trougnouf/SeniorDesign/Schematic/Sensewalk9000/FinalPCB/renders/SDMinFront.png

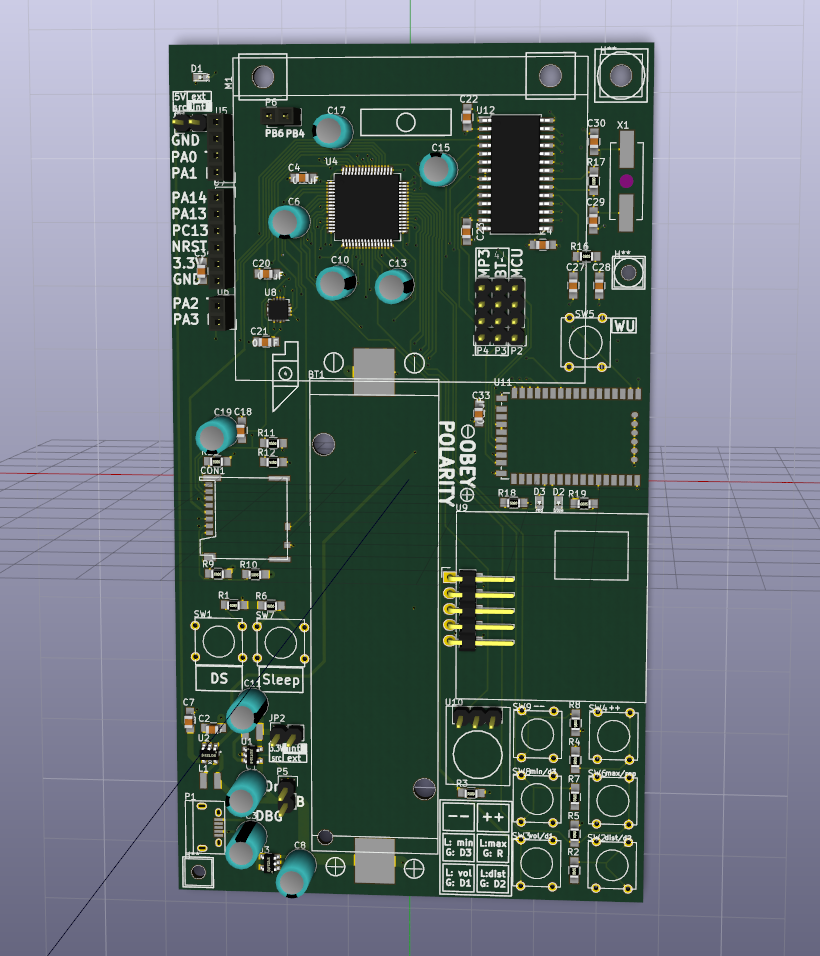
Schematic/Sensewalk9000/FinalPCB/renders/SDMinFront.png
