trougnouf/SeniorDesign/Schematic/Sensewalk9000/KiCAD/render/SDMinfinal.png

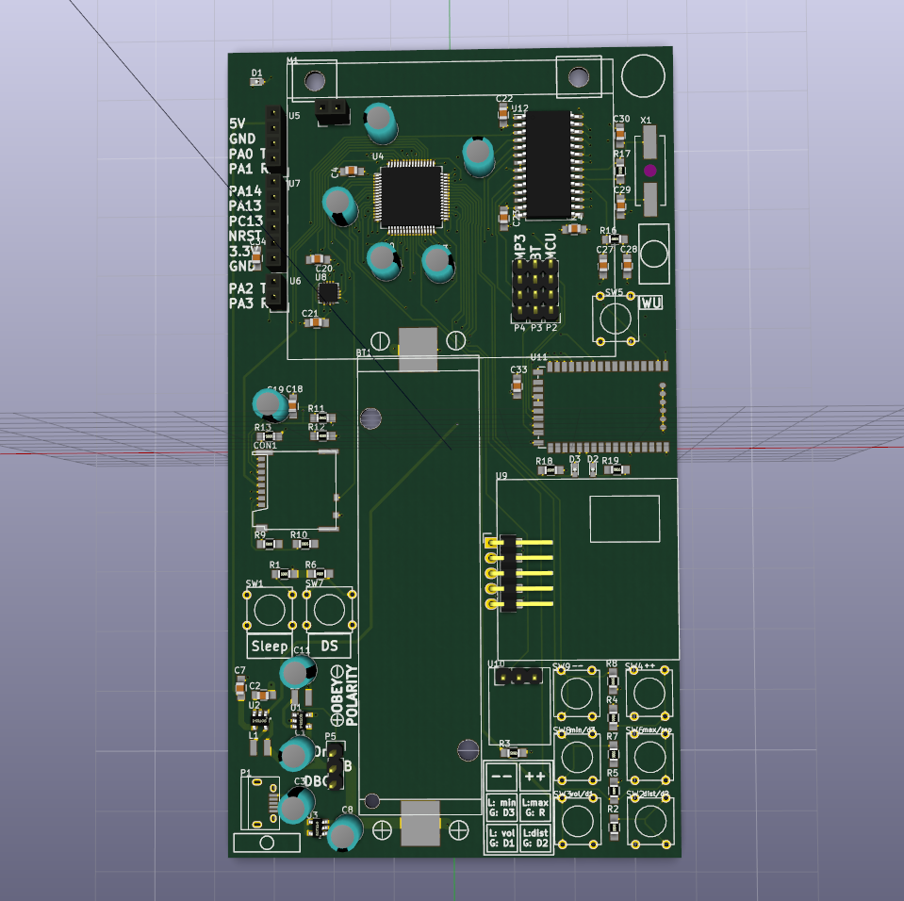
Schematic/Sensewalk9000/KiCAD/render/SDMinfinal.png
