trougnouf/SeniorDesign/Datasheets/MCU/README.txt

Installing STM32CubeMX:
# java -cp . com.izforge.izpack.installer.bootstrap.Installer
Launching STM32CubeMX:
$ cd /usr/local/STMicroelectronics/STM32Cube/STM32CubeMX/ && java -cp . 
com.st.microxplorer.maingui.IOConfigurator
