trougnouf/SeniorDesign/Schematic/Sensewalk9000/PINOUT.txt

MCU:		STMicroelectronics STM32L476RET6
Datash:	http://www.st.com/web/jp/resource/technical/document/datasheet/DM00108832.pdf
Notes:	Programming headers: See Table 8.1.1.1 in the paper
	Also needs one UART (two pin headers) for debugging
	// using the same UART as dev board: PA9 PB7 USART1)
Pinout:	{PB3, PA14, PA13, PC13,NRST}debugging, {PA2, PA3}USART2 (all female headers), {PC14, PC15, PH0, PH1, PA8, PA10, PA11, PA12}buttons/input, PB8 LED

Laser:		lightware SF10/A
Web:	http://www.lightware.co.za/shop/en/drone-altimeters/33-sf10a.html )
Notes:	MCU: UART (2pins) or i2c (fuck that), 5V power
	// Default settings: baudrate=19200, 8b
Pinout:	PA0, PA1 (all female headers)

GPS:		Sparksfun/Locosys LS20031
Web:	https://www.sparkfun.com/products/8975 )
Notes:	UART (2 pins)
Pinout:	PB7 (RX mcu/TX GPS), PA9 (TX MCU/RX GPS)

Codec:		STMicroelectronics STA013
Web:	http://www.pjrc.com/mp3/sta013.html
Notes:	
	MCU:	I2C control
			SDA
			SCL
		MP3 input
			SDI (data)
			SCKR (clock)
			DATA_REQ (ready)			GPIO
		Reset	RST					GPIO
	
	BT:	SDO (PCM Serial Data Output) to BT PCM_IN
		SCKT (PCM Serial Clock Output) to BT PCM_CLK
		LRCKT (Left/Right Channel Selection Clock) to BT PCM_SYNC
		OCLK	
	Clock:	Using 14.7456 MHz
BACKUP: Use MCU to generate audio
Pinout:	PC1 (I2C3_SDA), PC0 (I2C3_SCL), PA7 (SDI), PA5 (SCK), PA4(DATA_REQ), PB14 (RST)

Bluetooth: 	Sparksfun RN-52
Web:	https://www.sparkfun.com/products/11678
	https://www.sparkfun.com/products/12849
	https://learn.sparkfun.com/tutorials/rn-52-bluetooth-hookup-guide?_ga=1.111502852.1026932092.1454814409
Notes:	Sparksfun sells a RN-52 breakout board, they provide the Eagle files.
	When placing the breakout on a board, be sure that the antenna is hanging off the board as far as is will go.
	MCU:	UART_RTS, UART_CTS, UART_TX, UART_RX,
*		GPIO9: essential (command mode)
		optionally (but useful) GPIO7 to HIGH
		PWR_EN to HIGH
	mic:	3 (connect mic straight to MCU instead)
	misc:	optionally (useful) GPIO5 (VOL-UP active low) and GPIO10 (VOL-Down active low) connected to input button, (useless) 2 LEDs
	Codec:	SPI (4 pins) or PCM (4 pins), using PCM (see Codec above)
Pinout:	PA6 (MCU CTS / BT RTS), PC4 (MCU TX / BT RX), PC5 (MCU RX / BT TX), PB1 (MCU RTS / BT CTS), PB0 (GPIO9)

SD card:	Molex 503398-1892
Web:	https://www.digikey.com/product-detail/en/5033981892/WM11190CT-ND/5230912
Note:	See Table 6.1.11.1 in the paper
	SD 4bits wide bus
	3.3V -> 47Kohm -> {cmd,d3,d2,d1,d0}
Pinout:	PD2 (CMD), PC12 (CK), PC11 (D3), PC10 (D2), PC9 (D1), PC8 (D0), PA15 (Detect, optional)

Compass: 	Melexis MLX90393
dat:	http://www.melexis.com/Asset/MLX90393-Datasheet-DownloadLink-6427.aspx
	MCU:
		INT	GPIO
		CS
		SCLK
		MOSI
		MISO
		TRIG
		(A0/A1 to GND)
Pinout:	PC2 (MISO), PB15 (MOSI), PB10 (SCLK), PB9 (CS), PB12 (INT), PB13 (TRIG)

Microphone:	MEMS Microphone - INMP401
TODO:	check for additional circuitry req.
Web:	https://www.sparkfun.com/products/10028
	MCU: 1 analog pin (ADC)
	VDD, GND
Pinout:	PC3
