trougnouf/SeniorDesign/Schematic/Sensewalk9000/stm32cubemx/PinoutMinimal.txt

Configuration	PinoutMinimal
STM32CubeMX 	4.13.0
Date	02/07/2016
MCU	STM32L476RETx

PERIPHERALS	MODES	FUNCTIONS	PINS
ADC1	IN1 Single-ended	ADC1_IN1	PC0
I2C1	I2C	I2C1_SCL	PB6
I2C1	I2C	I2C1_SDA	PB9
SDMMC1	SD 4 bits Wide bus	SDMMC1_CK	PC12
SDMMC1	SD 4 bits Wide bus	SDMMC1_CMD	PD2
SDMMC1	SD 4 bits Wide bus	SDMMC1_D0	PC8
SDMMC1	SD 4 bits Wide bus	SDMMC1_D1	PC9
SDMMC1	SD 4 bits Wide bus	SDMMC1_D2	PC10
SDMMC1	SD 4 bits Wide bus	SDMMC1_D3	PC11
SPI1	Transmit Only Master	SPI1_MOSI	PA7
SPI1	Transmit Only Master	SPI1_SCK	PA5
SPI2	Full-Duplex Master	SPI2_MISO	PC2
SPI2	Full-Duplex Master	SPI2_MOSI	PC3
SPI2	Full-Duplex Master	SPI2_SCK	PB10
SYS	SWD and Asynchronous Trace	SYS_JTMS-SWDIO	PA13
SYS	SWD and Asynchronous Trace	SYS_JTCK-SWCLK	PA14
SYS	SWD and Asynchronous Trace	SYS_JTDO-SWO	PB3
SYS	SYS-WakeUp2	SYS_WKUP2	PC13
SYS	SysTick	SYS_VS_Systick	VP_SYS_VS_Systick
UART4	Asynchronous	UART4_RX	PA1
UART4	Asynchronous	UART4_TX	PA0
USART1	Asynchronous	USART1_RX	PB7
USART1	Asynchronous	USART1_TX	PA9
USART2	Asynchronous	USART2_RX	PA3
USART2	Asynchronous	USART2_TX	PA2
USART3	Asynchronous	USART3_RX	PC5
USART3	Asynchronous	USART3_TX	PC4
USART3	CTS/RTS	USART3_CTS	PA6
USART3	CTS/RTS	USART3_RTS	PB1

Pin Nb	PINs	FUNCTIONs	LABELs
2	PC13	SYS_WKUP2	
3	PC14/OSC32_IN	GPIO_Input	
4	PC15/OSC32_OUT	GPIO_Input	
5	PH0/OSC_IN	GPIO_Input	
6	PH1/OSC_OUT	GPIO_Input	
8	PC0	ADC1_IN1	ADC1_IN1_Mic
10	PC2	SPI2_MISO	SPI2_MISO_Compass
11	PC3	SPI2_MOSI	SPI2_MOSI_Compass
14	PA0	UART4_TX	UART4_TX_Laser
15	PA1	UART4_RX	UART4_RX_Laser
16	PA2	USART2_TX	USART2_TX_PC
17	PA3	USART2_RX	USART2_RX_PC
20	PA4	GPIO_Input	DATA_REQ_Codec
21	PA5	SPI1_SCK	SPI1_SCK_Codec
22	PA6	USART3_CTS	USART3_CTS_BT
23	PA7	SPI1_MOSI	SPI1_MOSI_Codec
24	PC4	USART3_TX	USART3_TX_BT
25	PC5	USART3_RX	USART3_RX_BT
26	PB0	GPIO_Output	GPIO9_BT
27	PB1	USART3_RTS	USART3_RTS_BT
29	PB10	SPI2_SCK	SPI2_SCK_Compass
33	PB12	GPIO_Input	INT1_Compass
34	PB13	GPIO_Input	INT2_Compass
35	PB14	GPIO_Output	RST_Codec
39	PC8	SDMMC1_D0	
40	PC9	SDMMC1_D1	
41	PA8	GPIO_Input	
42	PA9	USART1_TX	USART1_TX_GPS
43	PA10	GPIO_Input	
44	PA11	GPIO_Input	
45	PA12	GPIO_Input	
46	PA13	SYS_JTMS-SWDIO	
49	PA14	SYS_JTCK-SWCLK	
50	PA15	GPIO_Input	SDMMC1_Detect
51	PC10	SDMMC1_D2	
52	PC11	SDMMC1_D3	
53	PC12	SDMMC1_CK	
54	PD2	SDMMC1_CMD	
55	PB3	SYS_JTDO-SWO	
58	PB6	I2C1_SCL	I2C1_SCL_Codec
59	PB7	USART1_RX	USART1_RX_GPS
62	PB9	I2C1_SDA	I2C1_SDA_Codec

SOFTWARE PROJECT

Project Settings : 
Project Name : PinoutMinimal
Project Folder : /orb/Dev/SeniorDesign/Schematic/Minimal/PinoutMinimal
Toolchain / IDE : SW4STM32
Firmware Package Name and Version : STM32Cube FW_L4 V1.3.0

Code Generation Settings : 
STM32Cube Firmware Library Package : Copy all used libraries into the project folder
Generate peripheral initialization as a pair of '.c/.h' files per IP : No
Backup previously generated files when re-generating : No
Delete previously generated files when not re-generated : Yes
Set all free pins as analog (to optimize the power consumption) : No

Toolchains Settings : 
Compiler Optimizations : Balanced Size/Speed
