trougnouf/SeniorDesign/Documentation/2016-02-12-Presentation/SDCP.odt

# SenseWalk 2.0

Ross Applegate, Chad Borgelin, Benoit Brummer, and Diego Merida

### Dept. of Electrical Engineering and Computer Science, University of Central Florida, Orlando, Florida, 32816-2450

Abstract — Everyday, engineers focus on ways of improving the quality of living for everyone around them. Whether it’s improving transportation, creating new and safer energy resources, or designing more efficient ways to complete a task, their goal is to establish something that will be both innovative and of practical use for everyone. This paper’s primary focus is on the application of creating a device that will benefit those who are classified as visually impaired. While there are devices that target this niche of people, none has the capability of greatly reducing the user’s need to depend on someone else. The goal of this device is to greatly enhance the independency of the users, while providing them support to navigate around safely and efficiently.

### Index Terms — Lasers

### I. Introduction

Detailed analysis of the research, design, coding, and testing procedures related to the navigation system for the visually impaired is thoroughly provided. The project description includes goals, motivators, and hardware and software system specifications. The foundation for the mission statement of this design is to aid the visually impaired with their travel on a daily basis. The cane is an alternative to seeing-eye dogs or personal assistants, as it doesn’t compromise independent mobility. It allows the individual to blend into society with little assistance or help from others. With a cane, they are able to be independent and not rely on others for their everyday needs. However, danger is still prevalent in the person’s inability to distinguish between safe paths and hazardous paths, thus presenting the opportunity for the cane to be perfected by modern-day technology. Many people in their day-to-day lives have a typical, established routine that may include routes going from home to work or going from one classroom to another.

For those that are visually impaired and use a cane, it would be deemed useful to have a device which stores some of their frequently used routes. The GPS in SenseWalk 2.0 will keep track of the user as they go about a certain route that they have selected and instructions transmitted will notify the user constantly of where they currently are and what direction they need to impart soon. Even when the option of using a stored route is not selected, the GPS can help the user in keeping them informed of their current whereabouts by announcing approaching streets and intersections. The GPS will need to use a software that offers access to maps and geographical points in order to configure routes and pinpoint the user's location in real-time.

### II. Microcontroller

We chose the STMicroelectronics STM32 F7 microcontroller because it is the most affordable of only two Cortex-M7 microcontrollers available at the time of our research.

The Cortex-M7 series can run at speeds of up to 300 MHz. The current STM32 F7 has a clock speed of 216 MHz, it contains an FPU and can interface with external SDRAM memory. This allows it to bridge the performance gap between microcontrollers and microprocessors, allowing us in theory to perform computer vision on a microcontroller.

The STM32 series MCUs can be programmed with a $20 STLinkV2 in-circuit debugger/programmer, and development boards cost range from $10 to $50. All development can be performed using free and open-source software, specifically the GCC compiler, GDB debugger, and OpenOCD on-chip debugger. These software are all prepackaged by STMicroelectronics in a ready-to-use Eclipse plugin called OpenSTM32.

SDRAM and flash were not incorporated into the final design, therefore SenseWalk 2 is physically incompatible with voice recognition and computer vision. A simpler alternative board, Sensewalk 9000, was created with a lower-performance microcontroller, the ultra-low-power 80MHz STMicroelectronics STM32 L4. SenseWalk 9000 runs off a replaceable 18650 battery and charges from a standard micro-USB port.

### III. Audio Subsystem

Information is transmitted to the user through a Bluetooth headset. To achieve this, an audio file stored on the SD card is read by the microcontroller, the compressed audio is transferred to a hardware MP3 decoder, which then sends a raw audio waveform to the bluetooth module.

The STMicroelectronics STA013 MPEG 2.5 audio decoder was chosen because it is widely available, well-documented, and comes in an easy to prototype 28-SO package. The STA013 uses I2C to communicate with the microcontroller, SPI to receive compressed audio files, and I2S to send out decompressed audio.

Alternatively, the Sensewalk 9000 features a series of jumpers which can be used to switch between using an external hardware decoder, or processing the audio in software and sending it directly from the microcontroller to the Bluetooth module. Generating an I2S signal on the microcontroller involves more complicated software, but it comes with a significant cost-benefit (~$12). The power implication of doing software audio decoding remains unknown until further testing can be done. The microcontroller would use more power while performing such heavy computations, but the processing cost may be lower than that added by powering an external ASIC.

### IV. Filesystem

The filesystem is used by all subsystems. The GPS first reads all directions from a text-file which is then saved in memory. Both the laser and the GPS read compressed sound files that are then sent to the user as audio feedback.

All information is stored on a Micro-SD card using the Fat32 file-system which allows for easy modification from most computers. The open-source FatFs driver is used along with an SDIO physical interface (1-bit wide on SW2, 4-bit bus on SW9000).

### V. Bluetooth Communication

Bluetooth transmission plays an integral role in communicating directions from the device to the user. It is the gateway that will relate information given from the user’s command to the device, then the response from the device back to the user. It will be required of the controller to obtain instructions from the GPS and transmit the set of instructions on a given route into an audio signal for the user to receive and hear through their headset.

A range of up to 10 meters with a Class 1 device is needed, since the proximity between the user and the device is very small (the cane will be in their hands at all times during use). Bluetooth uses a radio frequency that operates on the 2.4 GHz unlicensed (industrial, scientific, and medical) ISM band of radio frequencies.

This permits the console to communicate with many possible Bluetooth-enabled devices if necessary. Typically, a Bluetooth device can establish a connection with up to 8 devices all at the same time. This means that any Bluetooth-capable headset should be able to effortlessly interface with the cane.

VI. Distance Detection

One of the main goals from the previous version of the device was to improve most of technologies implemented on it and the most important features for a visually impaired is the feature of obstacle detection, for this reason we will analyze several technologies and compare them in order to use buy the sensor that will meet and surpass all the requirement for SenseWalk 2.0. There are many types of sensor out there in the market and selecting the right sensor is very important but a very difficult task.

One of the main key sub-systems which SenseWalk2.0 implements, is an object proximity detection system. It is designed to be very helpful for the visually impaired user to have access to information relating to approaching or stationary objects within the user's walking path. Because SenseWalk 2.0 users are unable to visually observe approaching objects, SenseWalk 2.0 detects this information and audibly relays it to the user through Bluetooth.

VII. GPS

The heart of the project is the GPS since this component will receive the user’s current position and measure the distance and direction to the next point, this is why the GPS module selection was essential. An appropriate module was chosen in order to ensure all “SenseWalk” requirements were met or exceeded. Proper selection between GPS cards guaranteed that accurate, reliable data is being received that can be read on the microcontroller. GPS connection with the satellites is known to weaken when inside buildings or as one gets closer to a building but the module locosys ls 20031 offers 66 channels which is pretty helpful to get signal faster in the circumstances mentioned above. This means that whatever routes the user chooses to load, they must be situated outdoors. As a user enters a building,GPS connection will be lost and will be reset once they return outdoors.

VIII. Magnetometer

The use of GPS in SenseWalk 2.0 requires the need for a compass to help in the navigation of the user. Without a compass, the orientation and direction the user is facing would be unknown to the device and could potentially cause errors in real-time direction and decision making. In order to know what direction the user is facing we need to implement a compass module or a magnetometer into the project. The earth is like a giant magnet with a north and a south pole and it has a magnetic field all around it.

The strength of the magnetic field will vary with location and orientation. The way a compass module works is by detecting the earth’s natural magnetic field, the earth has an iron core that is part liquid and part solid crystal due to the gravitational pressure and the movements in the liquid outer core is what produces the Earth’s magnetic field. The module that will measure the magnetic field in three directions or axes, labeled as X, Y, Z.

We use the Melexis MLX90393 magnetometer because it comes in a QFN16 3x3mm package and offers both an SPI and I2C interface. This made it easier to prototype and implement than competing models which typically have a 0.4mm pitch (as opposed to 0.5mm) and lack SPI connectivity.

IX. Power

SenseWalk 2.0 required DC-DC linear and switching regulators and also an AC-DC switching converter. All DC-DC regulators convert the input voltage from the lithium ion battery to the required output voltage. There were a couple different options in the charging aspect ultimately allowing the solar to run simultaneously with DC-DC charging system is what was chosen. Allowing them to run at the same time allowed for a simpler circuit design with less parts. The (BQ24123) is the DC-DC charging circuit. The BQ25504 is a power management board where it allows two different inputs to be regulated.

There were a few factors in picking a battery, which included the weight of the battery and length of run time. Light weight batteries with a long run time are good, but only in the short term. It was preferred to utilize heavy bulky types of batteries which provides a long run time, as well as a good overall life cycle. Ultimately we found the best of both worlds with a lithium ion battery. Lithium batteries are lightweight and high efficiency, but with that comes a higher price tag.

SenseWalk 2.0 operates on a rechargeable type battery. This required an AC-DC converter to recharge the battery which will be bought; also this required a DC-DC converter to regulate the battery voltage to the required load voltage. Below is the design schematic of the DC-DC charger.

The device also has a solar panel integrated on it, in order to help keep the device charged while it is in use, this will reduce the need for the user to search for a power outlet; a task which can be very challenging for the visually impaired.

X. Standards

With the large increase in global population, energy demands are at an all-time high. The number of electronics per person has also largely increased. With the increase in power demand and a limited supply of power generation, efficient electronics have become a necessity. Governments and green environmental organizations have established energy efficiency standards.

ENERGY STAR has become the largest most recognized international standard for energy efficient consumer products. The standard originated in the United States in 1992 when it was created by the Environmental Protection Agency and the Department of Energy. Depending on the specific device, there are standard requirements for a consumer product to be labeled with the ENERGY STAR mark. A specific set of guidelines and requirements has been constructed in order for an AC-DC power supply to be labeled with the ENERGY STAR mark. A full chart of Energy-Efficiency requirements can be found at http://www.energystar.gov/.

Bluetooth uses the Industrial Scientific and Medical (ISM) band, which is free to use in most countries. The regulators expect lots of devices to be using the same spectrum, so they have set out rules for using ISM bandwidth to make sure that devices can share the bandwidth.

The rules state that you must spread the power of your transmissions across the ISM band somehow. Two main methods are used for spreading out the power: direct sequence spread spectrum (DSSS) and frequency-hopping spread spectrum.

Direct sequence spread spectrum smears a transmission across a wide range of frequencies at low power. Frequency-hopping spread spectrum uses a small bandwidth but changes (or hops) frequency after each packet. Bluetooth uses frequency-hopping spread spectrum. There are 79 channels of 1 MHz each; after each transmit or receive, devices hop to a new channel.

### Acknowledgement

The authors would like to acknowledge the support and guidance of Dr. Samuel Richie and Dr. Lei Wei, first and foremost, for the extreme lengths he has gone to in educating and guiding our research and meeting with the group to from time to time to keep track of overall progress and group resolve.

We also extend thanks to Boeing and Leidos for the funding and amazing support to help create the SenseWalk 2.0 device, as well as their generous and continued support of engineering at the University of Central Florida in general.

And lastly, we offer our thanks and gratitude to the professors who have so kindly agreed to ta

ke time out of their busy schedule in order to review our project, which we have so diligently worked hard on.

### Biography

Ross Applegate is currently a senior at the University of Central Florida. He plans to graduate with his Bachelor’s of Science in Electrical Engineering in May of 2016.

Chad Borgelin is currently a senior at the University of Central Florida. He plans to graduate with his Bachelor’s of Science in Computer Engineering in May of 2016. He plans to potentially attend the University of Central Florida for his graduate studies in Master of Business Administration (MBA).

Benoit Brummer is currently a senior at the University of Central Florida. He plans to graduate with his Bachelor’s of Science in Computer Engineering in May of 2016 and pursue a MS CS in Belgium. Benoit currently enjoys working with embedded systems and artificial intelligence. He will one day start the trougnouf company.

Diego Merida is currently a senior at the University of Central Florida. He plans to graduate with his Bachelor’s of Science in Computer Engineering in May of 2016. He plans to attend the University of Central Florida for graduate studies in the field of Computer Networks and Computer Security
