trougnouf/SeniorDesign/Documentation/2016-04-21-board/SenseWalk_2-schematic.pdf

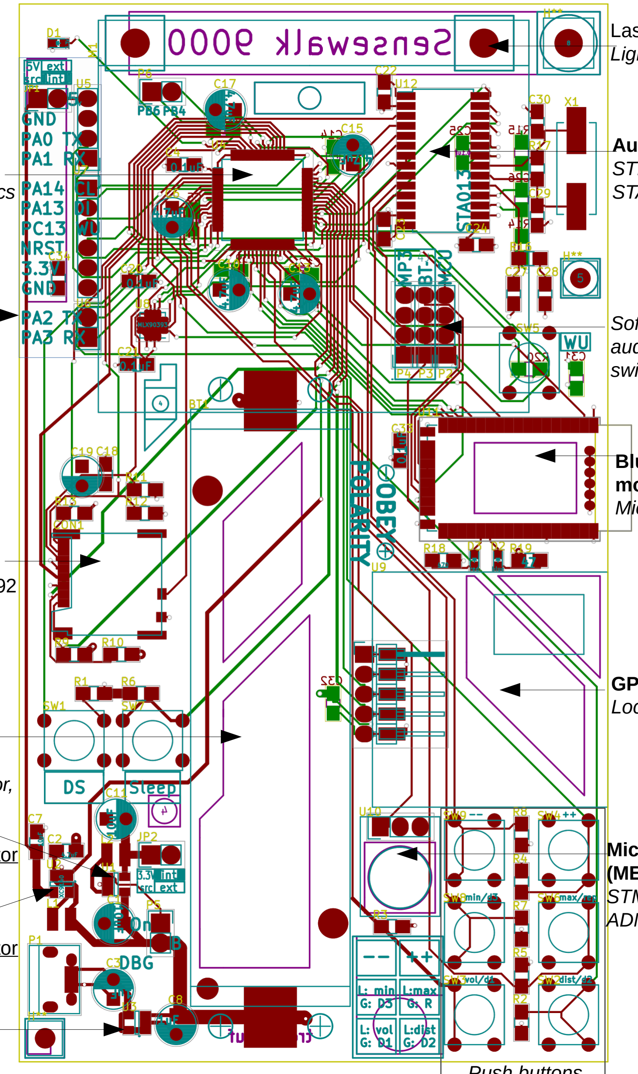
[picture p32: figure]

Laser / mount
LightWare SF10-A

Software/hardware
audio decoder
switch

Bluetooth 3.0
module
Microchip RN52

GPS module
Locosys LS20031

Push buttons

Microphone
(MEMS)
STMicroelectronics
ADMP401

Programming
/debugging
headers

Power
subsystem
Lithium-ion
rechargeable
battery
18650 form-factor,
user-replaceable
3.3V DC-DC
switching regulator
Diodes Inc.
PAM2301
5V DC-DC
switching regulator
Skyworks
AAT1217
Battery
management
(USB charger)
Microchip
MCP73811

# Sensewalk 9000 PCB layout

Microcontroller
STMicroelectronics
STM32L476

MicroSD socket
Molex 5033981892

Audio decoder
STMicroelectronics
STA013
