trougnouf/SeniorDesign/Documentation/2016-04-21-board/SenseWalk_2-software.pdf

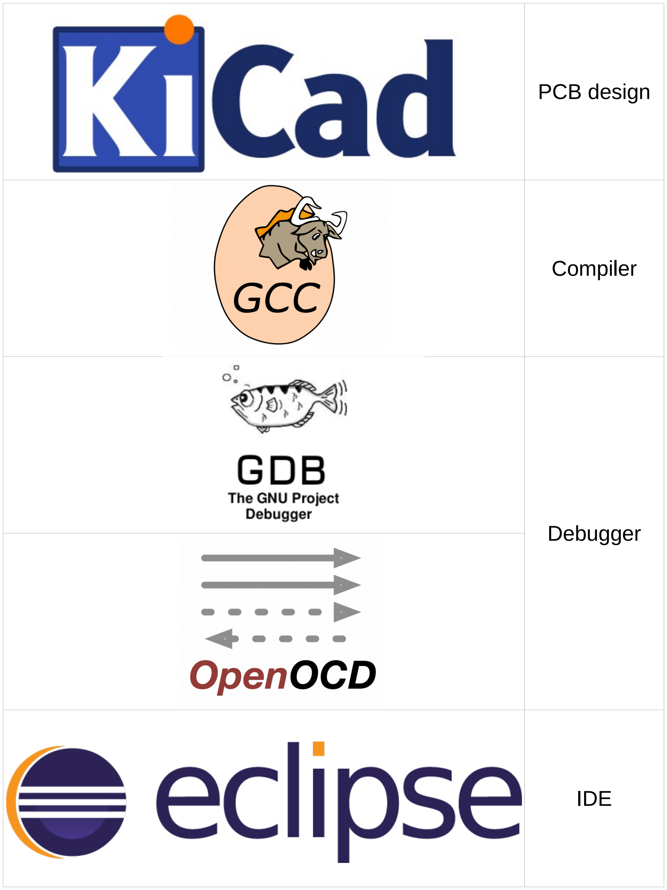
[picture p35: page 1]

PCB design

Compiler

Debugger

IDE
