trougnouf/SeniorDesign/Data/Compass/misc/misc/tek00000.png

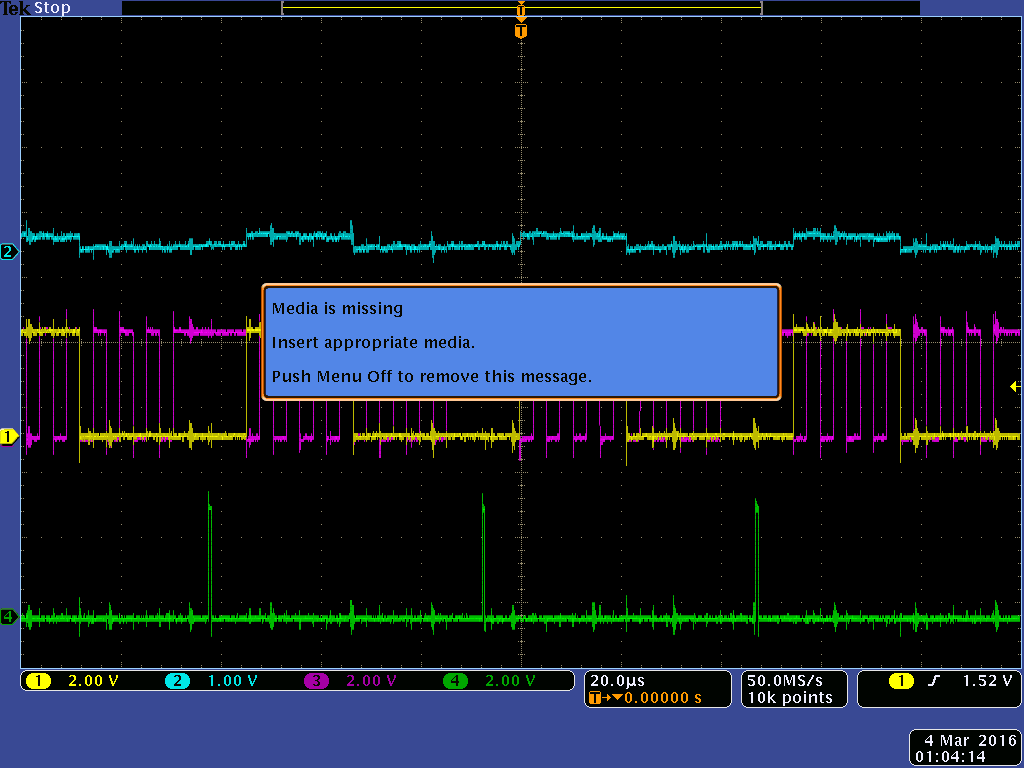
Data/Compass/misc/misc/tek00000.png
