trougnouf/SeniorDesign/Data/Compass/misc/misc/tek00003.png

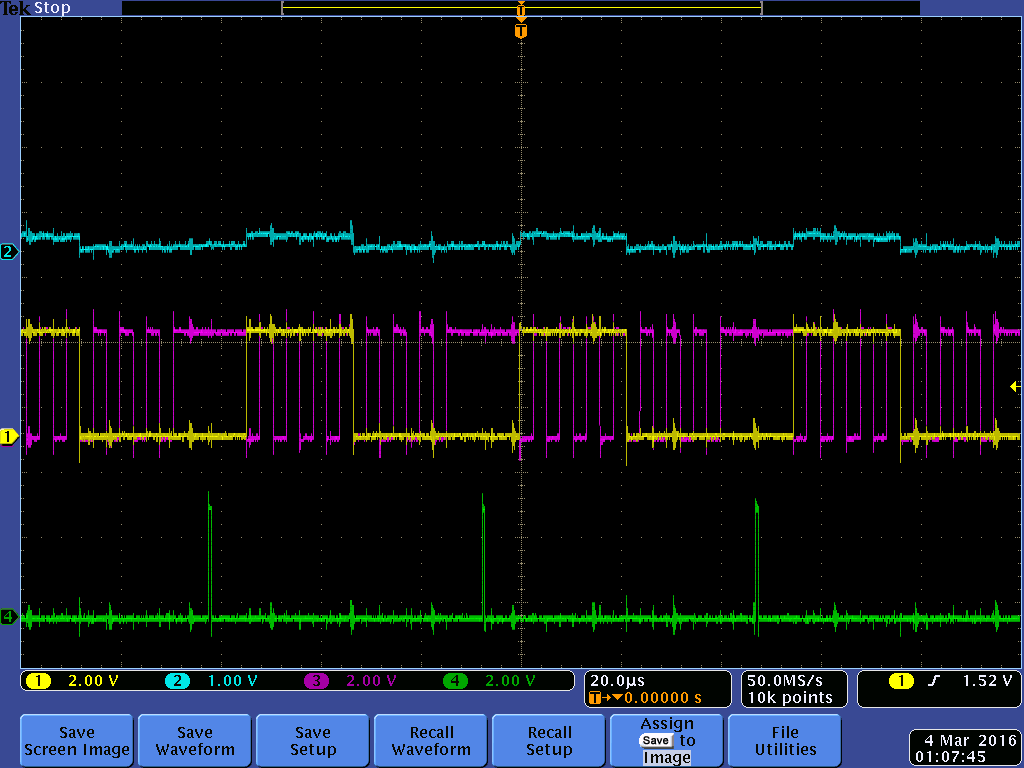
Data/Compass/misc/misc/tek00003.png
