trougnouf/SeniorDesign/Data/Compass/misc/misc/tek00004.png

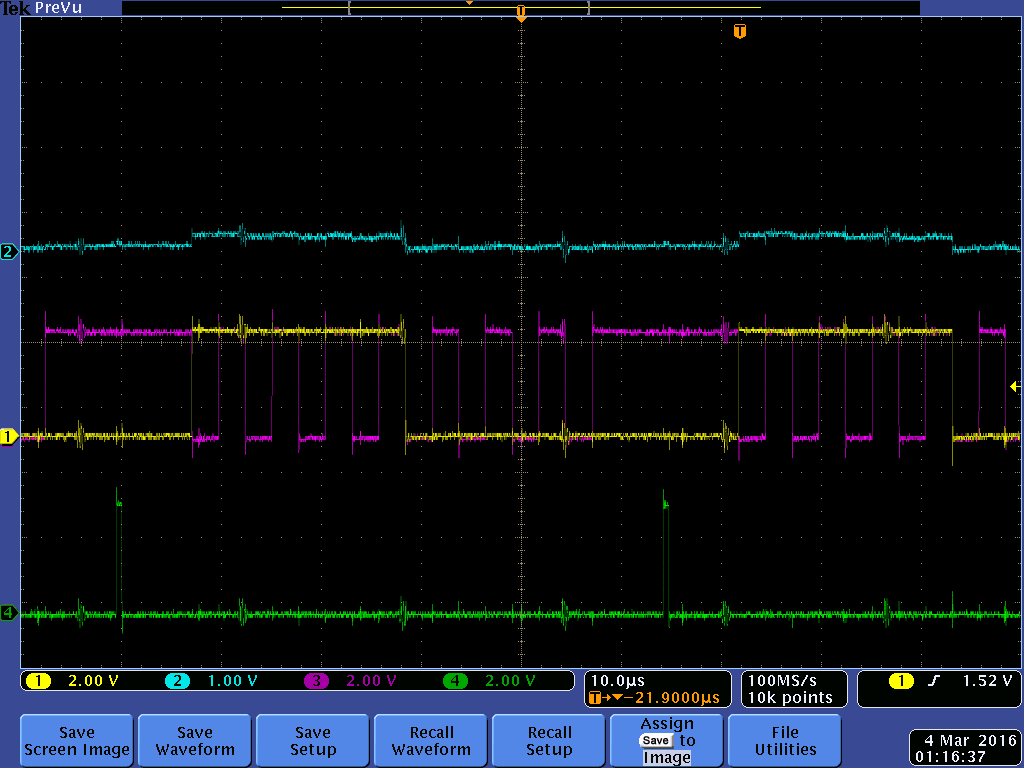
Data/Compass/misc/misc/tek00004.png
