trougnouf/SeniorDesign/Data/Compass/misc/misc/tek00005.png

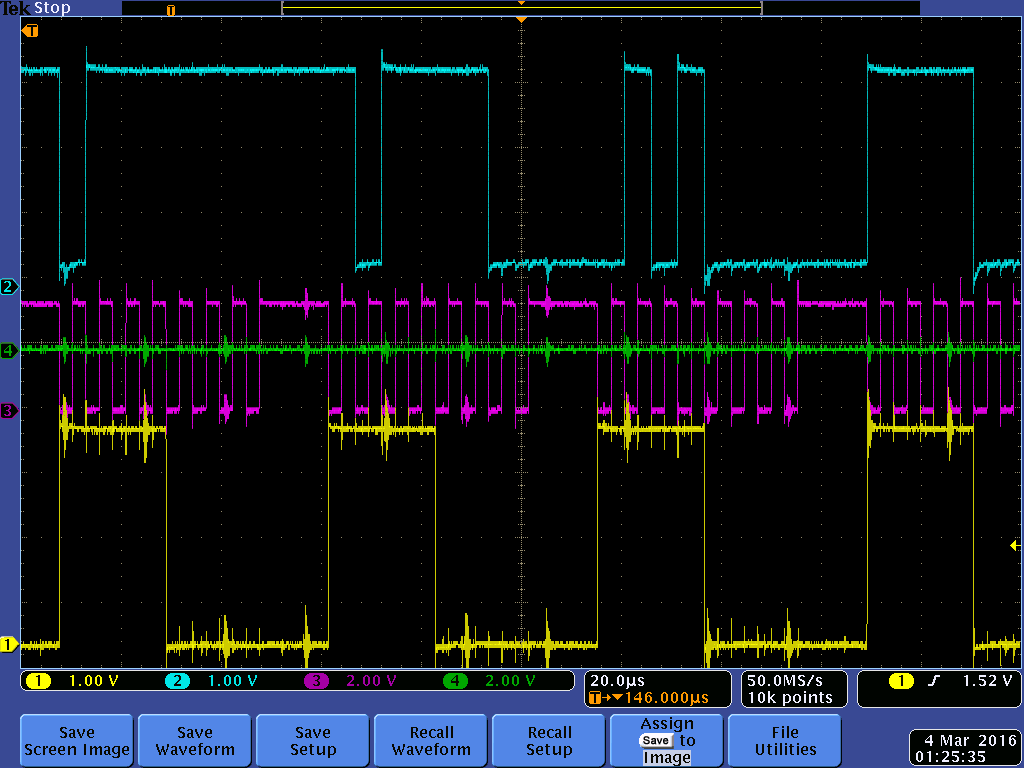
Data/Compass/misc/misc/tek00005.png
