trougnouf/SeniorDesign/Data/Compass/misc/misc/tek00006.png

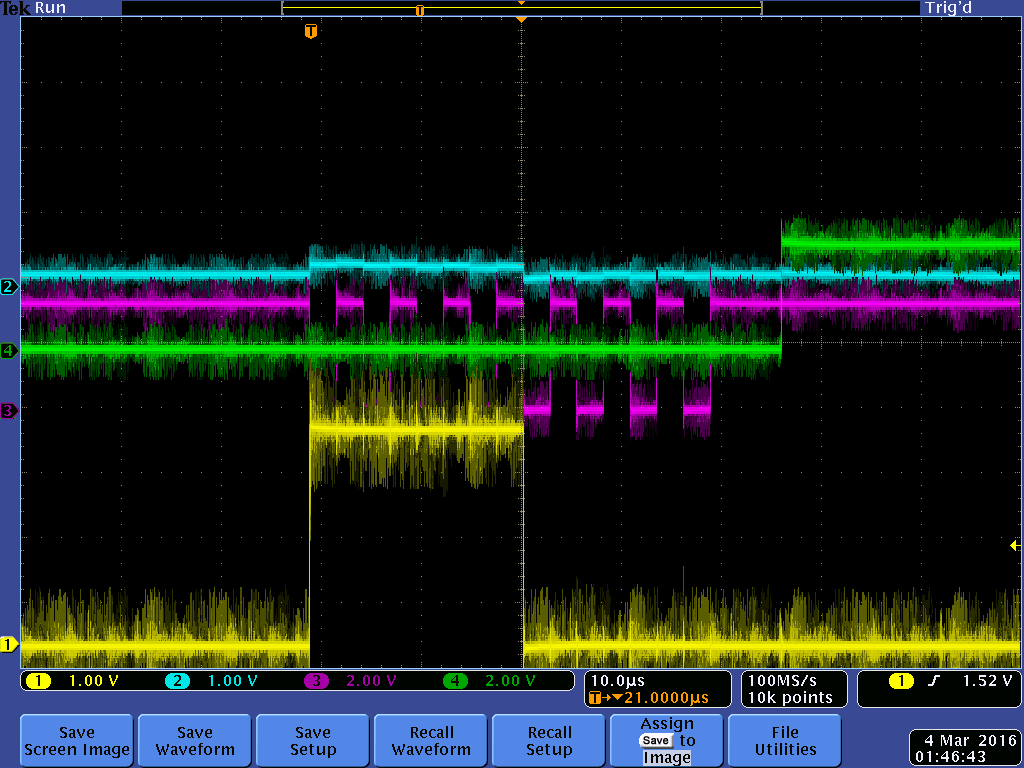
Data/Compass/misc/misc/tek00006.png
