trougnouf/SeniorDesign/Data/Compass/misc/misc/tek00007.png

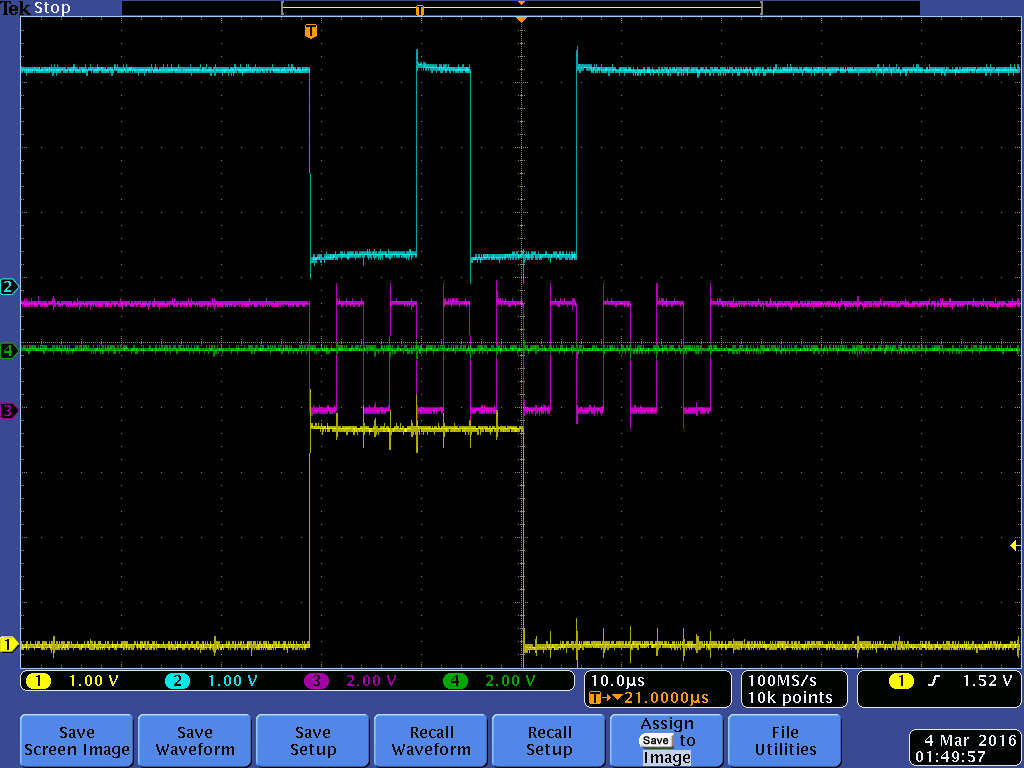
Data/Compass/misc/misc/tek00007.png
