trougnouf/SeniorDesign/Data/Compass/misc/misc/tek00008.png

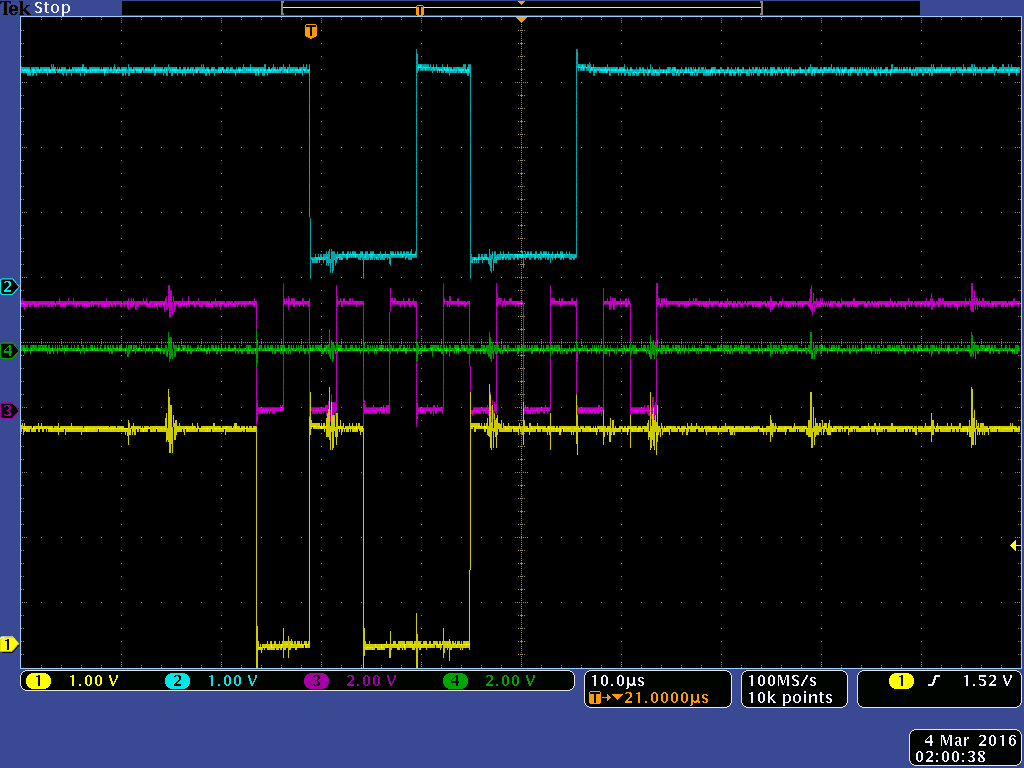
Data/Compass/misc/misc/tek00008.png
