trougnouf/SeniorDesign/Data/Compass/misc/misc/tek00009.png

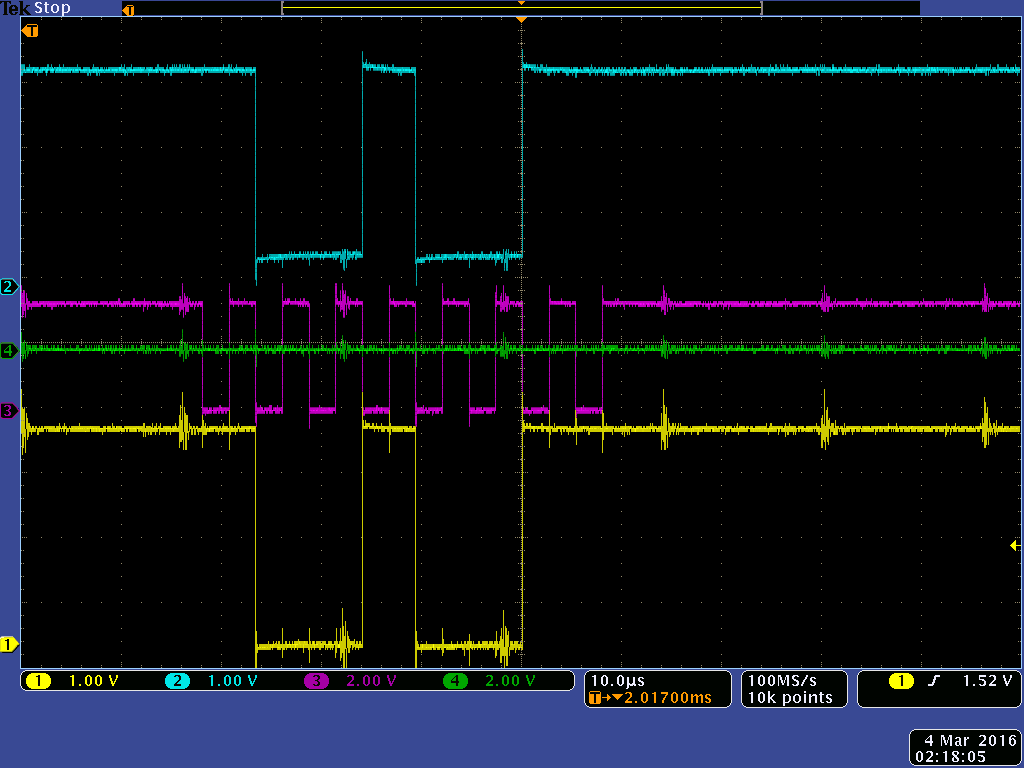
Data/Compass/misc/misc/tek00009.png
