trougnouf/SeniorDesign/Data/Compass/misc/misc/tek00010.png

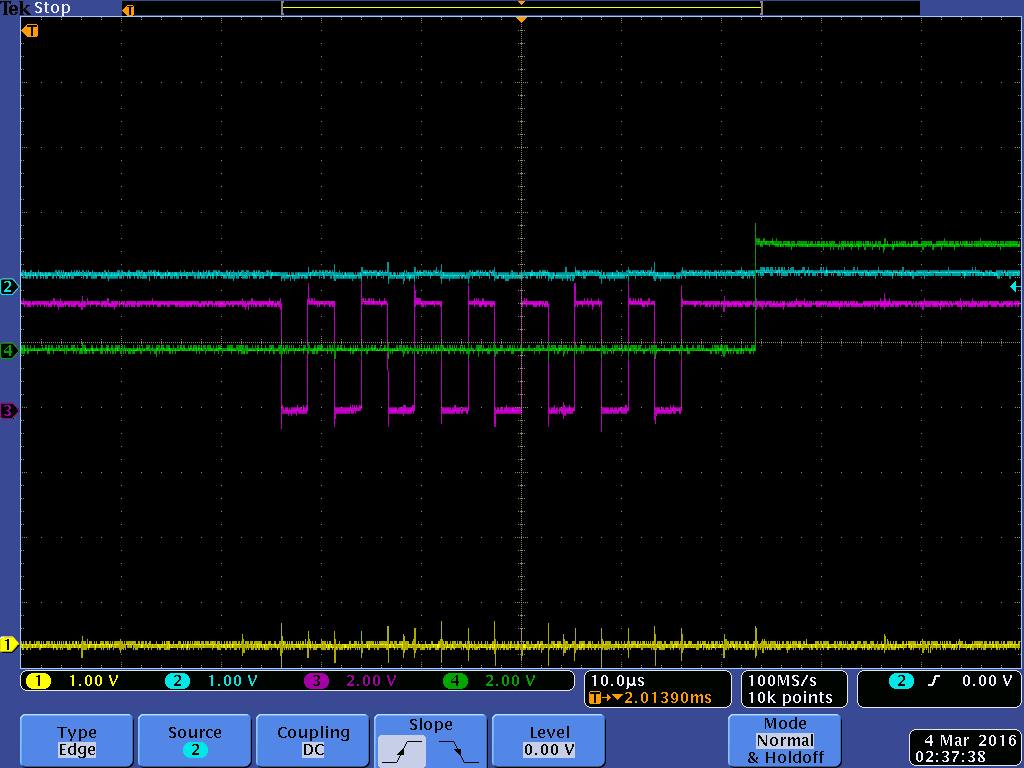
Data/Compass/misc/misc/tek00010.png
