trougnouf/SeniorDesign/Data/Compass/misc/misc/tek00011.png

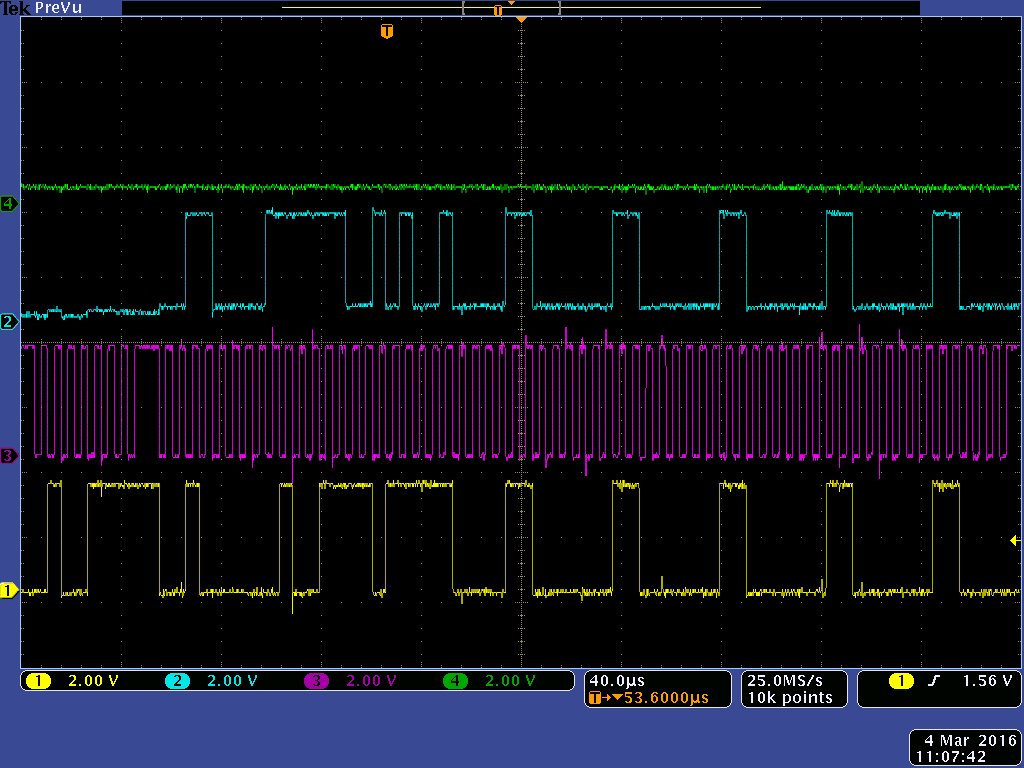
Data/Compass/misc/misc/tek00011.png
