trougnouf/SeniorDesign/Data/Compass/misc/misc/tek00012.png

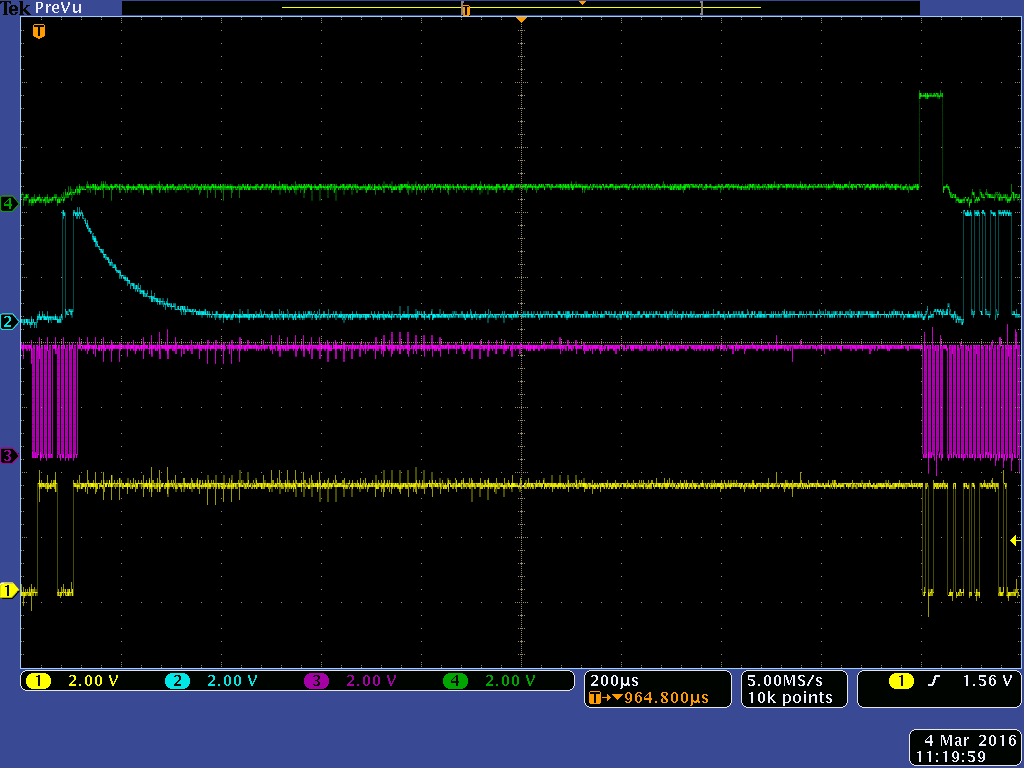
Data/Compass/misc/misc/tek00012.png
