trougnouf/SeniorDesign/Data/Compass/misc/misc/tek00014.png

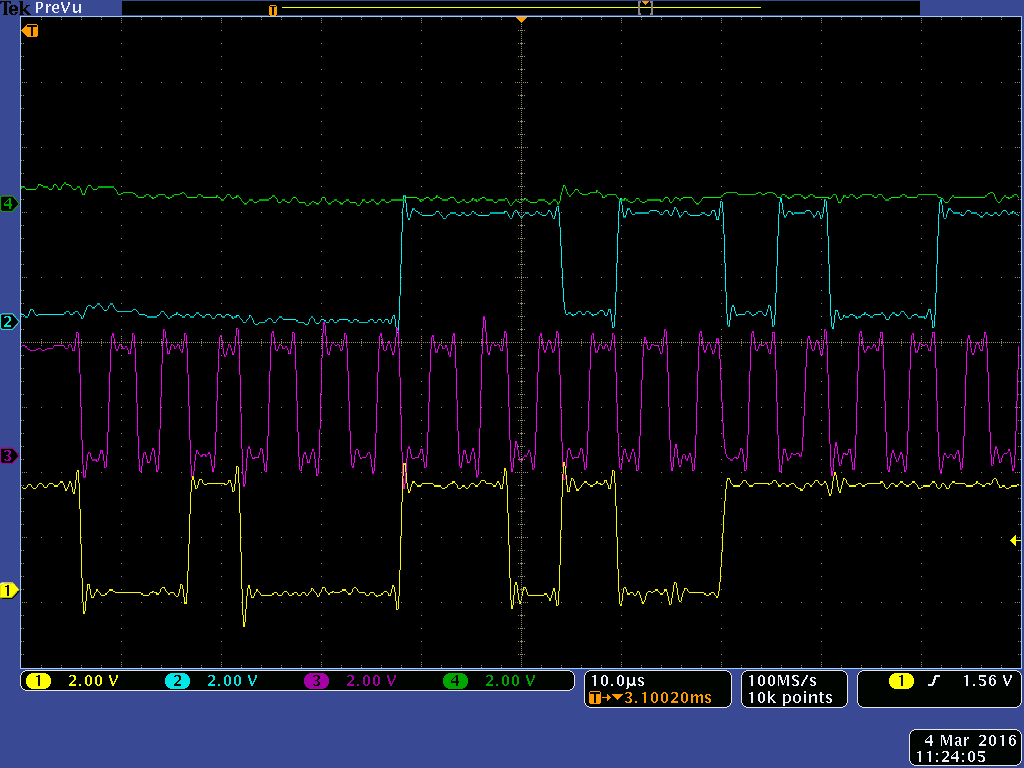
Data/Compass/misc/misc/tek00014.png
