trougnouf/SeniorDesign/Data/Compass/misc/misc/tek00015.png

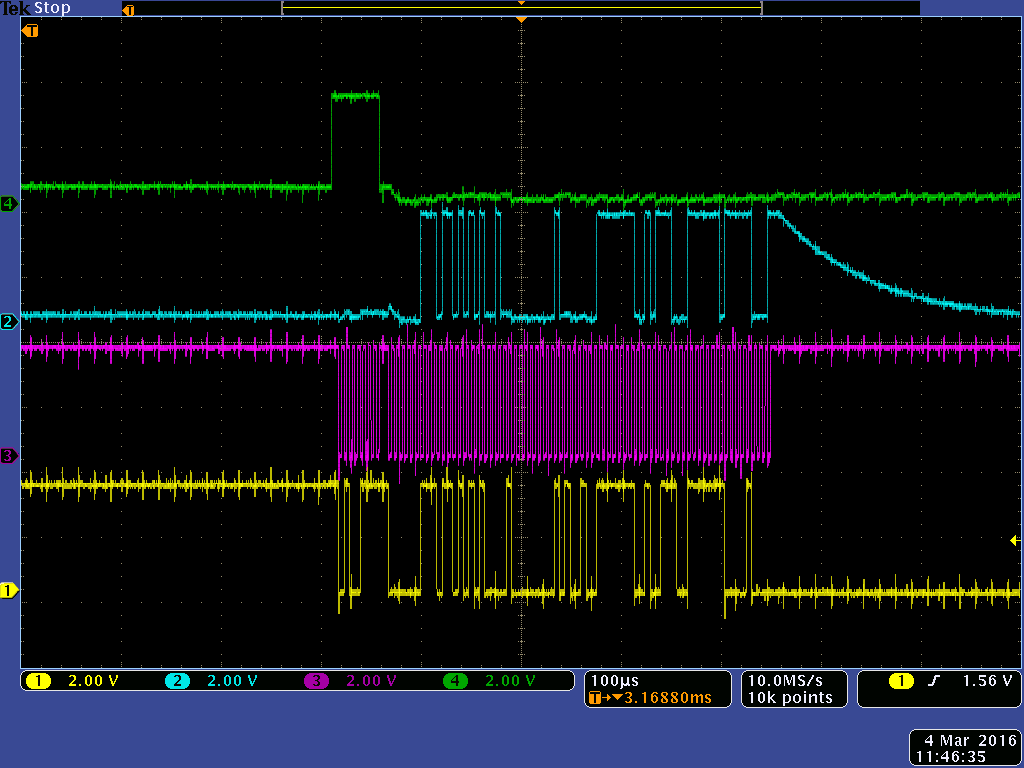
Data/Compass/misc/misc/tek00015.png
