trougnouf/SeniorDesign/Data/Compass/misc/misc/tek00016.png

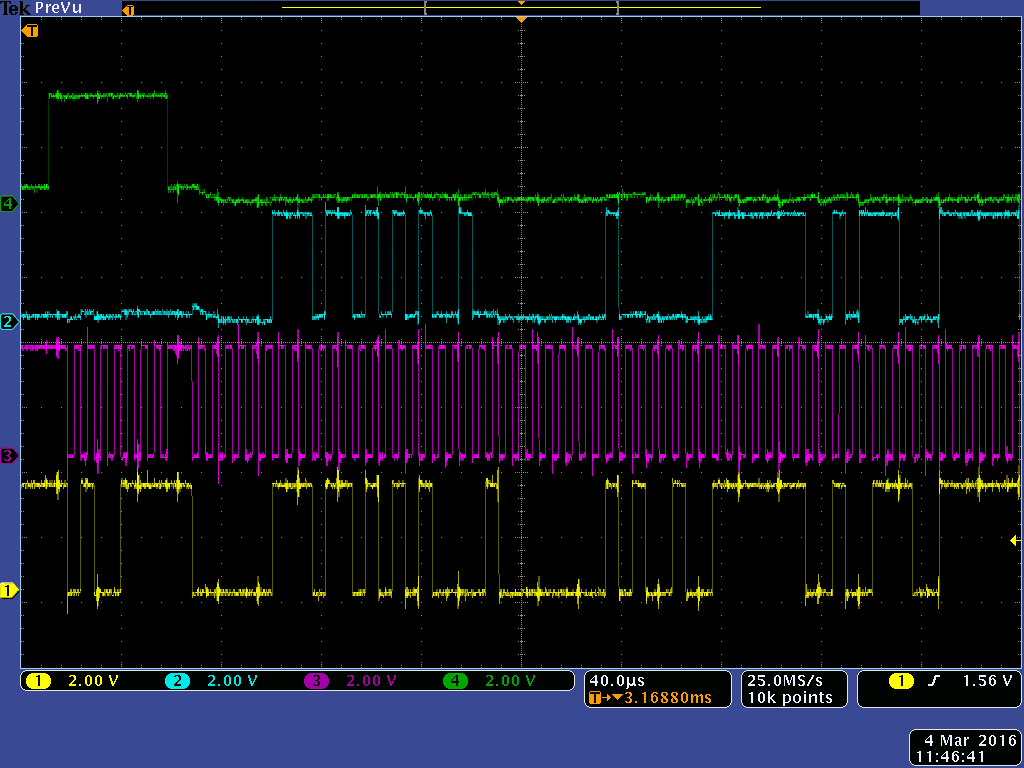
Data/Compass/misc/misc/tek00016.png
