trougnouf/SeniorDesign/Data/Compass/misc/misc/tek00017.png

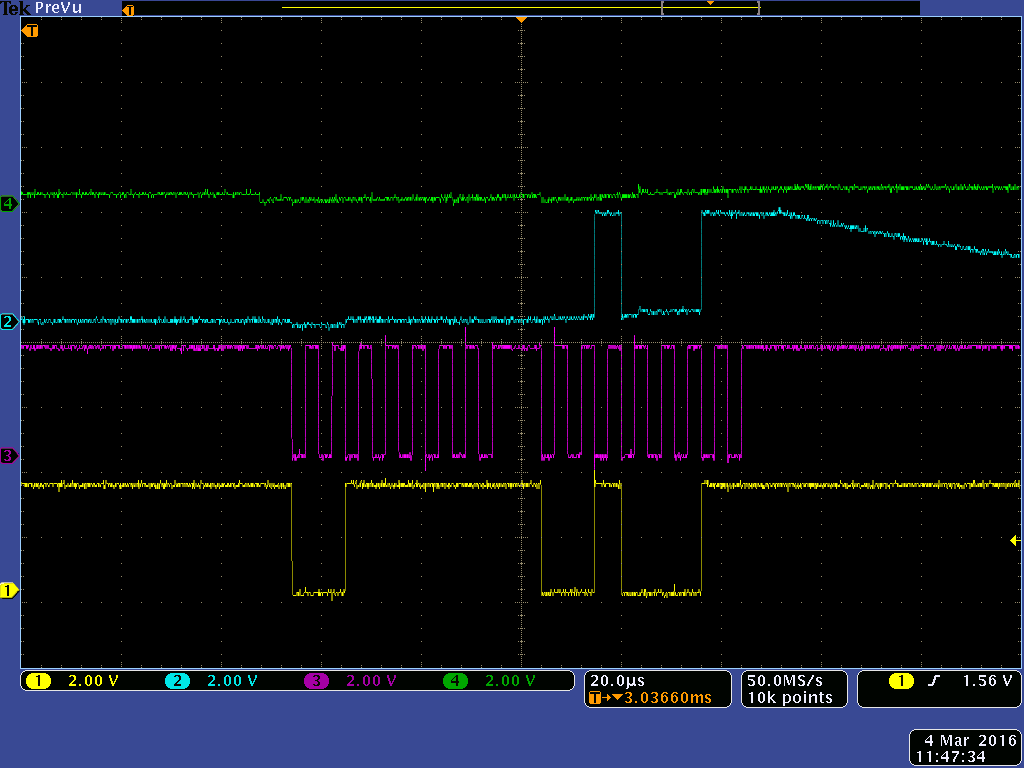
Data/Compass/misc/misc/tek00017.png
