trougnouf/SeniorDesign/Data/Compass/tek00002.png

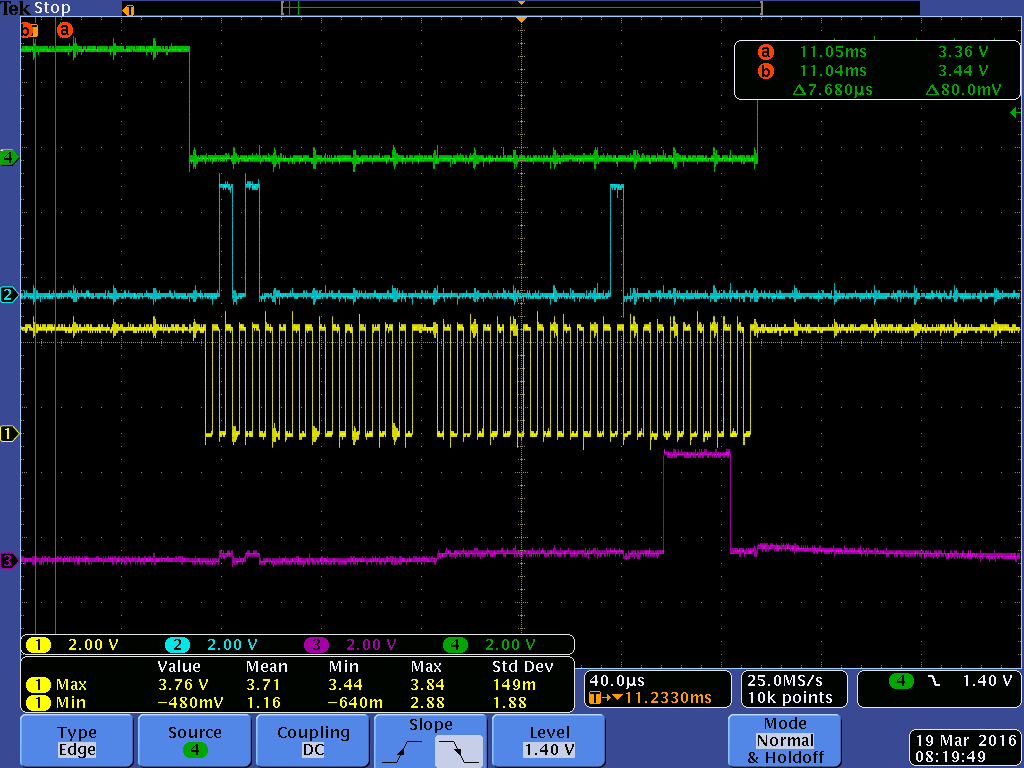
Data/Compass/tek00002.png
