trougnouf/SeniorDesign/Data/Compass/tek00003.png

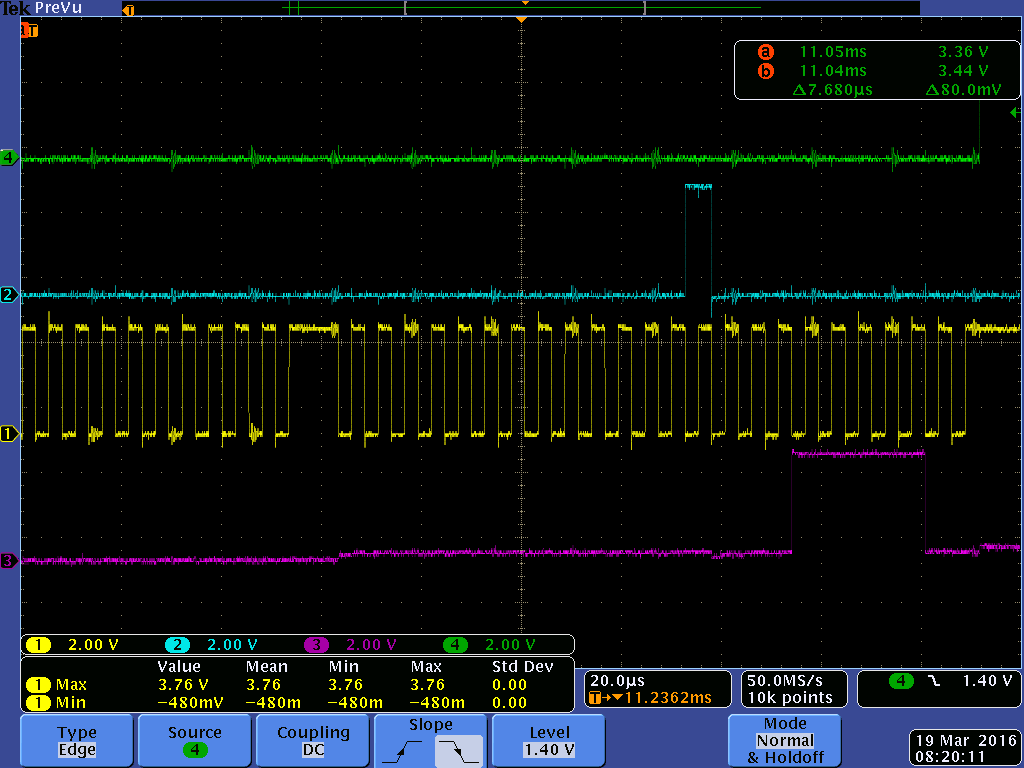
Data/Compass/tek00003.png
