trougnouf/SeniorDesign/Data/Compass/tek00004.png

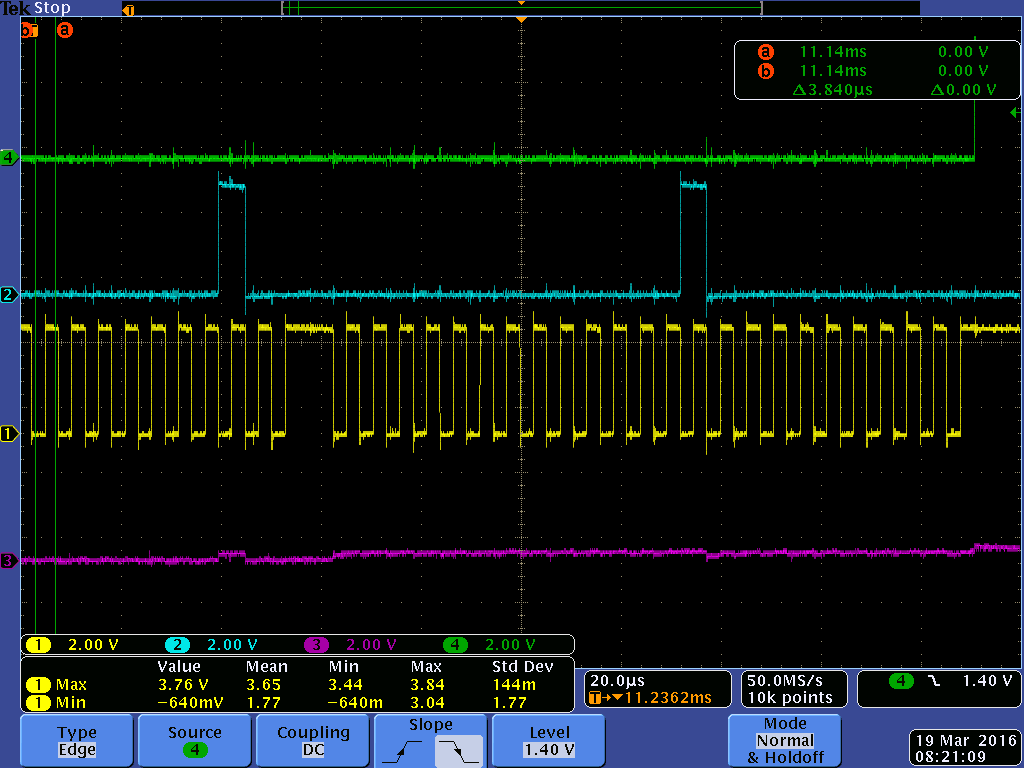
Data/Compass/tek00004.png
