trougnouf/SeniorDesign/Data/Compass/tek00005.png

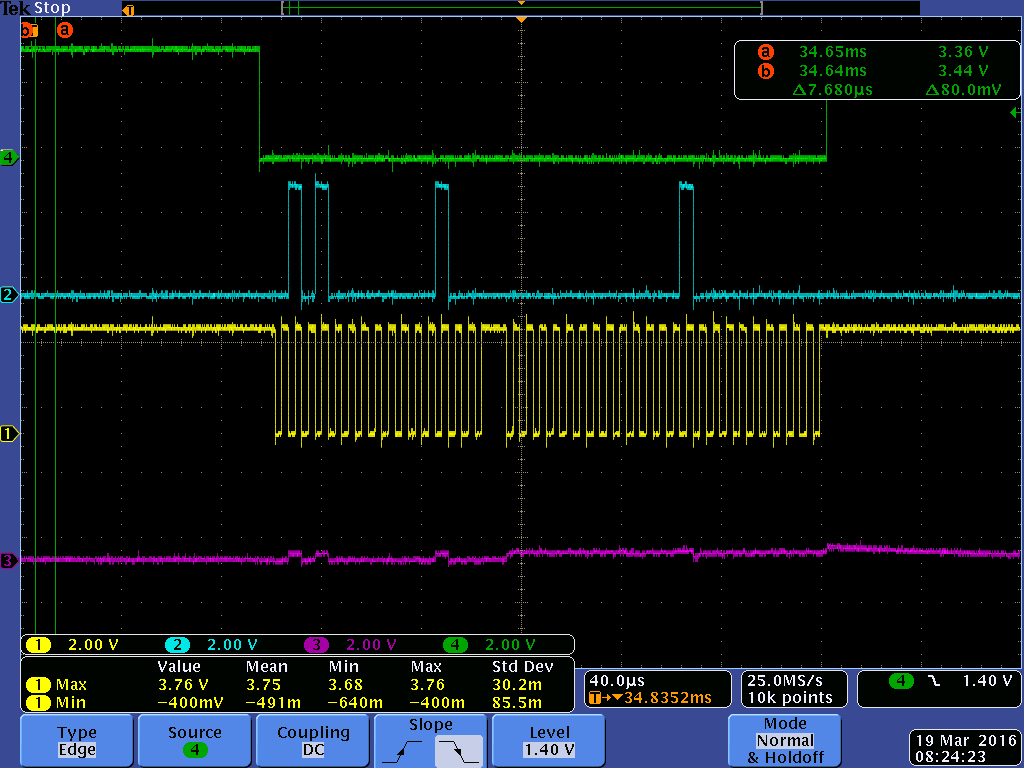
Data/Compass/tek00005.png
