trougnouf/SeniorDesign/Data/Compass/tek00007.png

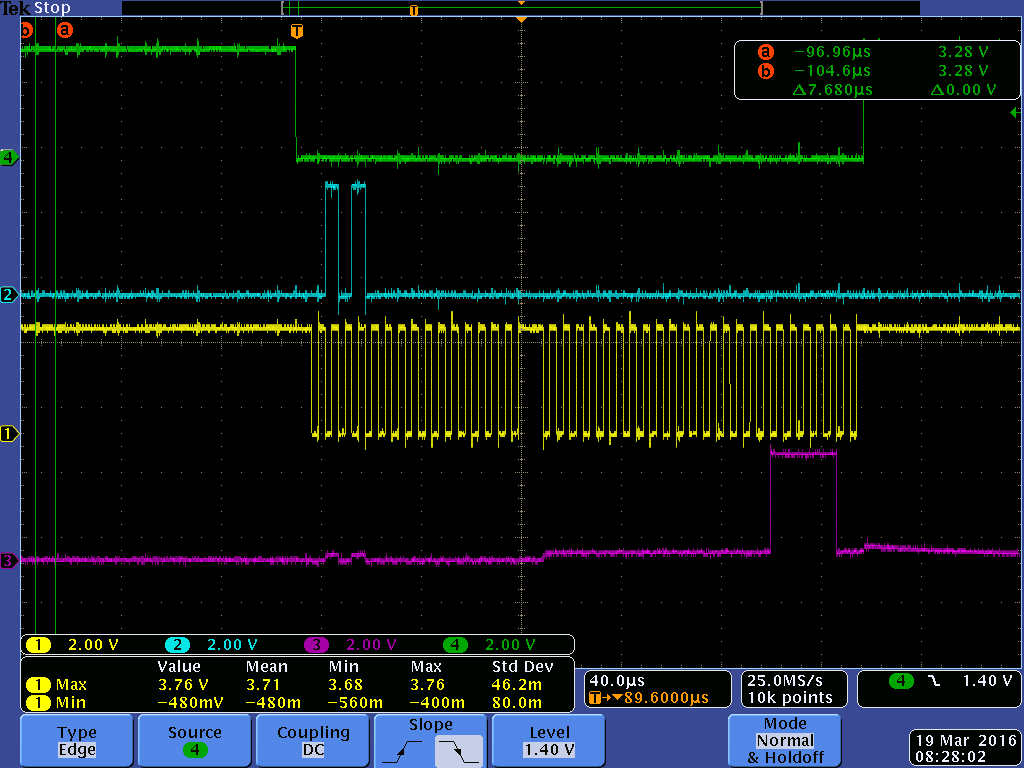
Data/Compass/tek00007.png
