trougnouf/SeniorDesign/Data/Compass/tek00009.png

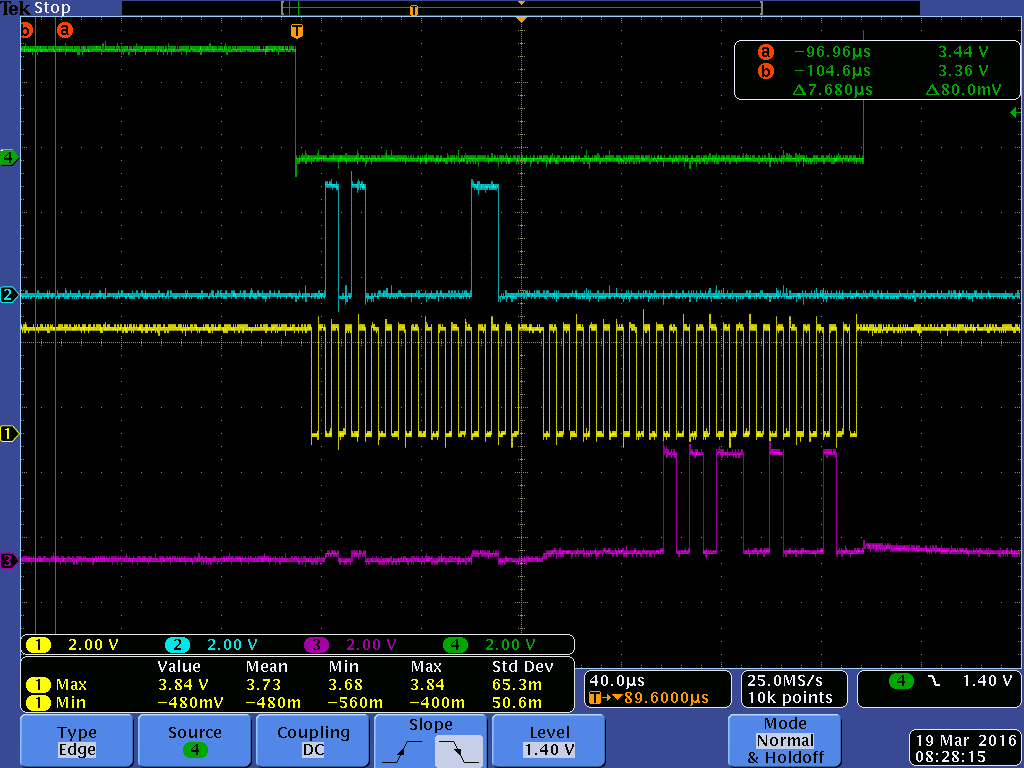
Data/Compass/tek00009.png
