trougnouf/SeniorDesign/Data/Compass/tek00011.png

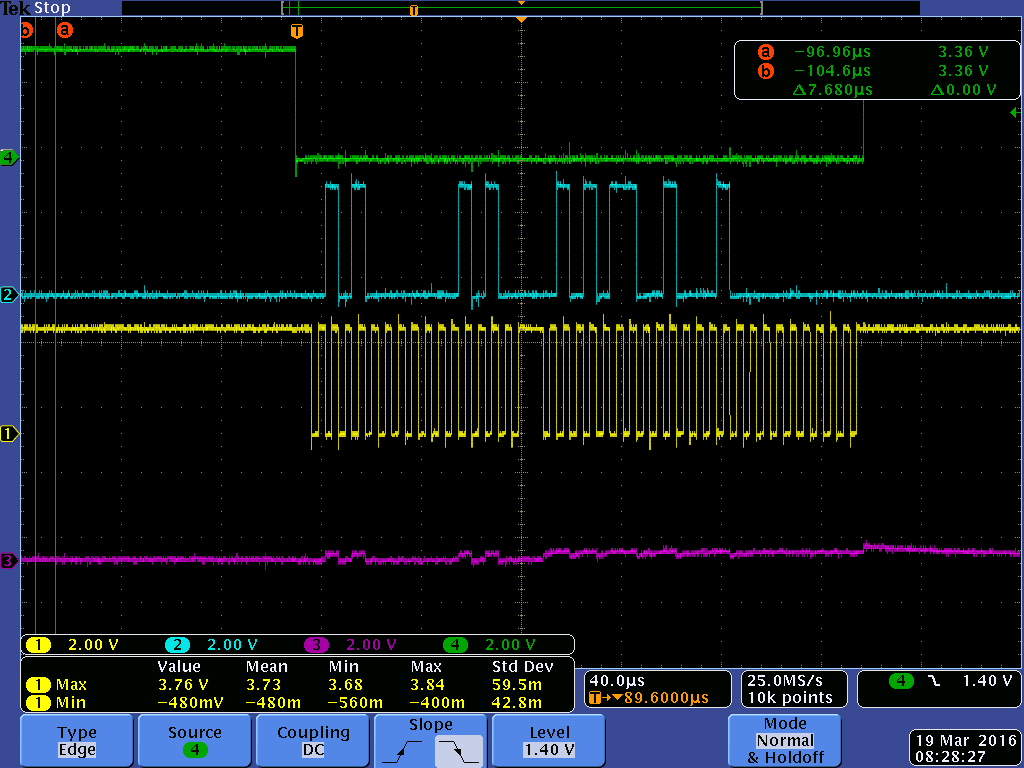
Data/Compass/tek00011.png
