trougnouf/SeniorDesign/Data/Compass/tek00012.png

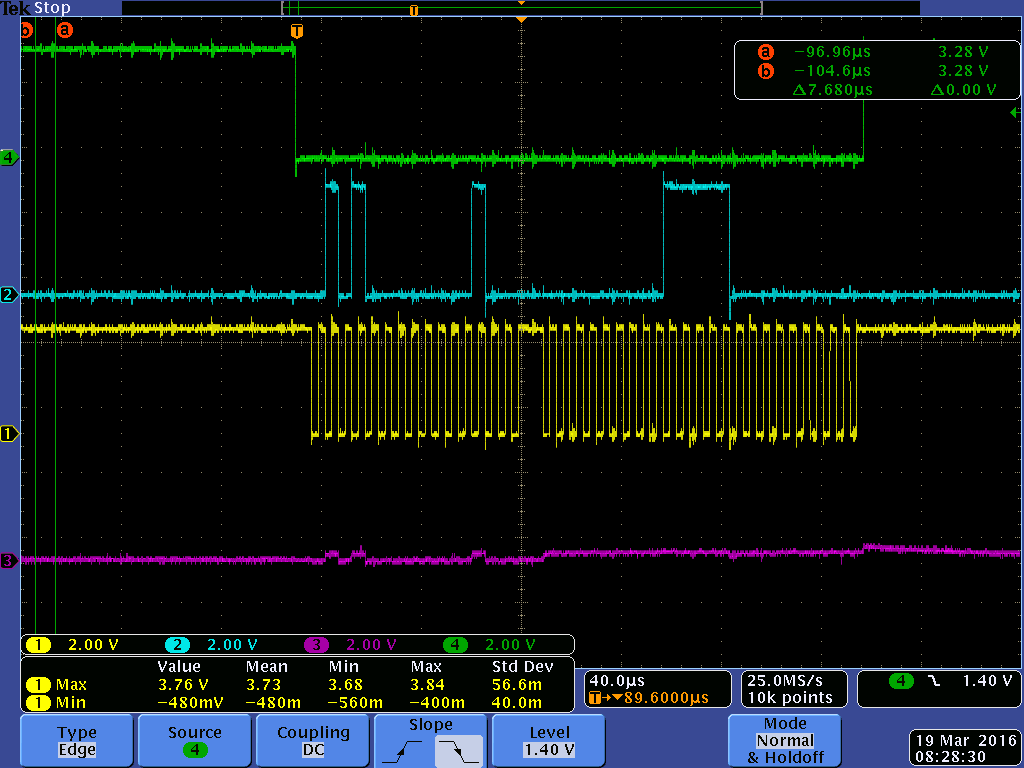
Data/Compass/tek00012.png
