trougnouf/SeniorDesign/Data/Compass/tek00014.png

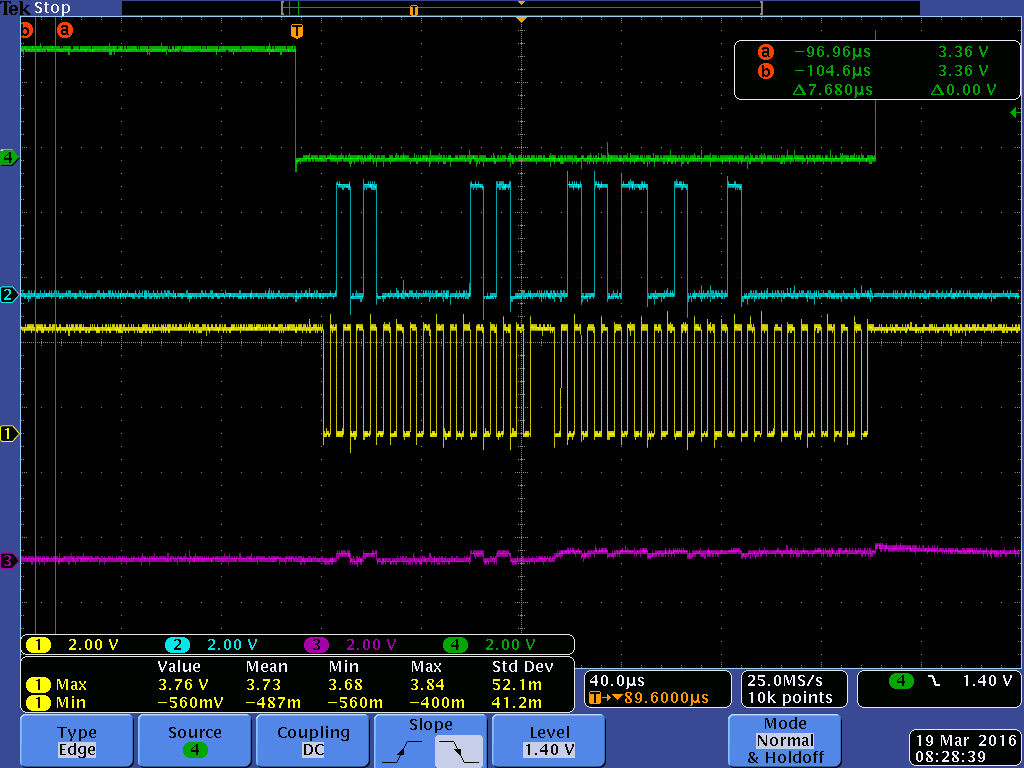
Data/Compass/tek00014.png
