trougnouf/SeniorDesign/Data/Compass/tek00017.png

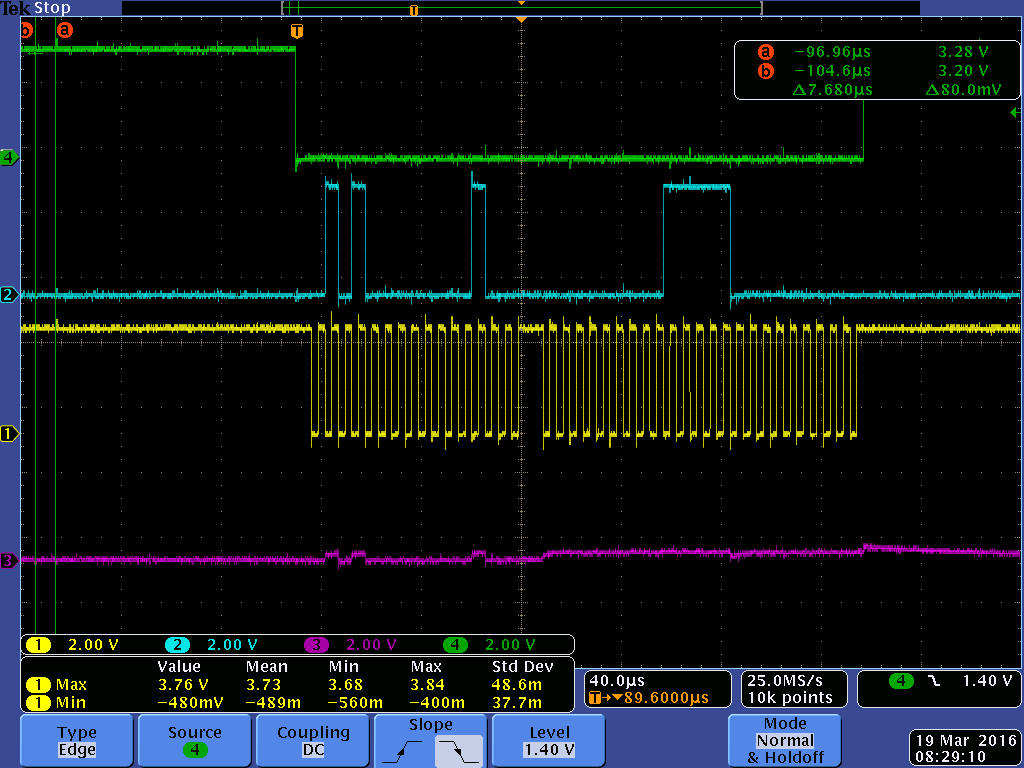
Data/Compass/tek00017.png
