trougnouf/SeniorDesign/Data/Compass/tek00022.png

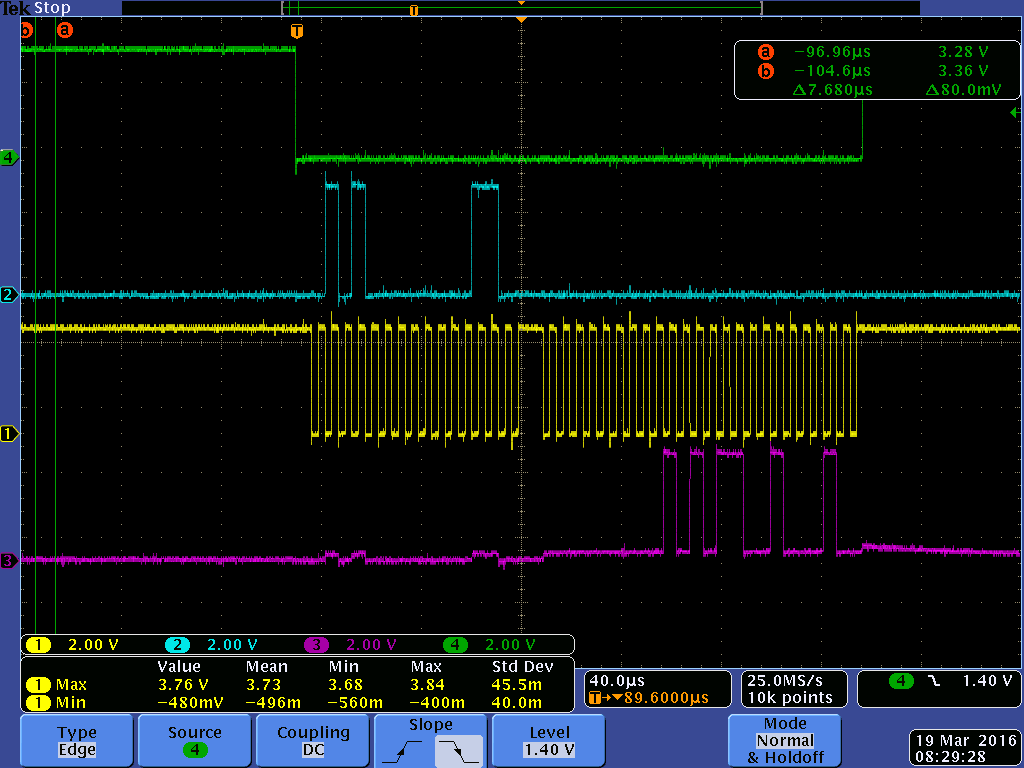
Data/Compass/tek00022.png
