trougnouf/SeniorDesign/Data/Compass/tek00029.png

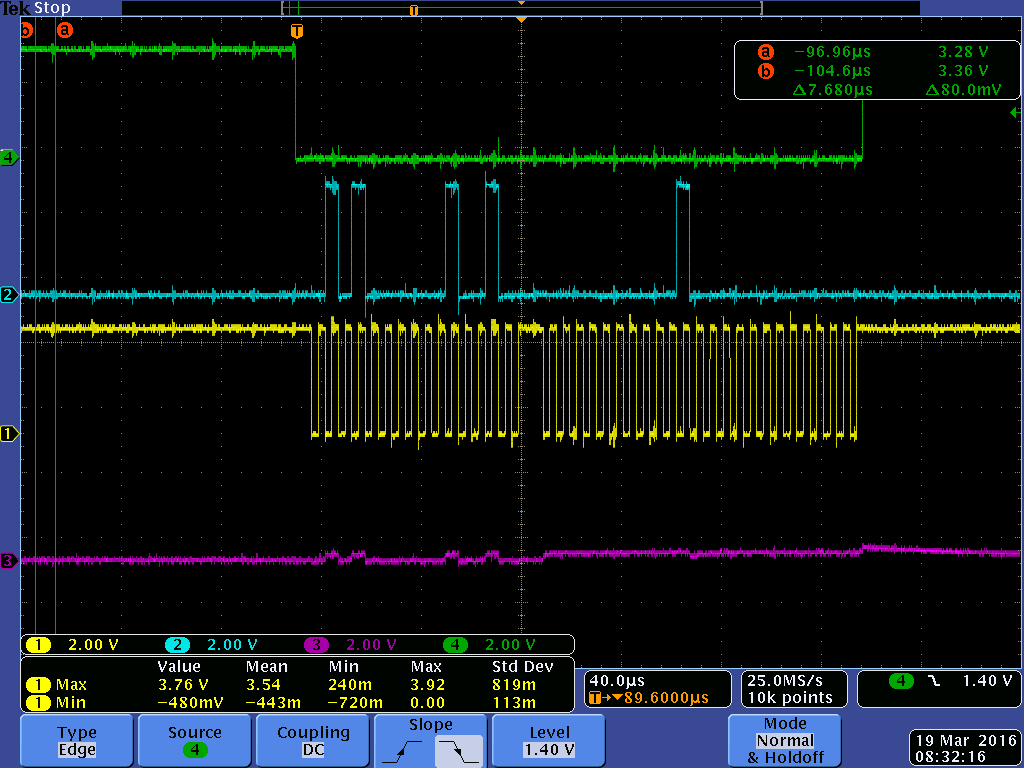
Data/Compass/tek00029.png
