trougnouf/SeniorDesign/Data/Compass/tek00030.png

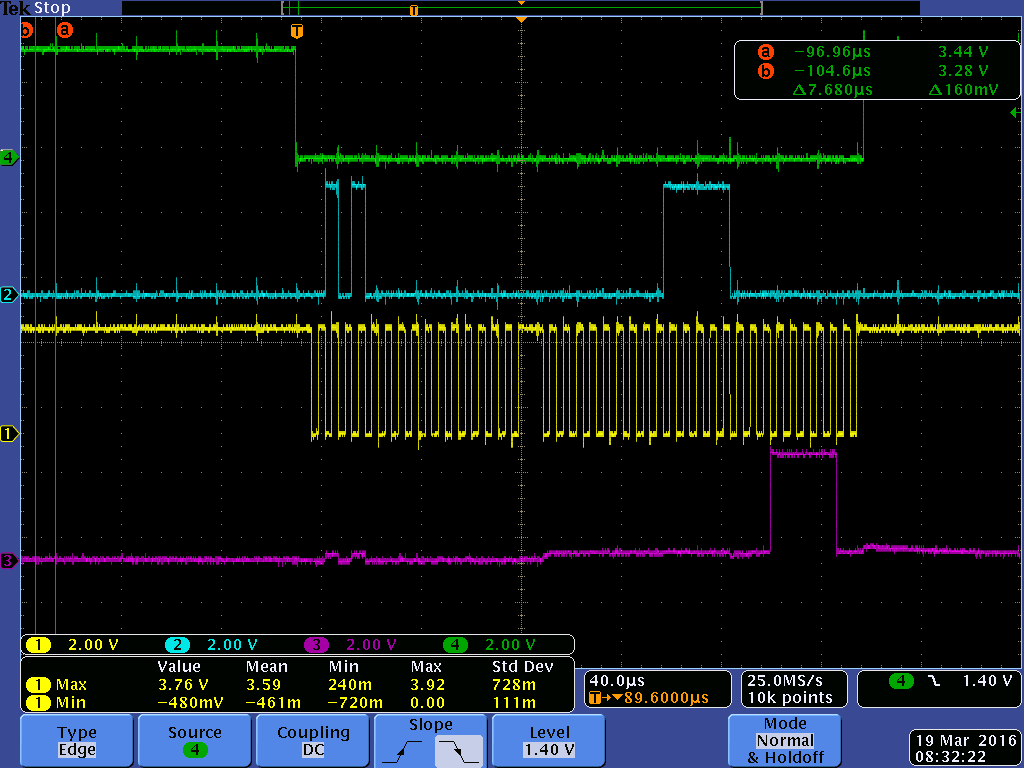
Data/Compass/tek00030.png
