trougnouf/SeniorDesign/Datasheets/MCU/DevBoards/Nucleo/nucleo-pinout.jpg

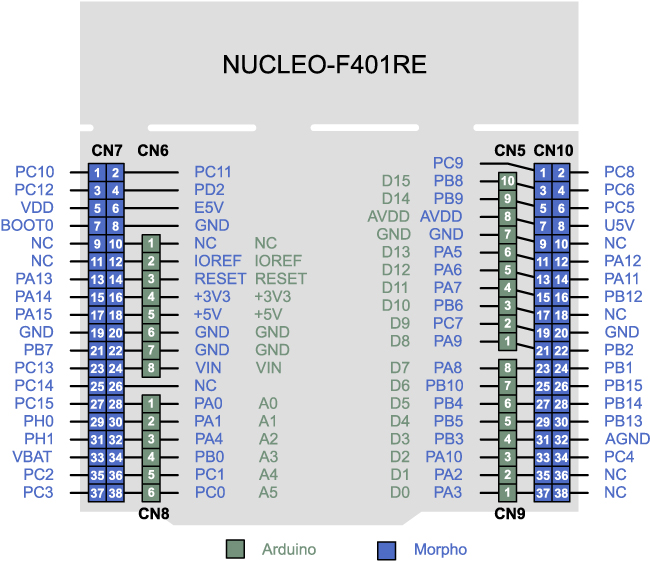
Datasheets/MCU/DevBoards/Nucleo/nucleo-pinout.jpg
