trougnouf/SeniorDesign/Documentation/2016-02-12-Presentation/img/backuppcb/47346-0001.png

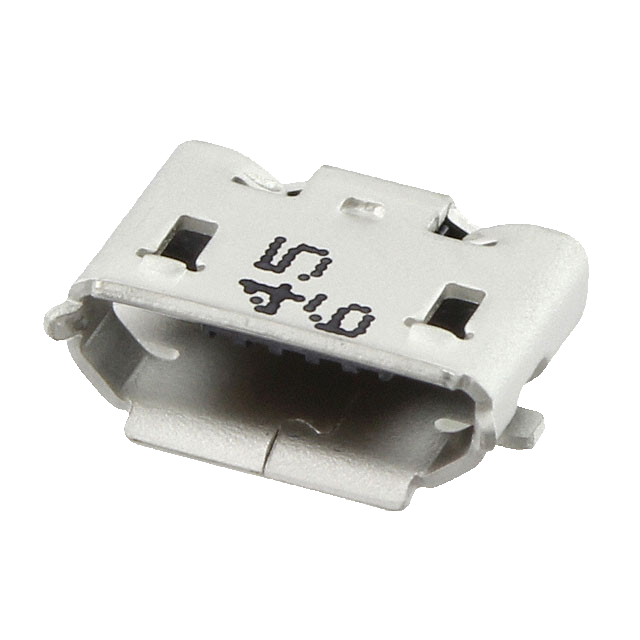
Documentation/2016-02-12-Presentation/img/backuppcb/47346-0001.png
