trougnouf/SeniorDesign/Documentation/2016-02-12-Presentation/img/backuppcb/s-l1600.png

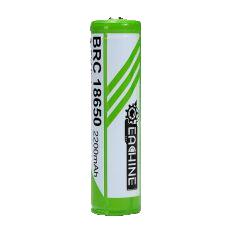
Documentation/2016-02-12-Presentation/img/backuppcb/s-l1600.png
