trougnouf/SeniorDesign/Documentation/2016-02-12-Presentation/img/backuppcb/SOT23-5.png

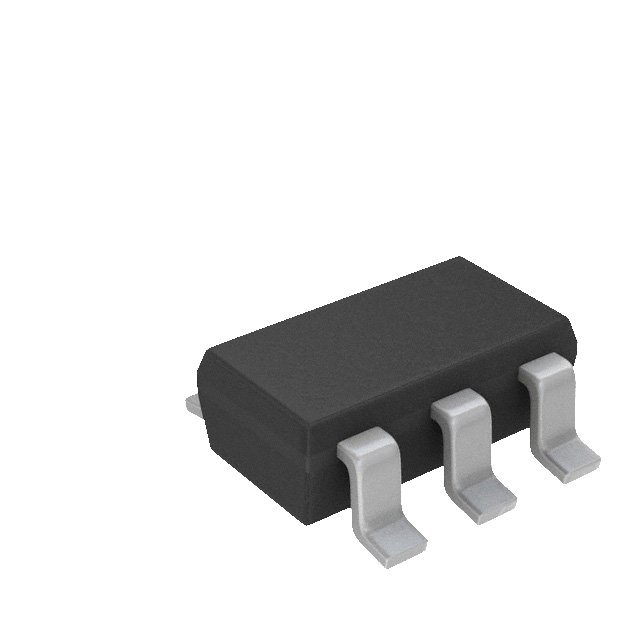
Documentation/2016-02-12-Presentation/img/backuppcb/SOT23-5.png
