trougnouf/SeniorDesign/Documentation/2016-02-12-Presentation/img/backuppcb/SOT-23-5 Thin, TSOT-23-5.png

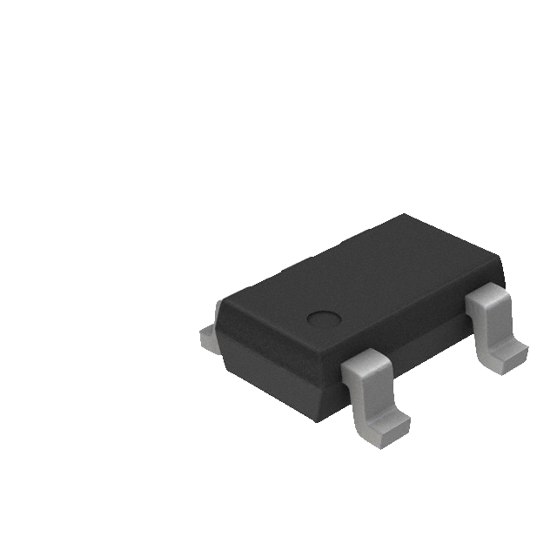
Documentation/2016-02-12-Presentation/img/backuppcb/SOT-23-5 Thin, TSOT-23-5.png
