trougnouf/SeniorDesign/Documentation/2016-02-12-Presentation/img/backuppcb/TSOT-23-6.png

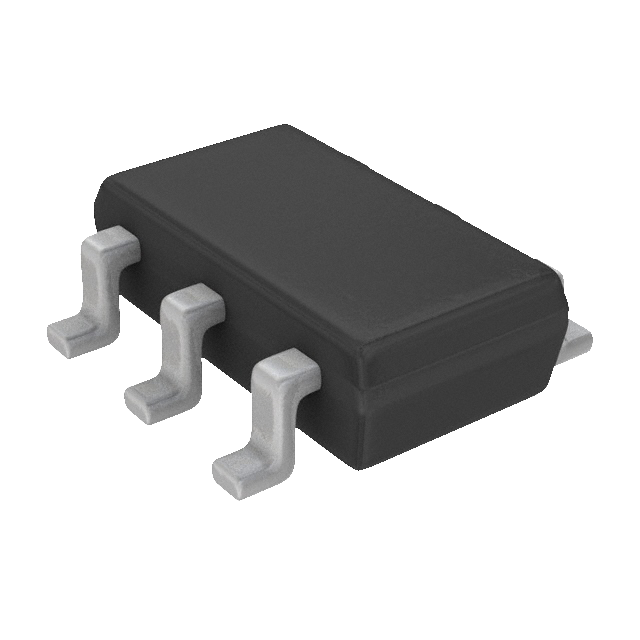
Documentation/2016-02-12-Presentation/img/backuppcb/TSOT-23-6.png
