trougnouf/SeniorDesign/Documentation/2016-02-12-Presentation/img/cam/1450; 54TSOPII; T; 54.png

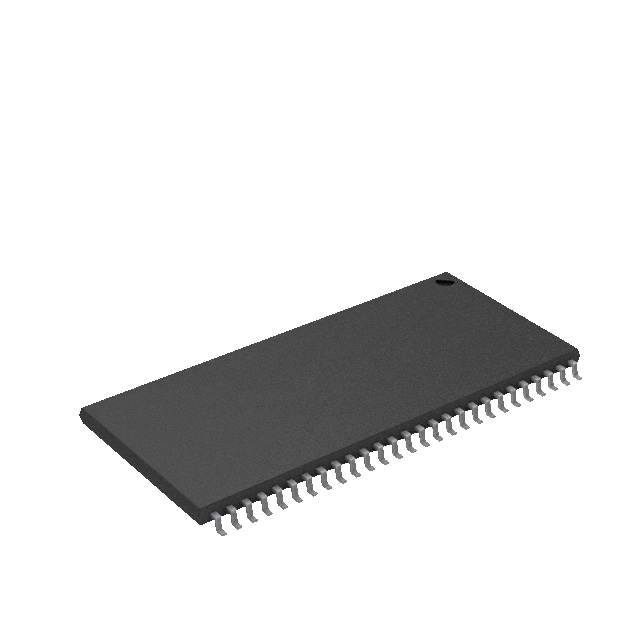
Documentation/2016-02-12-Presentation/img/cam/1450; 54TSOPII; T; 54.png
