trougnouf/SeniorDesign/Documentation/2016-02-12-Presentation/img/CPUMCU/gqvD7rs820p4.878x0.Z-Z96KYq.png

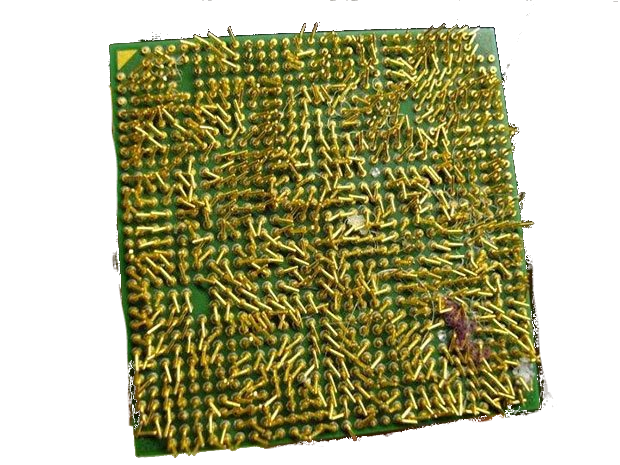
Documentation/2016-02-12-Presentation/img/CPUMCU/gqvD7rs820p4.878x0.Z-Z96KYq.png
