trougnouf/SeniorDesign/Documentation/2016-02-12-Presentation/img/CPUMCU/large.png

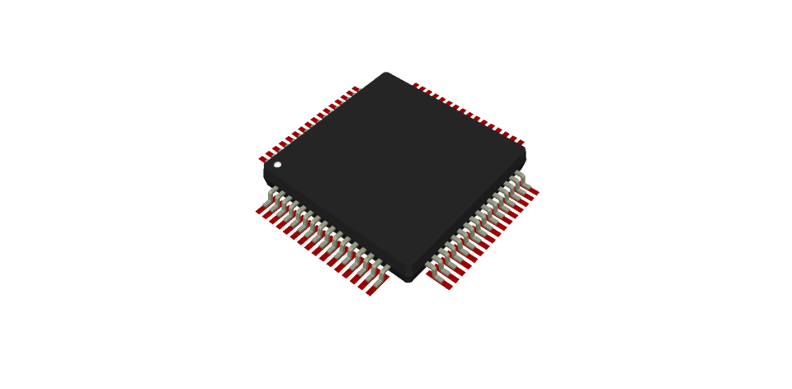
Documentation/2016-02-12-Presentation/img/CPUMCU/large.png
