trougnouf/SeniorDesign/Documentation/2016-02-12-Presentation/img/Cube/openjdk.png

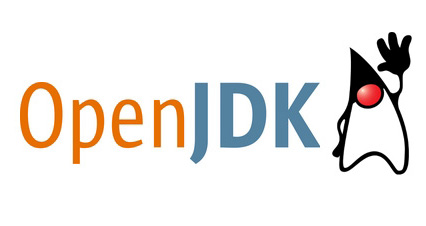
Documentation/2016-02-12-Presentation/img/Cube/openjdk.png
