trougnouf/SeniorDesign/Documentation/2016-02-12-Presentation/img/Cube/Screenshot from 2016-02-11 22-38-40.png

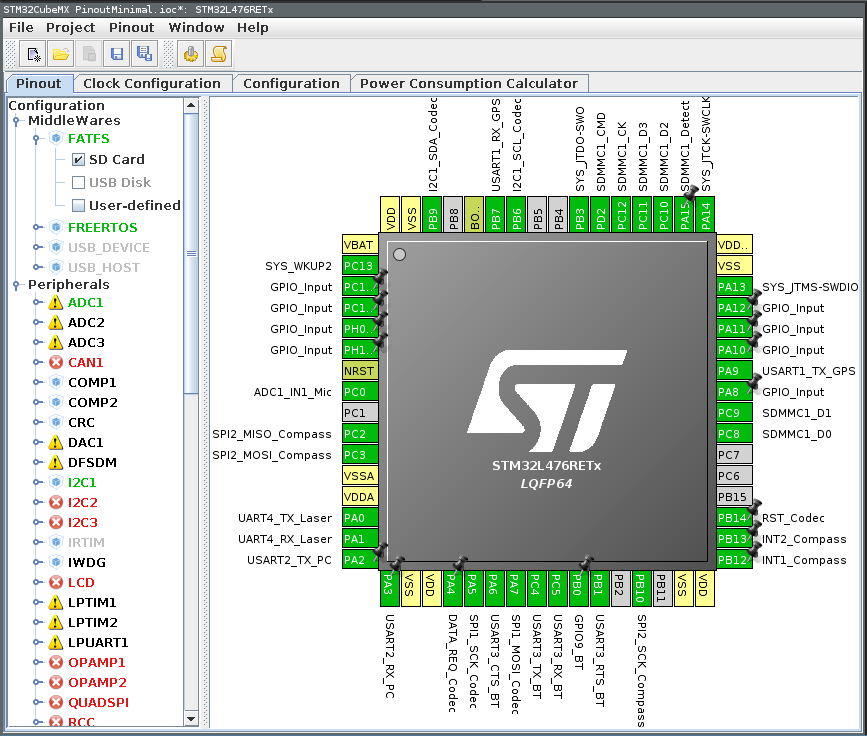
Documentation/2016-02-12-Presentation/img/Cube/Screenshot from 2016-02-11 22-38-40.png
