trougnouf/SeniorDesign/Documentation/2016-02-12-Presentation/img/Cube/Screenshot from 2016-02-11 23-28-15.png

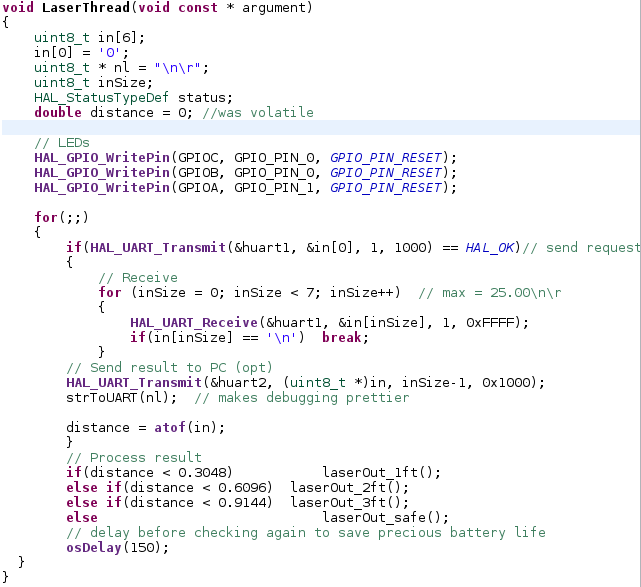
Documentation/2016-02-12-Presentation/img/Cube/Screenshot from 2016-02-11 23-28-15.png
