trougnouf/SeniorDesign/Documentation/2016-02-12-Presentation/img/HW/52b8064fc52bb.bmp.png

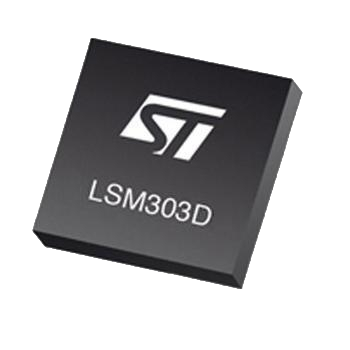
Documentation/2016-02-12-Presentation/img/HW/52b8064fc52bb.bmp.png
