trougnouf/SeniorDesign/Documentation/2016-02-12-Presentation/img/HW/08975-00.png

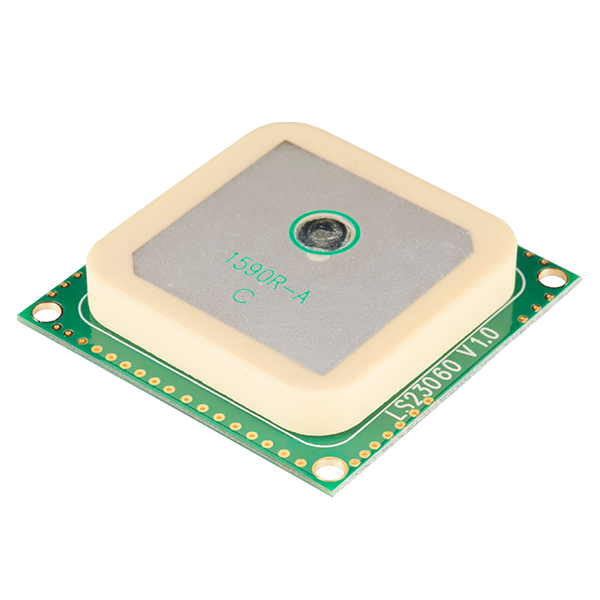
Documentation/2016-02-12-Presentation/img/HW/08975-00.png
