trougnouf/SeniorDesign/Documentation/2016-02-12-Presentation/img/HW/10028-01.png

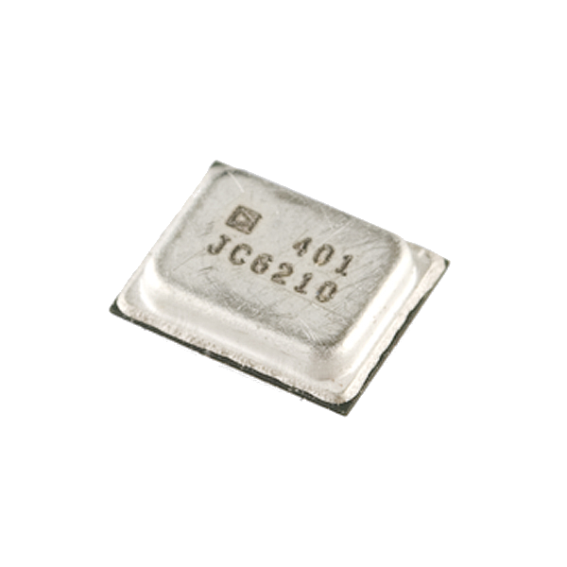
Documentation/2016-02-12-Presentation/img/HW/10028-01.png
