trougnouf/SeniorDesign/Documentation/2016-02-12-Presentation/img/HW/5033981892.png

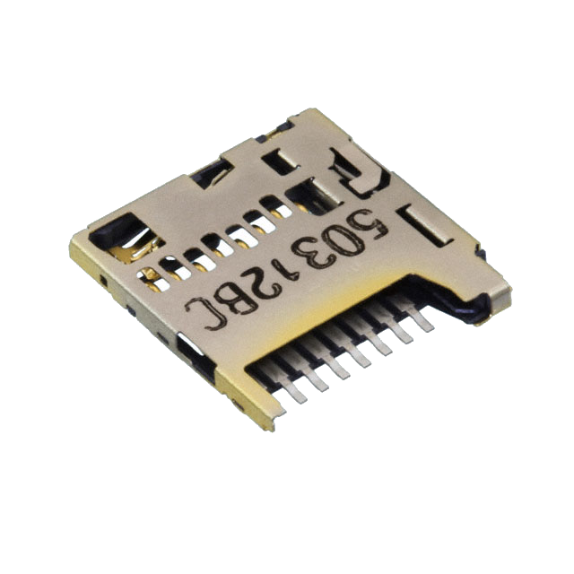
Documentation/2016-02-12-Presentation/img/HW/5033981892.png
