trougnouf/SeniorDesign/Documentation/2016-02-12-Presentation/img/HW/-font-b-OV9655-b-font-font-b-Camera-b-font-font-b-Module-b-font.png

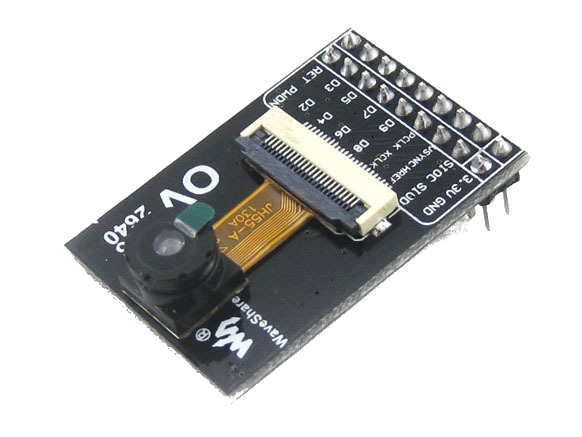
Documentation/2016-02-12-Presentation/img/HW/-font-b-OV9655-b-font-font-b-Camera-b-font-font-b-Module-b-font.png
