trougnouf/SeniorDesign/Documentation/2016-02-12-Presentation/img/HW/RN52-I^RM.png

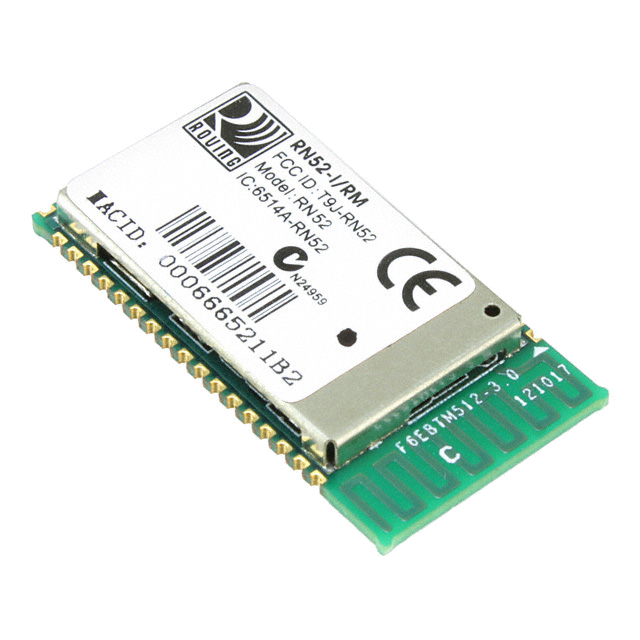
Documentation/2016-02-12-Presentation/img/HW/RN52-I^RM.png
