trougnouf/SeniorDesign/Documentation/2016-02-12-Presentation/img/HW/sf10_final_4.png

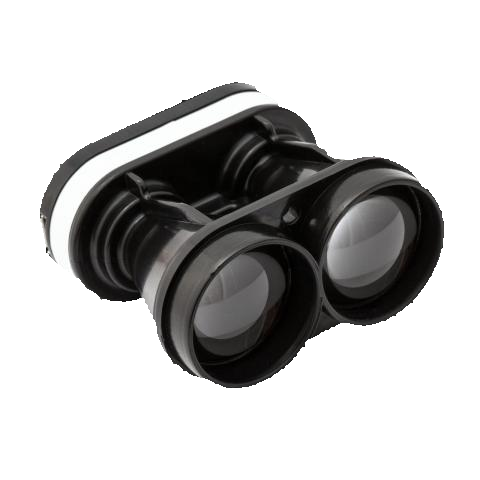
Documentation/2016-02-12-Presentation/img/HW/sf10_final_4.png
