trougnouf/SeniorDesign/Documentation/2016-02-12-Presentation/img/HW/sta013_sop28.png

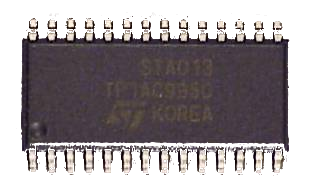
Documentation/2016-02-12-Presentation/img/HW/sta013_sop28.png
