trougnouf/SeniorDesign/Documentation/2016-02-12-Presentation/img/MCU/45625264.jpg

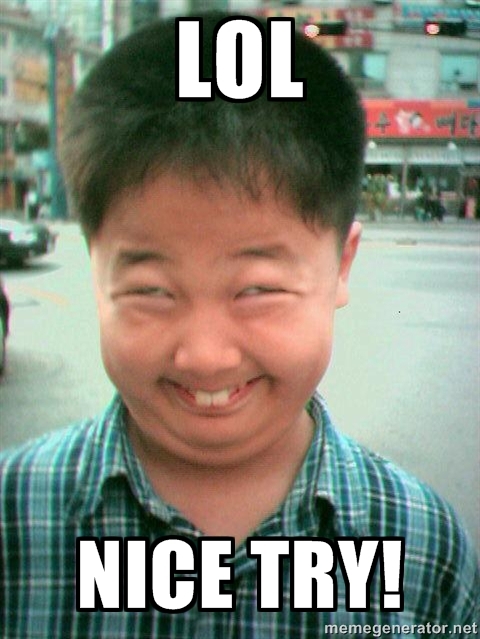
Documentation/2016-02-12-Presentation/img/MCU/45625264.jpg
