trougnouf/SeniorDesign/Documentation/2016-02-12-Presentation/img/MCU/arms-cortex-m7-100451977-primary.idge.png

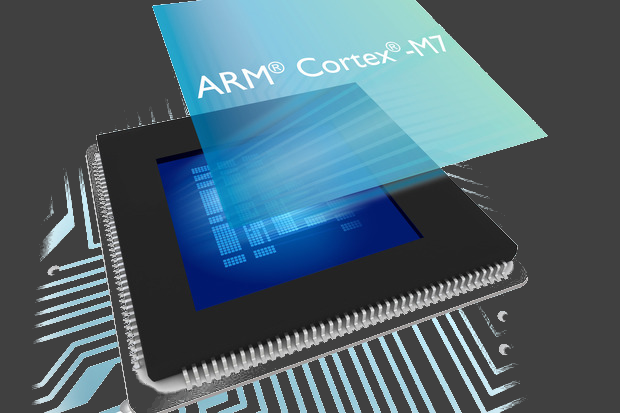
Documentation/2016-02-12-Presentation/img/MCU/arms-cortex-m7-100451977-primary.idge.png
