trougnouf/SeniorDesign/Documentation/2016-02-12-Presentation/img/MCU/atmega2560-16au.png

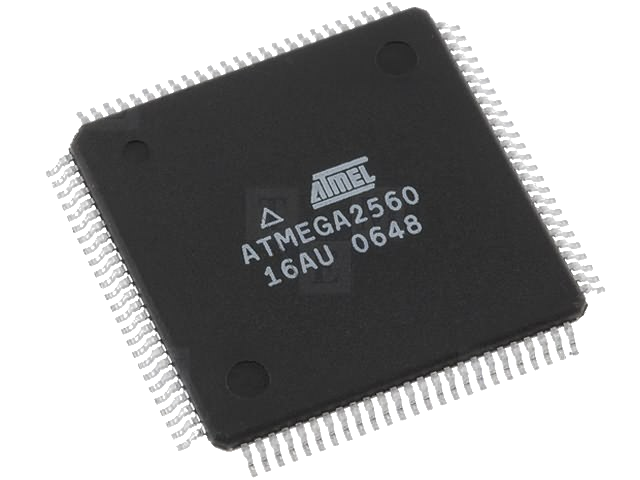
Documentation/2016-02-12-Presentation/img/MCU/atmega2560-16au.png
