trougnouf/SeniorDesign/Documentation/2016-02-12-Presentation/img/MCU/d48f3b8f-2ca4-47ab-9f06-6636bbdfc2c1.HR.png

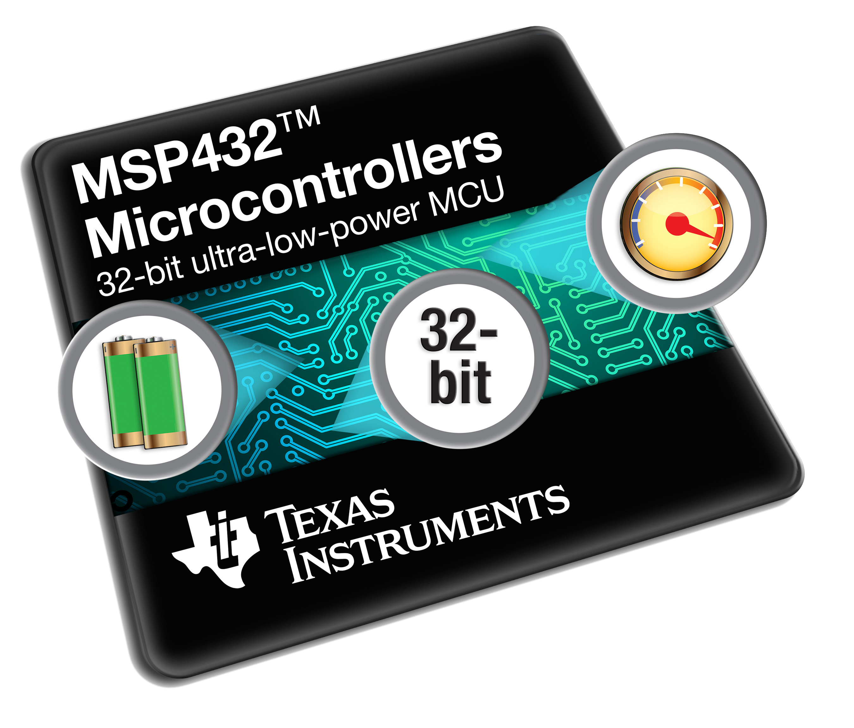
Documentation/2016-02-12-Presentation/img/MCU/d48f3b8f-2ca4-47ab-9f06-6636bbdfc2c1.HR.png
