trougnouf/SeniorDesign/Documentation/2016-02-12-Presentation/img/MCU/filepicker_PYUr2CXdRCmeCvfKfscy_holy_grail.png

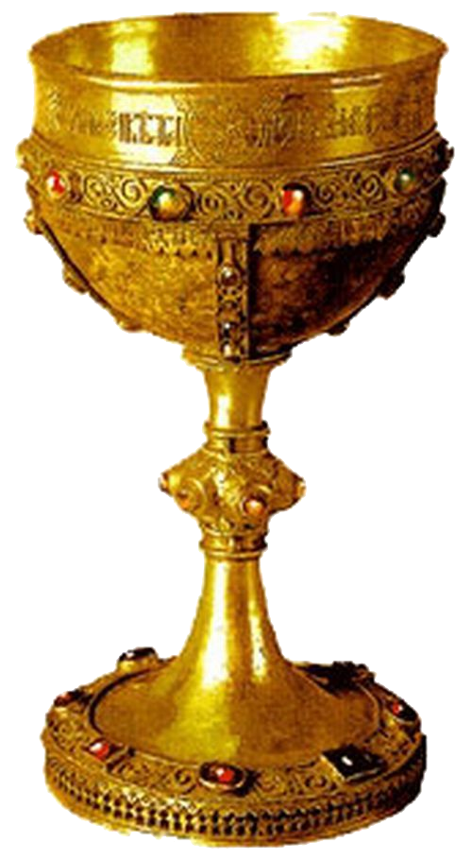
Documentation/2016-02-12-Presentation/img/MCU/filepicker_PYUr2CXdRCmeCvfKfscy_holy_grail.png
