trougnouf/SeniorDesign/Documentation/2016-02-12-Presentation/img/MCU/filepicker_PYUr2CXdRCmeCvfKfscy_holy_grailF7.png

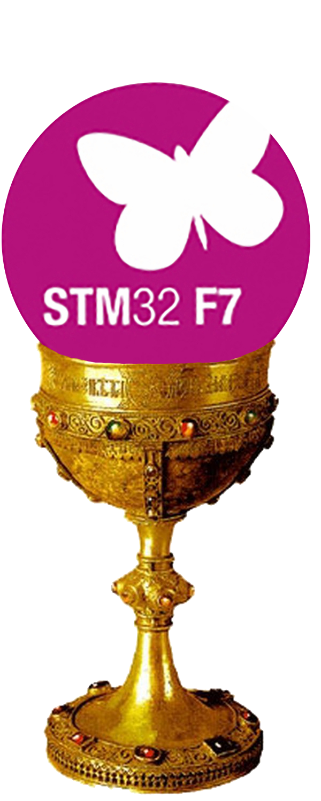
Documentation/2016-02-12-Presentation/img/MCU/filepicker_PYUr2CXdRCmeCvfKfscy_holy_grailF7.png
