trougnouf/SeniorDesign/Documentation/2016-02-12-Presentation/img/MCU/Freescale_Kinetis_E-Series1.png

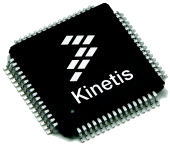
Documentation/2016-02-12-Presentation/img/MCU/Freescale_Kinetis_E-Series1.png
