trougnouf/SeniorDesign/Documentation/2016-02-12-Presentation/img/MCU/new-and-improved.png

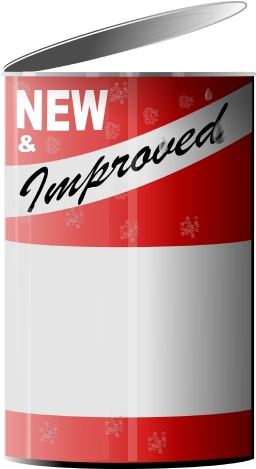
Documentation/2016-02-12-Presentation/img/MCU/new-and-improved.png
