trougnouf/SeniorDesign/Documentation/2016-02-12-Presentation/img/MCU/shutterstock_25282918-300x221.png

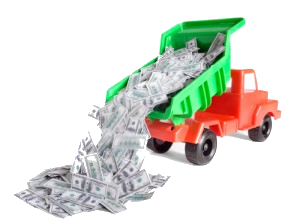
Documentation/2016-02-12-Presentation/img/MCU/shutterstock_25282918-300x221.png
