trougnouf/SeniorDesign/Documentation/2016-02-12-Presentation/img/MCU/slow.png

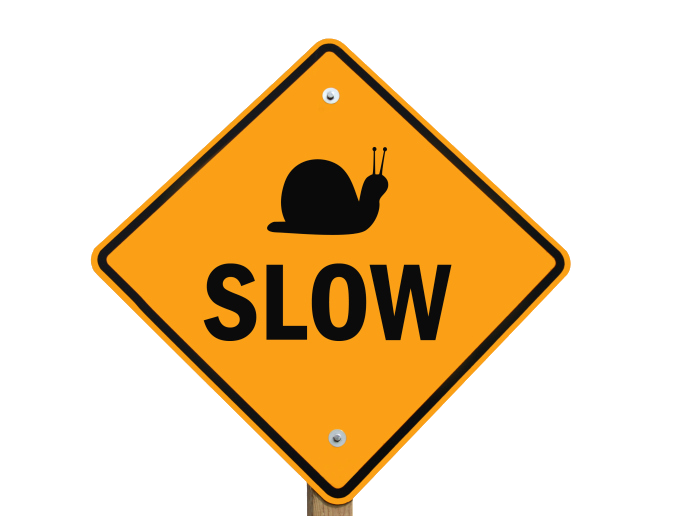
Documentation/2016-02-12-Presentation/img/MCU/slow.png
