trougnouf/SeniorDesign/Documentation/2016-02-12-Presentation/img/MCU/stm32f7.jpg

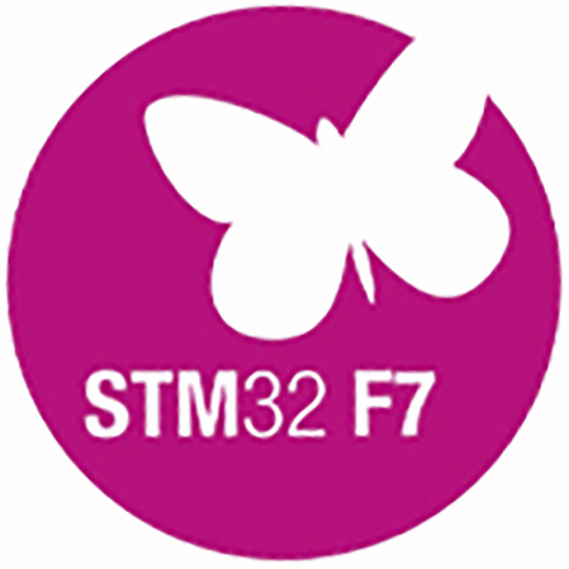
Documentation/2016-02-12-Presentation/img/MCU/stm32f7.jpg
