trougnouf/SeniorDesign/Documentation/2016-02-12-Presentation/img/MCU/TI-MSP430_100Pin.png

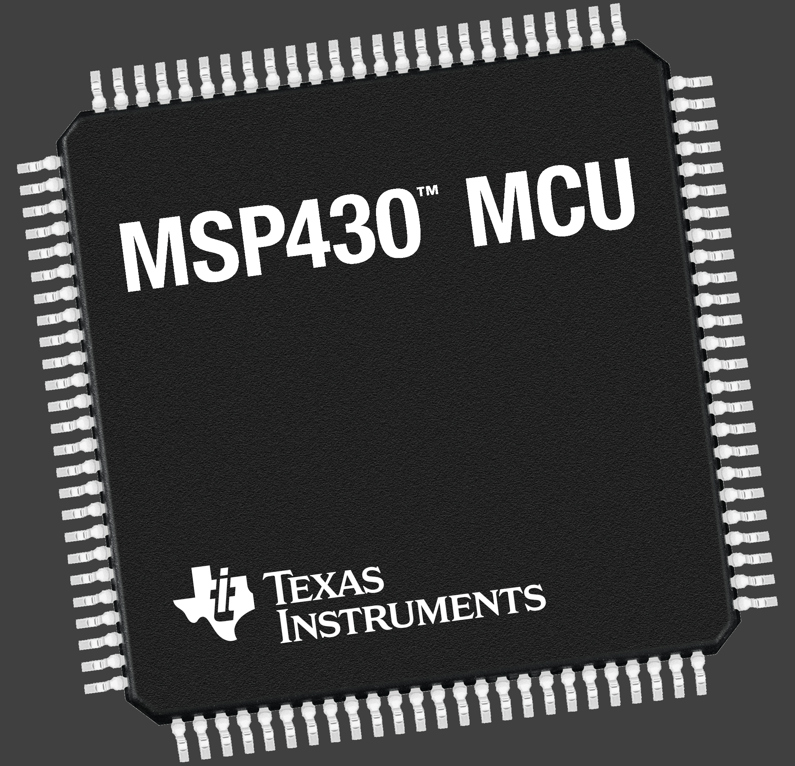
Documentation/2016-02-12-Presentation/img/MCU/TI-MSP430_100Pin.png
