trougnouf/SeniorDesign/Documentation/2016-02-12-Presentation/img/misc/campaign.png

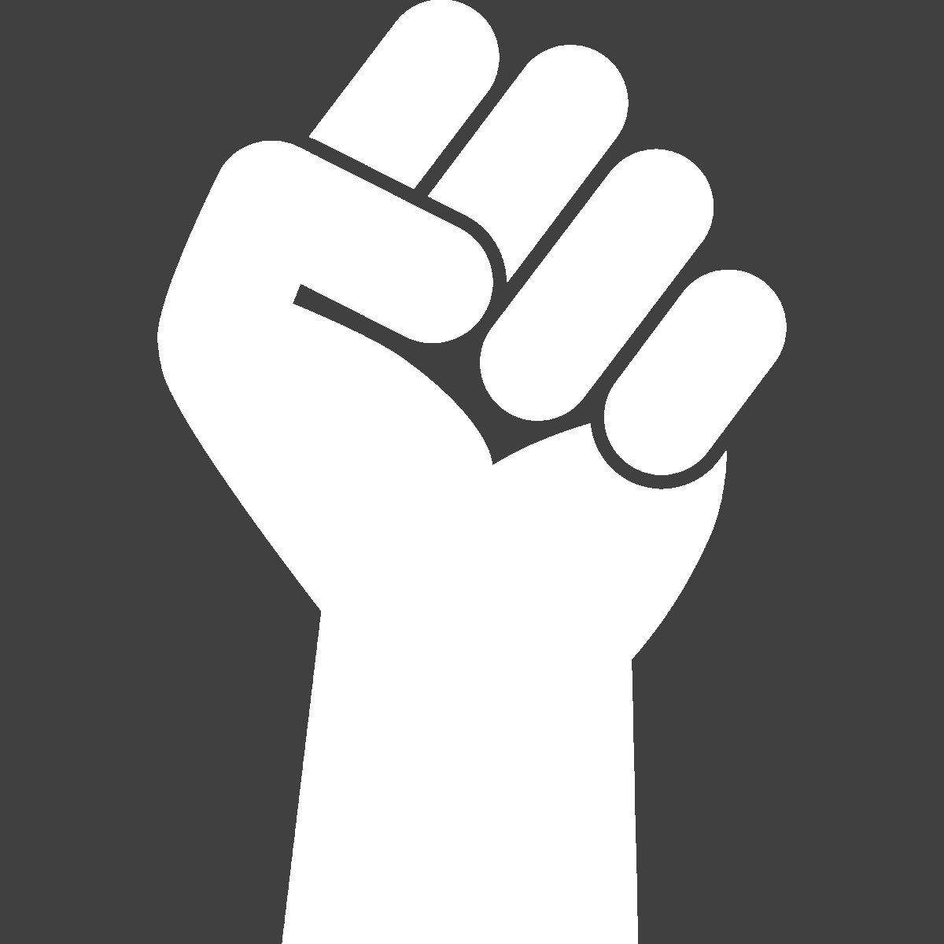
Documentation/2016-02-12-Presentation/img/misc/campaign.png
