trougnouf/SeniorDesign/Documentation/2016-02-12-Presentation/img/STM32/nucleo-Lx.png

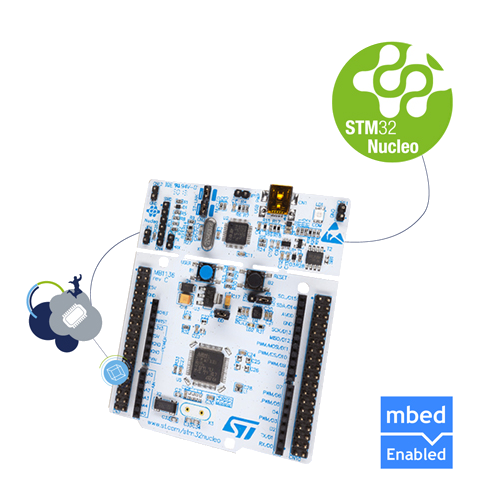
Documentation/2016-02-12-Presentation/img/STM32/nucleo-Lx.png
