trougnouf/SeniorDesign/Documentation/2016-02-12-Presentation/img/STM32/stm32f746g-disco.png

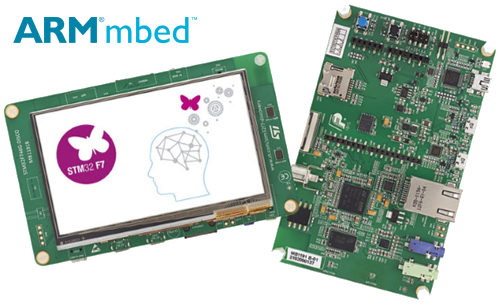
Documentation/2016-02-12-Presentation/img/STM32/stm32f746g-disco.png
