trougnouf/SeniorDesign/Documentation/2016-02-12-Presentation/img/STM32/what-is-java-used-for.jpg

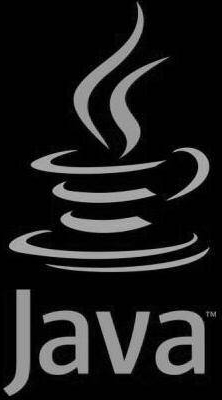
Documentation/2016-02-12-Presentation/img/STM32/what-is-java-used-for.jpg
