trougnouf/SeniorDesign/Documentation/2016-02-12-Presentation/img/SW/mic_web_rotated.png

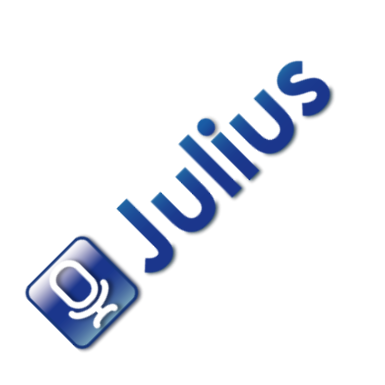
Documentation/2016-02-12-Presentation/img/SW/mic_web_rotated.png
