trougnouf/SeniorDesign/Documentation/2016-04-19-presentation/Melexis_February2015_pg23.jpg

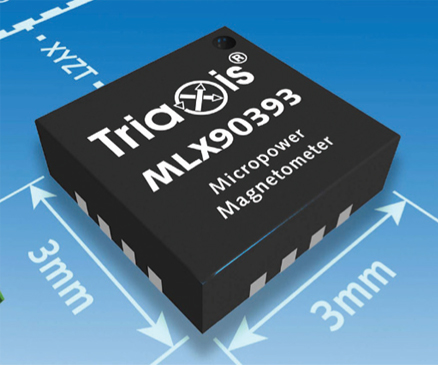
Documentation/2016-04-19-presentation/Melexis_February2015_pg23.jpg
