trougnouf/SeniorDesign/Documentation/2016-04-21-board/SenseWalk_2.png

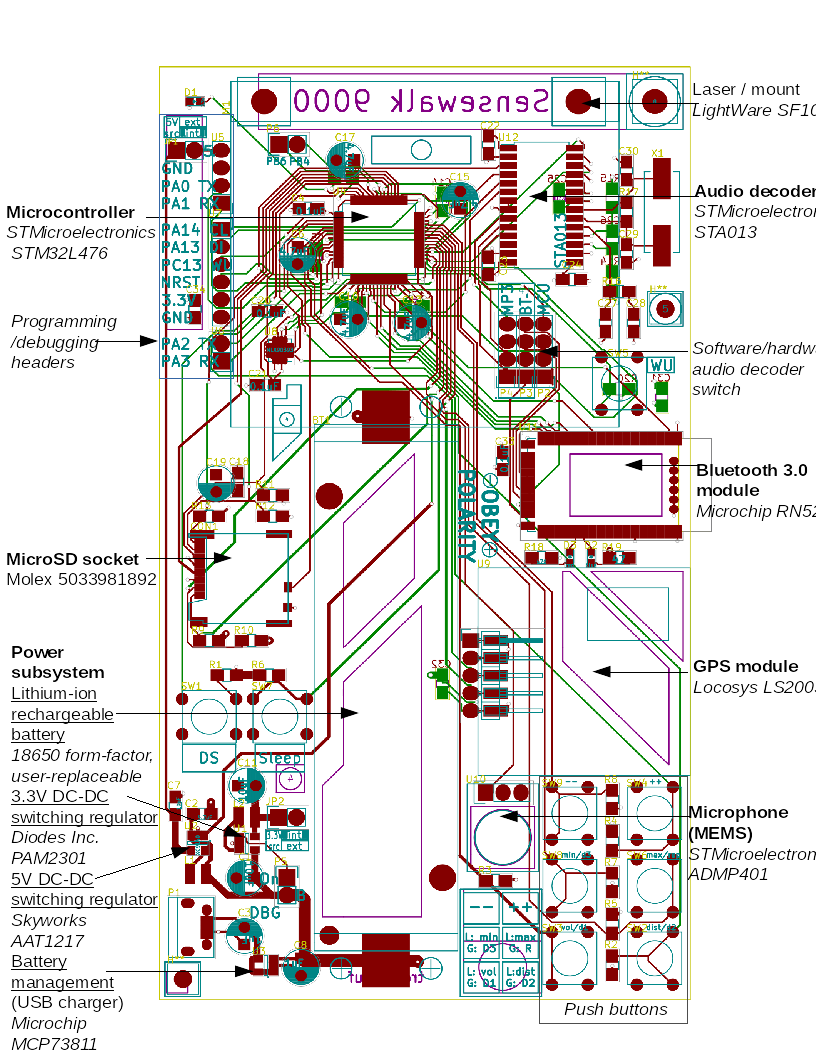
Documentation/2016-04-21-board/SenseWalk_2.png
