trougnouf/SeniorDesign/Documentation/2016-04-30-finalpaper/Selection_054.png

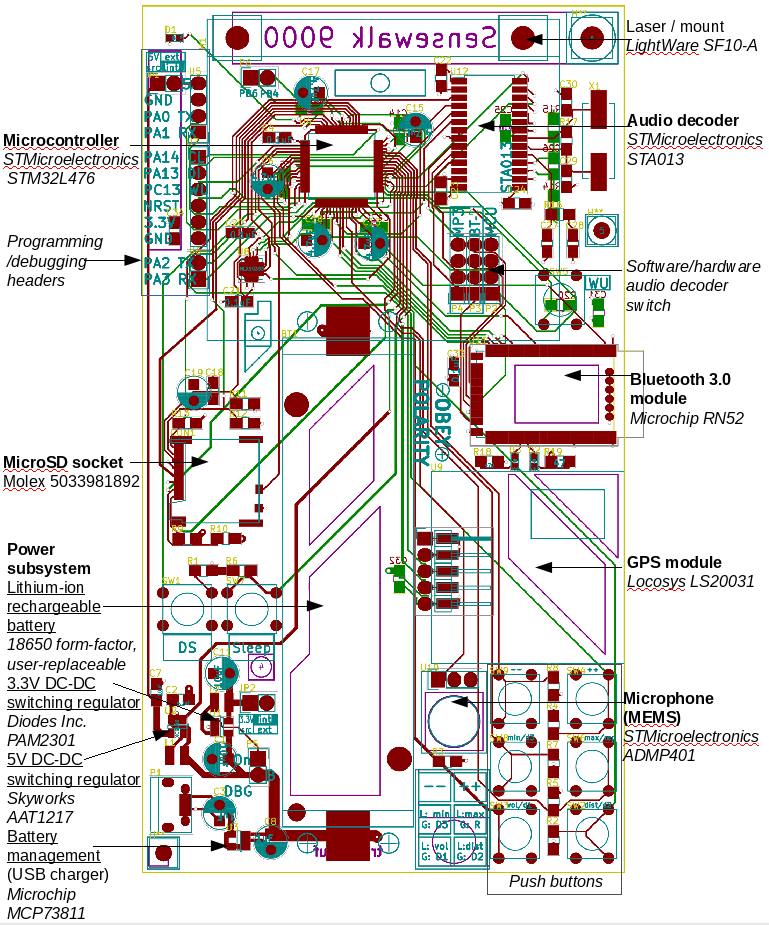
Documentation/2016-04-30-finalpaper/Selection_054.png
