trougnouf/SeniorDesign/Schematic/Sensewalk2/Ross/rossrev4/layout.png

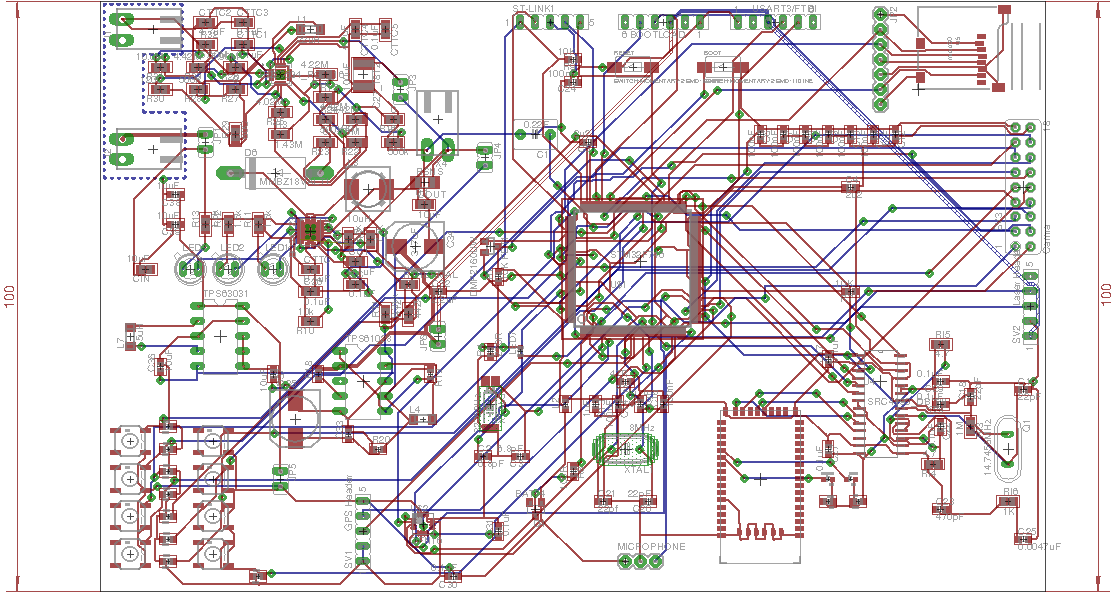
Schematic/Sensewalk2/Ross/rossrev4/layout.png
