trougnouf/SeniorDesign/Schematic/Sensewalk2/Ross/rossrev4/schematic.png

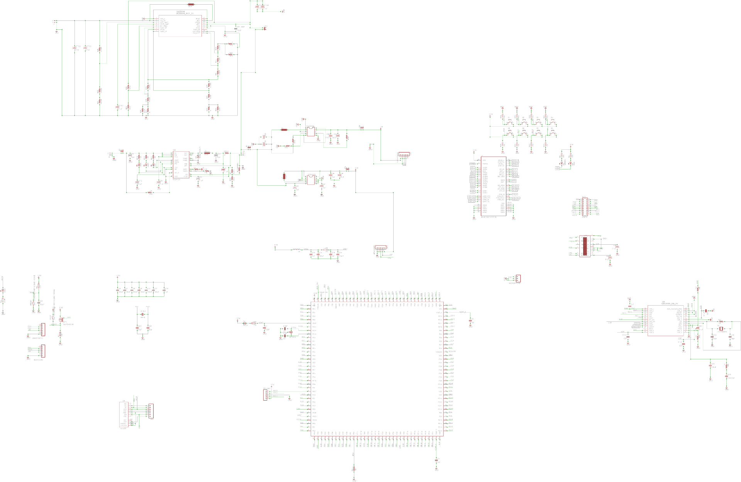
Schematic/Sensewalk2/Ross/rossrev4/schematic.png
