trougnouf/SeniorDesign/Schematic/Sensewalk9000/Datasheet/SD/6978821411410910405.gif

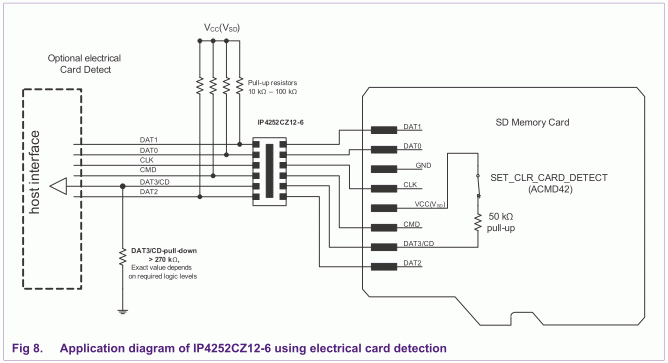
Schematic/Sensewalk9000/Datasheet/SD/6978821411410910405.gif
