trougnouf/SeniorDesign/Schematic/Sensewalk9000/FinalPCB/renders/Pcbnew 4.0.2-stable -orb-Dev-SeniorDesign-Schematic-Minimal-kicad-SDMin.kicad_pcb_003.png

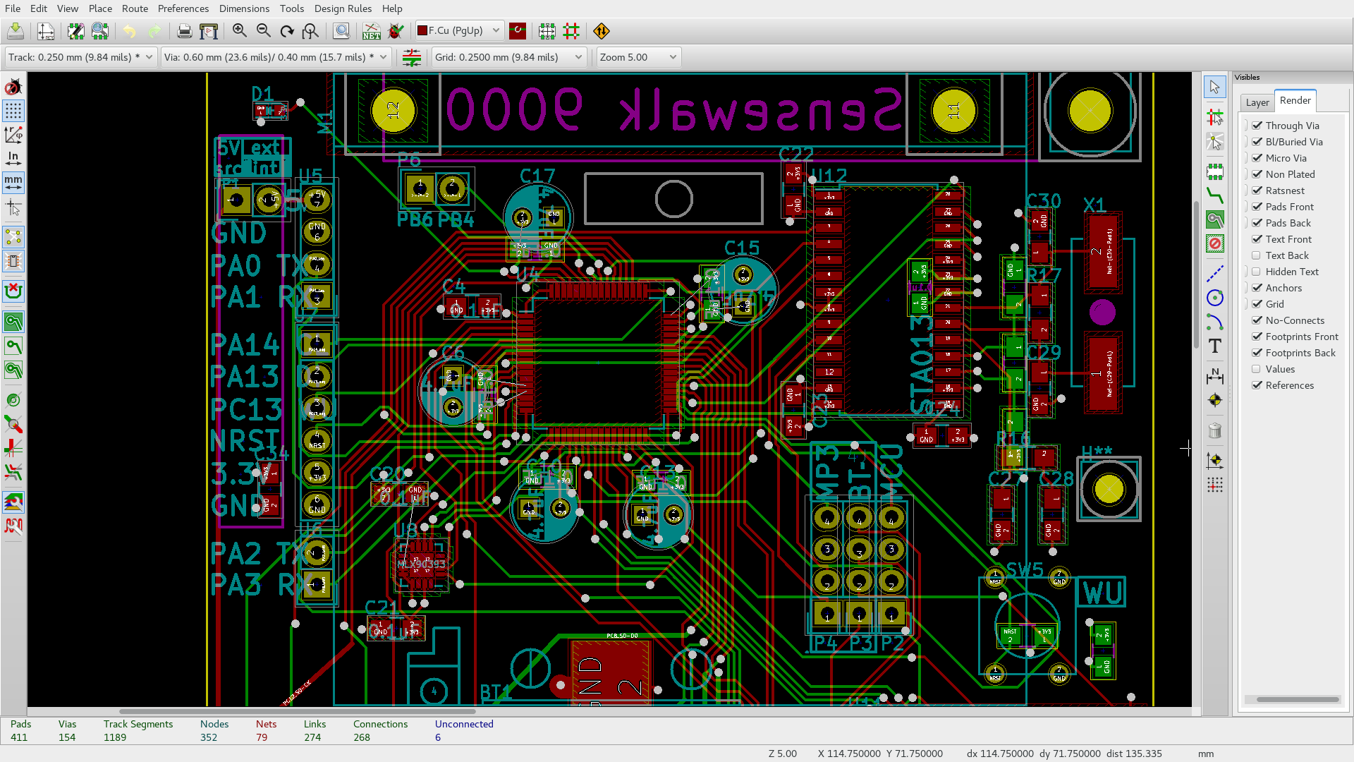
Schematic/Sensewalk9000/FinalPCB/renders/Pcbnew 4.0.2-stable -orb-Dev-SeniorDesign-Schematic-Minimal-kicad-SDMin.kicad_pcb_003.png
