trougnouf/SeniorDesign/Schematic/Sensewalk9000/FinalPCB/renders/schematic-brokenup/Selection_054.png

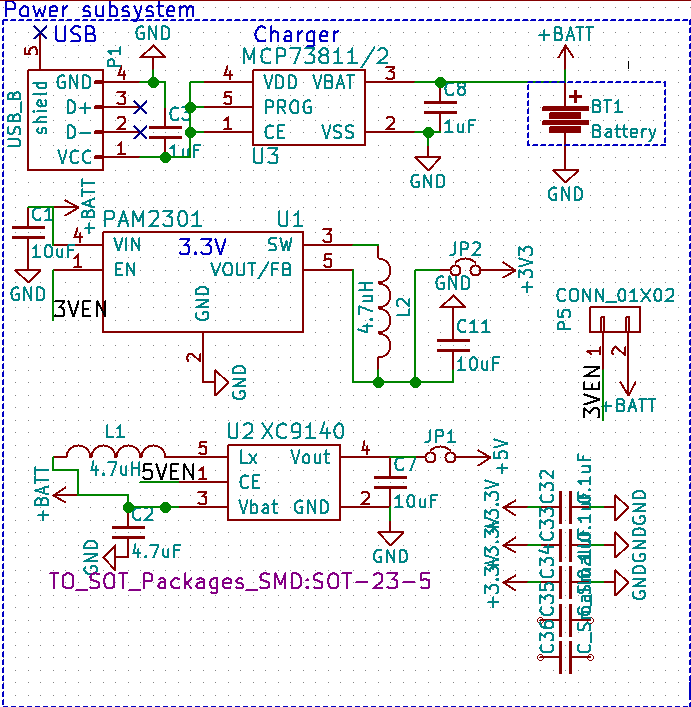
Schematic/Sensewalk9000/FinalPCB/renders/schematic-brokenup/Selection_054.png
