trougnouf/SeniorDesign/Schematic/Sensewalk9000/FinalPCB/renders/schematic-brokenup/Selection_058.png

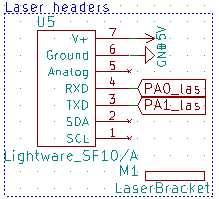
Schematic/Sensewalk9000/FinalPCB/renders/schematic-brokenup/Selection_058.png
