trougnouf/SeniorDesign/Schematic/Sensewalk9000/FinalPCB/renders/schematic-brokenup/Selection_059.png

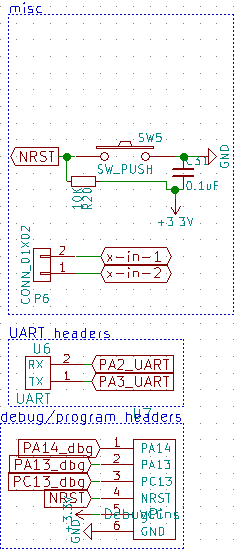
Schematic/Sensewalk9000/FinalPCB/renders/schematic-brokenup/Selection_059.png
