trougnouf/SeniorDesign/Schematic/Sensewalk9000/FinalPCB/renders/SDMin.sch-noalpha.png

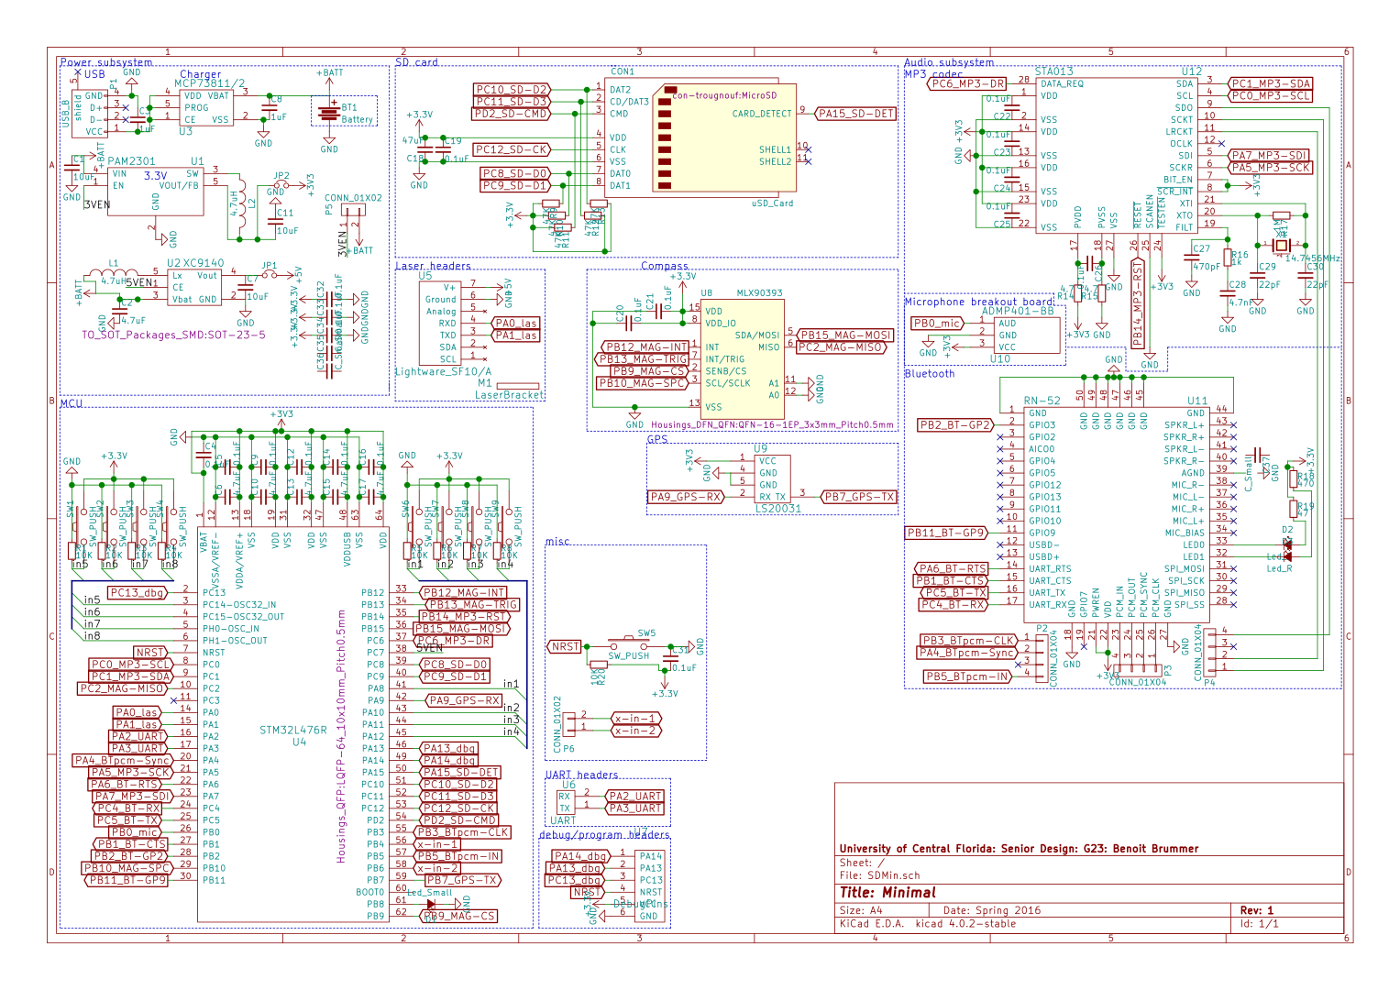
Schematic/Sensewalk9000/FinalPCB/renders/SDMin.sch-noalpha.png
