trougnouf/SeniorDesign/Schematic/Sensewalk9000/FinalPCB/renders/SDMinBack.png

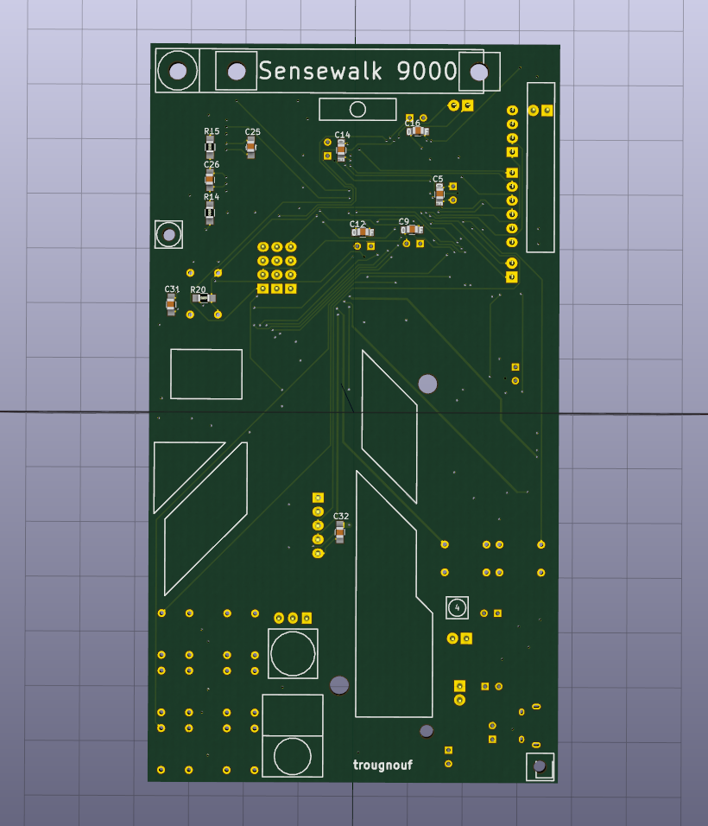
Schematic/Sensewalk9000/FinalPCB/renders/SDMinBack.png
