trougnouf/SeniorDesign/Schematic/Sensewalk9000/KiCAD/render/SDMin4.png

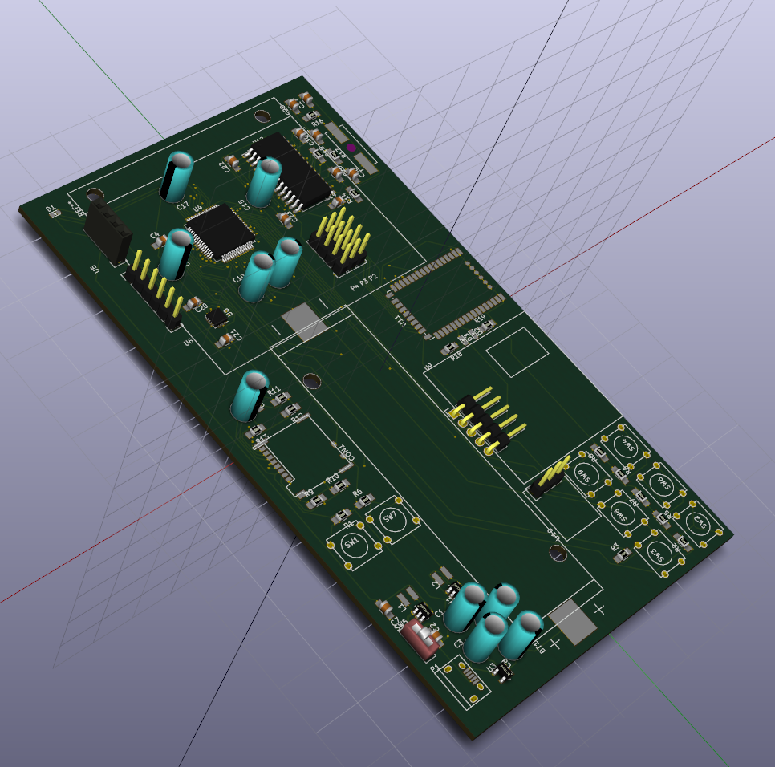
Schematic/Sensewalk9000/KiCAD/render/SDMin4.png
