trougnouf/SeniorDesign/Schematic/Sensewalk9000/KiCAD/render/SDMin.png

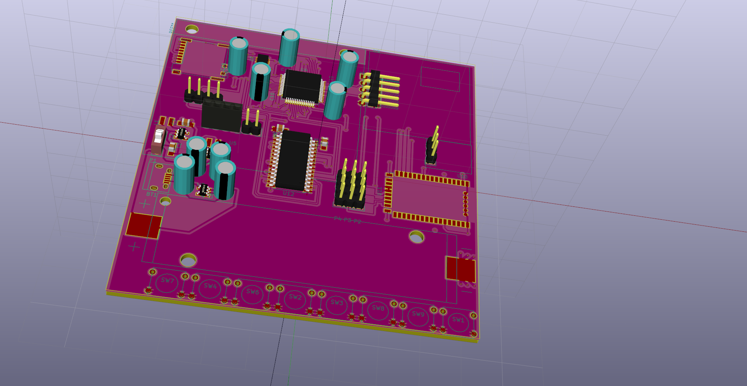
Schematic/Sensewalk9000/KiCAD/render/SDMin.png
