trougnouf/SeniorDesign/Documentation/2016-02-12-Presentation/img/STM32/ST-LINK-RARE-COMPONENTS.png

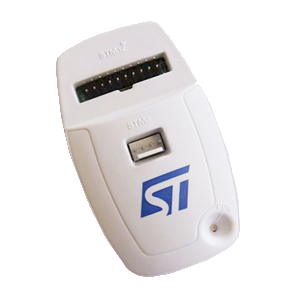
Documentation/2016-02-12-Presentation/img/STM32/ST-LINK-RARE-COMPONENTS.png
