trougnouf/SeniorDesign/Schematic/Sensewalk9000/LaserCutter/sensewalk9000-acrylic.dxf

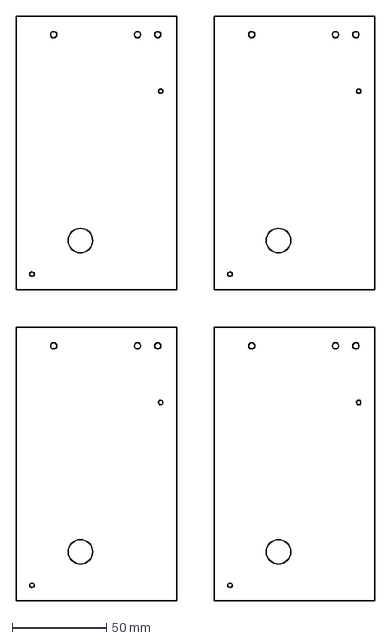
[picture p146: CAD file, 2016-04-16]
Schematic/Sensewalk9000/LaserCutter/sensewalk9000-acrylic.dxf
190.0 x 310.0 mm
