trougnouf/SeniorDesign/Schematic/Sensewalk9000/FinalPCB/renders/SDMin.pdf

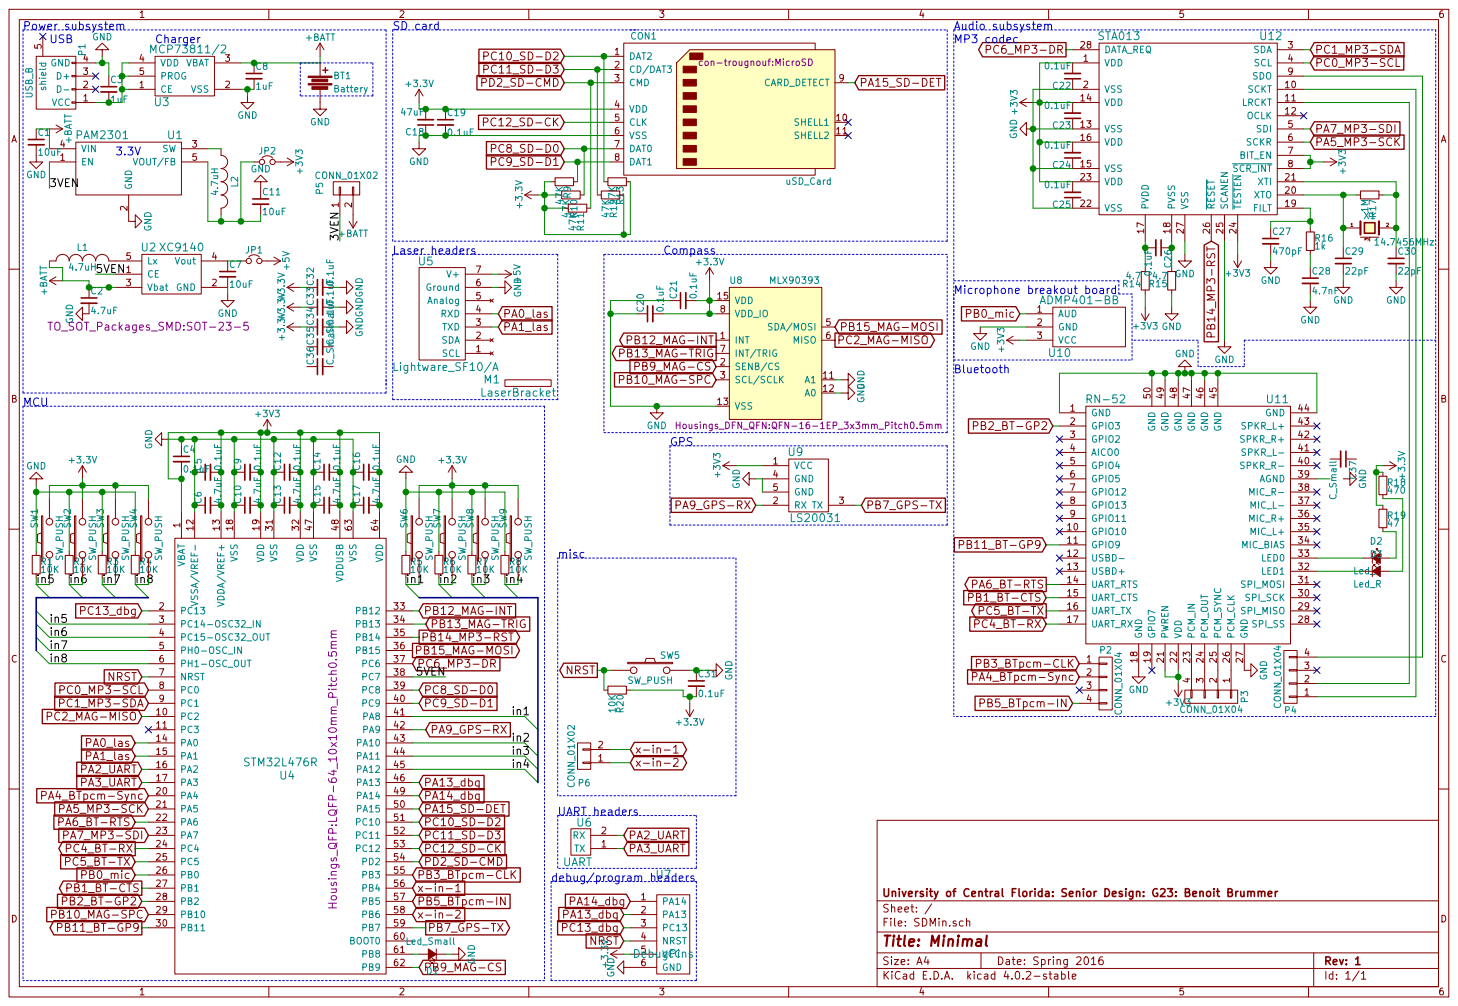
[picture p147: page 1]

SD card
Microphone breakout board Bluetooth MP3 codec PB2_BT-GP2

2 SW 3 VIN 4 VOUT/FB 5 PAM2301 U1 GND

1 PC13 2 PC14-OSC32_IN 3 PC15-OSC32_OUT 4 PH0-OSC_IN 5 PH1-OSC_OUT 6 NRST 7 PC0 8 PC1 9 PC2 10 PA4 20 PB11 30 PC9 40 PA15 50 BOOT0 60 PC3 11 PA5 21 VSS 31 PA8 41 PC10 51 PB8 61 VSSA/VREF- 12 PA6 22 VDD 32 PA9 42 PC11 52 PB9 62 VDDA/VREF+ 13 PA7 23 PB12 33 PA10 43 PC12 53 VSS 63 PA0 14 PC4 24 PB13 34 PA11 44 PD2 54 VDD 64 PA1 15 PC5 25 PB14 35 PA12 45 PB3 55 PA2 16 PB0 26 PB15 36 PA13 46 PB4 56 PA3 17 PB1 27 PC6 37 VSS 47 PB5 57 VSS 18 PB2 28 PC7 38 VDDUSB 48 PB6 58 VDD 19 PB10 29 PC8 39 PA14 49 PB7 59 U4 STM32L476R Housings_QFP:LQFP-64_10x10mm_Pitch0.5mm

Id: 1/1 Title: Minimal File: SDMin.sch Sheet: / University of Central Florida: Senior Design: G23: Benoit Brummer
