trougnouf/SeniorDesign/(list of files, drawings)

Other design files:
Schematic/Sensewalk9000/KiCAD/endlesscopies/SDMin2.dsn
Schematic/Sensewalk9000/KiCAD/endlesscopies/SDMin3c.dsn
Schematic/Sensewalk9000/KiCAD/endlesscopies/SDMin4.dsn
Schematic/Sensewalk9000/KiCAD/endlesscopies/SDMin5c.dsn
Schematic/Sensewalk9000/KiCAD/endlesscopies/SDMin6c.dsn
Schematic/Sensewalk9000/KiCAD/endlesscopies/SDMin7.dsn
Schematic/Sensewalk9000/KiCAD/endlesscopies/SDMin8.dsn
Schematic/Sensewalk9000/KiCAD/endlesscopies/SDMin9.dsn
Schematic/Sensewalk9000/KiCAD/endlesscopies/SDMin10.dsn
Schematic/Sensewalk9000/KiCAD/endlesscopies/SDMin11C.dsn
Schematic/Sensewalk9000/KiCAD/endlesscopies/SDMin12.dsn
Schematic/Sensewalk9000/KiCAD/endlesscopies/SDMin13.dsn
Schematic/Sensewalk9000/KiCAD/endlesscopies/SDMin14.dsn
Schematic/Sensewalk9000/KiCAD/endlesscopies/SDMin15.dsn
Schematic/Sensewalk9000/KiCAD/endlesscopies/SDMin16.dsn
Schematic/Sensewalk9000/KiCAD/endlesscopies/SDMin17.dsn
Schematic/Sensewalk9000/KiCAD/endlesscopies/SDMin18.dsn
Schematic/Sensewalk9000/KiCAD/endlesscopies/SDMin19.dsn
Schematic/Sensewalk9000/KiCAD/endlesscopies/SDMin20.dsn
Schematic/Sensewalk9000/KiCAD/endlesscopies/SDMin21-4.dsn
Schematic/Sensewalk9000/KiCAD/endlesscopies/SDMin22-allauto.dsn
Schematic/Sensewalk9000/KiCAD/endlesscopies/SDMin23.dsn
Schematic/Sensewalk9000/KiCAD/endlesscopies/SDMin24.dsn
Schematic/Sensewalk9000/KiCAD/endlesscopies/SDMin25.dsn
Schematic/Sensewalk9000/KiCAD/endlesscopies/SDMin26.dsn
Schematic/Sensewalk9000/KiCAD/endlesscopies/SDMin.dsn
Schematic/Sensewalk9000/KiCAD/failurethree.dsn
Schematic/Sensewalk9000/KiCAD/failurethree_almostrouted.dsn
Schematic/Sensewalk9000/KiCAD/failurethree_fts.dsn
Schematic/Sensewalk9000/KiCAD/fourcompleteone.dsn
Schematic/Sensewalk9000/KiCAD/SDMin7.dsn
Schematic/Sensewalk9000/KiCAD/SDMin.dsn
