trougnouf/SeniorDesign/Schematic/Sensewalk9000/KiCAD/SDMin.kicad_pcb

## KiCad design Schematic/Sensewalk9000/KiCAD/SDMin.kicad_pcb (2016-02-29)

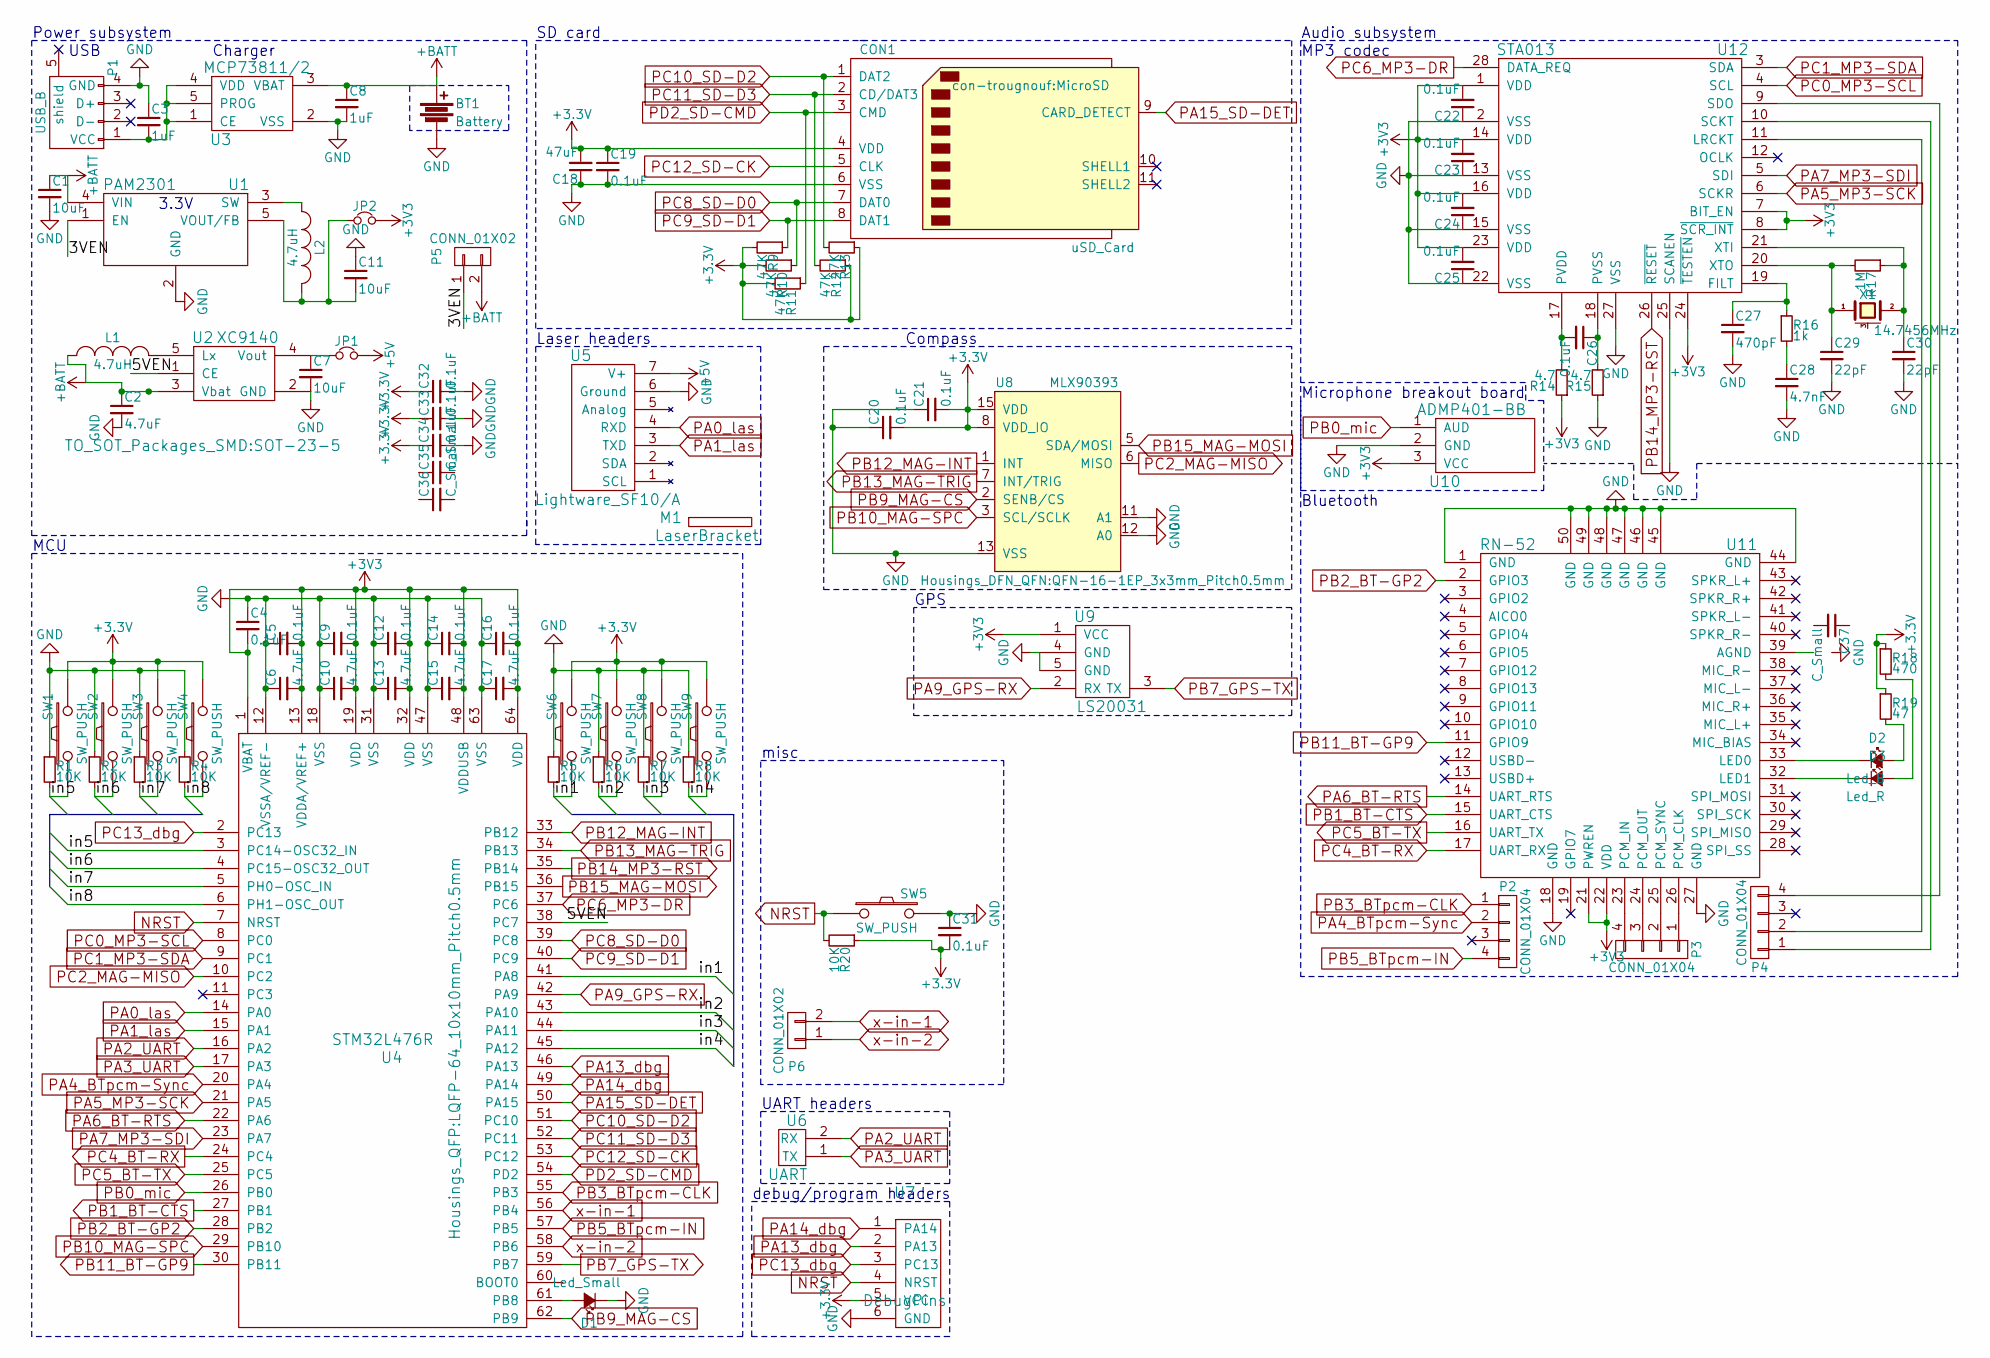
[picture p148: schematic SDMin.sch, Minimal]

Parts:
BT1: Battery; 18650BatteryHolder
C1, C11: 10uF; C_Radial_D5_L11_P2.5
C2: 4.7uF; C_0805_HandSoldering
C3, C8: 1uF; C_Radial_D5_L11_P2.5
C4, C5, C9, C12, C14, C16, C19, C20, C21, C22, C23, C24, C25, C26, C31, C32, C33, C34: 0.1uF; C_0805_HandSoldering
C6, C10, C13, C15, C17: 4.7uF; C_Radial_D5_L11_P2.5
C7: 10uF; C_0805_HandSoldering
C18: 47uF; C_Radial_D5_L11_P2.5
C27: 470pF; C_0805_HandSoldering
C28: 4.7nF; C_0805_HandSoldering
C29, C30: 22pF; C_0805_HandSoldering
C35, C36, C37: C_Small
CON1: uSD_Card; MicroSD
D1: Led_Small; LED_0603
D2: Led_B; LED_0603
D3: Led_R; LED_0603
JP1, JP2: Jumper_NC_Small; Pin_Header_Straight_1x02
L1, L2: 4.7uH; Neosid_Inductor_SM-NE29_SMD1008
M1: LaserBracket; LaserHolder
P1: USB_B; USB_Micro-B
P2, P3, P4: CONN_01X04; Pin_Header_Straight_1x04
P5: CONN_01X02; Pin_Header_Straight_1x02
P6: CONN_01X02; Socket_Strip_Straight_1x02
R1, R2, R3, R4, R5, R6, R7, R8, R20: 10K; R_0805_HandSoldering
R9, R10, R11, R12, R13: 47K; R_0805_HandSoldering
R14, R15: 4.7; R_0805_HandSoldering
R16: 1k; R_0805_HandSoldering
R17: 1M; R_0805_HandSoldering
R18: 470; R_0805_HandSoldering
R19: 47; R_0805_HandSoldering
SW1, SW2, SW3, SW4, SW5, SW6, SW7, SW8, SW9: SW_PUSH; SW_PUSH_SMALL
U1: PAM2301; SOT-23-5
U2: XC9140; SOT-23-5
U3: MCP73811/2; SOT-23-5
U4: STM32L476R; LQFP-64_10x10mm_Pitch0.5mm
U5: Lightware_SF10/A; Socket_Strip_Straight_1x04_3467
U6: UART; Socket_Strip_Straight_1x02
U7: DebugPins; Socket_Strip_Straight_1x06
U8: MLX90393; QFN-16-1EP_3x3mm_Pitch0.5mm
U9: LS20031; LS20031+H
U10: ADMP401-BB; INMP401-bb
U11: RN-52
U12: STA013; SOIC-28_7.5x17.9mm_Pitch1.27mm
X1: 14.7456MHz; Crystal_HC49-SD_SMD

Connections:
+5V: JP1.2, U5.7 (V+)
+BATT: BT1.1, C1.1, C2.1, C8.1, L1.1, P5.2, U1.4 (VIN), U2.3 (Vbat), U3.3 (VBAT)
/3VEN: P5.1, U1.1 (EN)
/5VEN: U2.1 (CE), U4.38 (PC7)
/in1: R5.2, SW6.1, U4.41 (PA8)
/in2: R6.2, SW7.1, U4.43 (PA10)
/in3: R7.2, SW8.1, U4.44 (PA11)
/in4: R8.2, SW9.1, U4.45 (PA12)
/in5: R1.2, SW1.1, U4.3 (PC14-OSC32_IN)
/in6: R2.2, SW2.1, U4.4 (PC15-OSC32_OUT)
/in7: R3.2, SW3.1, U4.5 (PH0-OSC_IN)
/in8: R4.2, SW4.1, U4.6 (PH1-OSC_OUT)
NRST: R20.2, SW5.1, U4.7 (NRST), U7.4 (NRST)
unnamed: C3.2, P1.1 (VCC), U3.1 (CE), U3.4 (VDD), U3.5 (PROG)
unnamed: C7.1, JP1.1, U2.4 (Vout)
unnamed: C11.2, JP2.1, L2.2, U1.5 (VOUT/FB)
unnamed: C26.1, R15.2, U12.18 (PVSS)
unnamed: C26.2, R14.2, U12.17 (PVDD)
unnamed: C27.1, R16.1, U12.19 (FILT)
unnamed: C28.1, R16.2
unnamed: C29.1, R17.2, U12.20 (XTO), X1.1
unnamed: C30.1, R17.1, U12.21 (XTI), X1.2
unnamed: D1.2 (A), U4.61 (PB8)
unnamed: D2.1 (K), U11.33 (LED0)
unnamed: D2.2 (A), R19.2
unnamed: D3.1 (K), U11.32 (LED1)
unnamed: D3.2 (A), R18.2
unnamed: L1.2, U2.5 (Lx)
unnamed: L2.1, U1.3 (SW)
unnamed: P3.1, U11.26 (PCM_CLK)
unnamed: P3.2, U11.25 (PCM_SYNC)
unnamed: P3.3, U11.24 (PCM_OUT)
unnamed: P3.4, U11.23 (PCM_IN)
unnamed: P4.1, U12.10 (SCKT)
unnamed: P4.2, U12.11 (LRCKT)
unnamed: P4.4, U12.9 (SDO)
PA0_las: U4.14 (PA0), U5.4 (RXD)
PA1_las: U4.15 (PA1), U5.3 (TXD)
PA2_UART: U4.16 (PA2), U6.2 (RX)
PA3_UART: U4.17 (PA3), U6.1 (TX)
PA4_BTpcm-Sync: P2.2, U4.20 (PA4)
PA5_MP3-SCK: U4.21 (PA5), U12.6 (SCKR)
PA6_BT-RTS: U4.22 (PA6), U11.14 (UART_RTS)
PA7_MP3-SDI: U4.23 (PA7), U12.5 (SDI)
PA9_GPS-RX: U4.42 (PA9), U9.2 (RX)
PA13_dbg: U4.46 (PA13), U7.2 (PA13)
PA14_dbg: U4.49 (PA14), U7.1 (PA14)
PA15_SD-DET: CON1.9 (CARD_DETECT), U4.50 (PA15)
PB0_mic: U4.26 (PB0), U10.1 (AUD)
PB1_BT-CTS: U4.27 (PB1), U11.15 (UART_CTS)
PB2_BT-GP2: U4.28 (PB2), U11.2 (GPIO3)
PB3_BTpcm-CLK: P2.1, U4.55 (PB3)
PB5_BTpcm-IN: P2.4, U4.57 (PB5)
PB7_GPS-TX: U4.59 (PB7), U9.3 (TX)
PB9_MAG-CS: U4.62 (PB9), U8.2 (SENB/CS)
PB10_MAG-SPC: U4.29 (PB10), U8.3 (SCL/SCLK)
PB11_BT-GP9: U4.30 (PB11), U11.11 (GPIO9)
PB12_MAG-INT: U4.33 (PB12), U8.1 (INT)
PB13_MAG-TRIG: U4.34 (PB13), U8.7 (INT/TRIG)
PB14_MP3-RST: U4.35 (PB14), U12.26 (~RESET)
PB15_MAG-MOSI: U4.36 (PB15), U8.5 (SDA/MOSI)
PC0_MP3-SCL: U4.8 (PC0), U12.4 (SCL)
PC1_MP3-SDA: U4.9 (PC1), U12.3 (SDA)
PC2_MAG-MISO: U4.10 (PC2), U8.6 (MISO)
PC4_BT-RX: U4.24 (PC4), U11.17 (UART_RX)
PC5_BT-TX: U4.25 (PC5), U11.16 (UART_TX)
PC6_MP3-DR: U4.37 (PC6), U12.28 (DATA_REQ)
PC8_SD-D0: CON1.7 (DAT0), R10.1, U4.39 (PC8)
PC9_SD-D1: CON1.8 (DAT1), R9.1, U4.40 (PC9)
PC10_SD-D2: CON1.1 (DAT2), R13.2, U4.51 (PC10)
PC11_SD-D3: CON1.2 (CD/DAT3), R12.2, U4.52 (PC11)
PC12_SD-CK: CON1.5 (CLK), U4.53 (PC12)
PC13_dbg: U4.2 (PC13), U7.3 (PC13)
PD2_SD-CMD: CON1.3 (CMD), R11.1, U4.54 (PD2)
x-in-1: P6.2, U4.56 (PB4)
x-in-2: P6.1, U4.58 (PB6)

Notes on the sheet:
Power subsystem
Compass
MCU
SD card
debug/program headers
Laser headers
UART headers
GPS
Audio subsystem
Microphone breakout board
Bluetooth
MP3 codec
USB
Charger
3.3V
misc

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
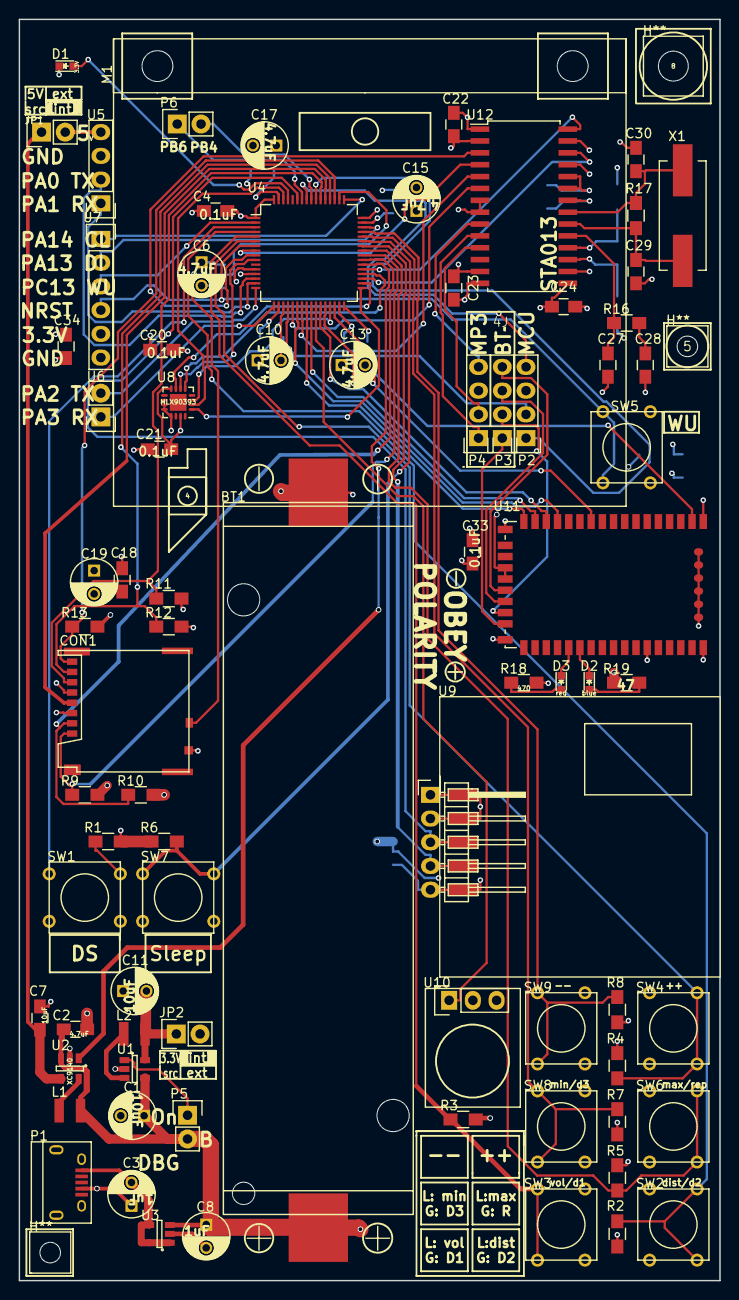
[picture p149: board SDMin.kicad_pcb from above]

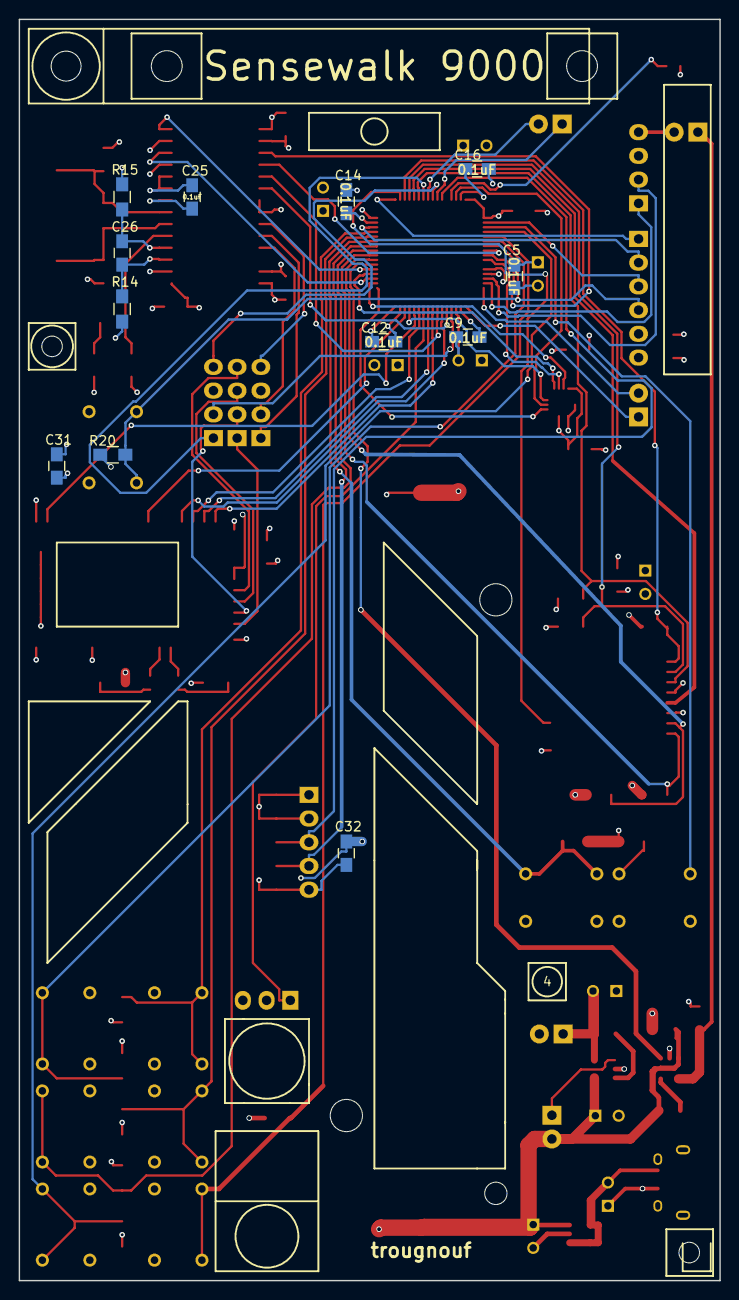
[picture p150: board SDMin.kicad_pcb from below]

Board: 4 copper layers, 75.0 x 135.0 mm, 95 parts (12 on the bottom side), 78 nets.

Other parts of the board:
H**: H2.2; mountinghole2.2
H**#2: 3.2H; mountinghole3.2
H**#3: H2.2; mountinghole2.2
