trougnouf/SeniorDesign/Schematic/Sensewalk2/Ross/eagal/offical board.brd

## EAGLE design Schematic/Sensewalk2/Ross/eagal/offical board.brd (2016-02-07)

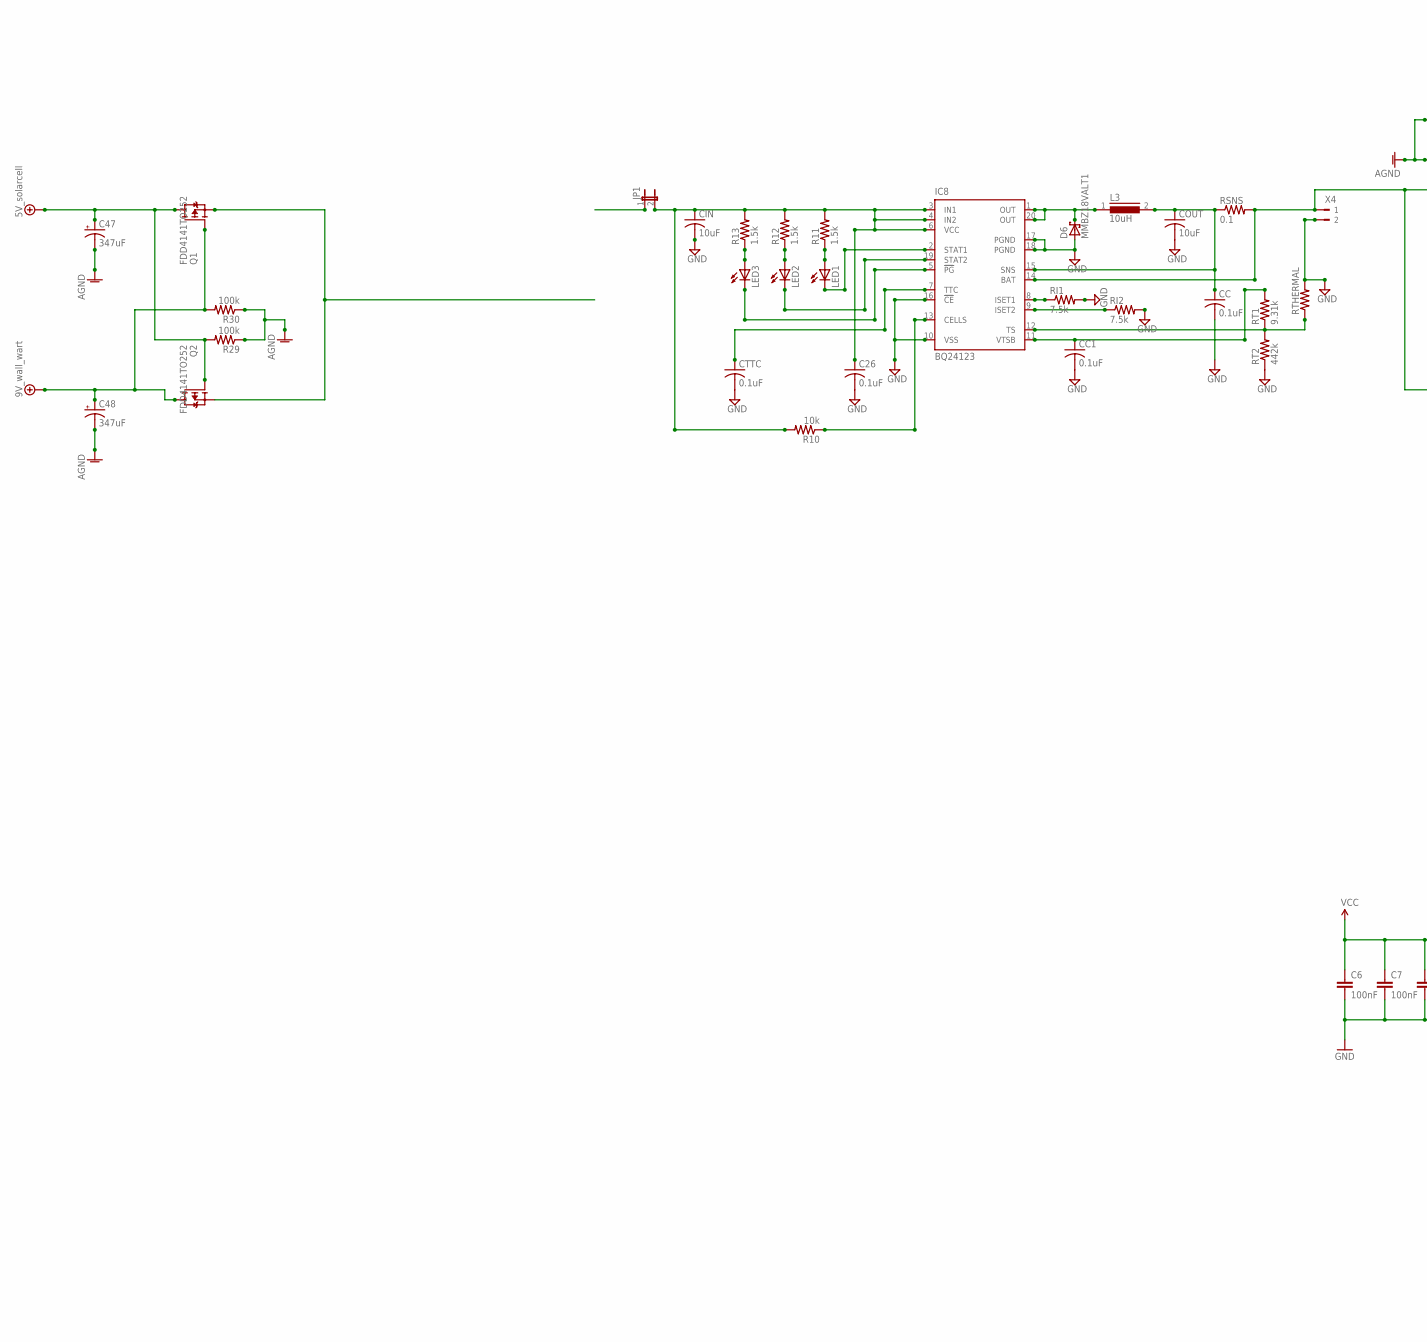
[picture p151: schematic offical board.sch, part in row 1, column 1]

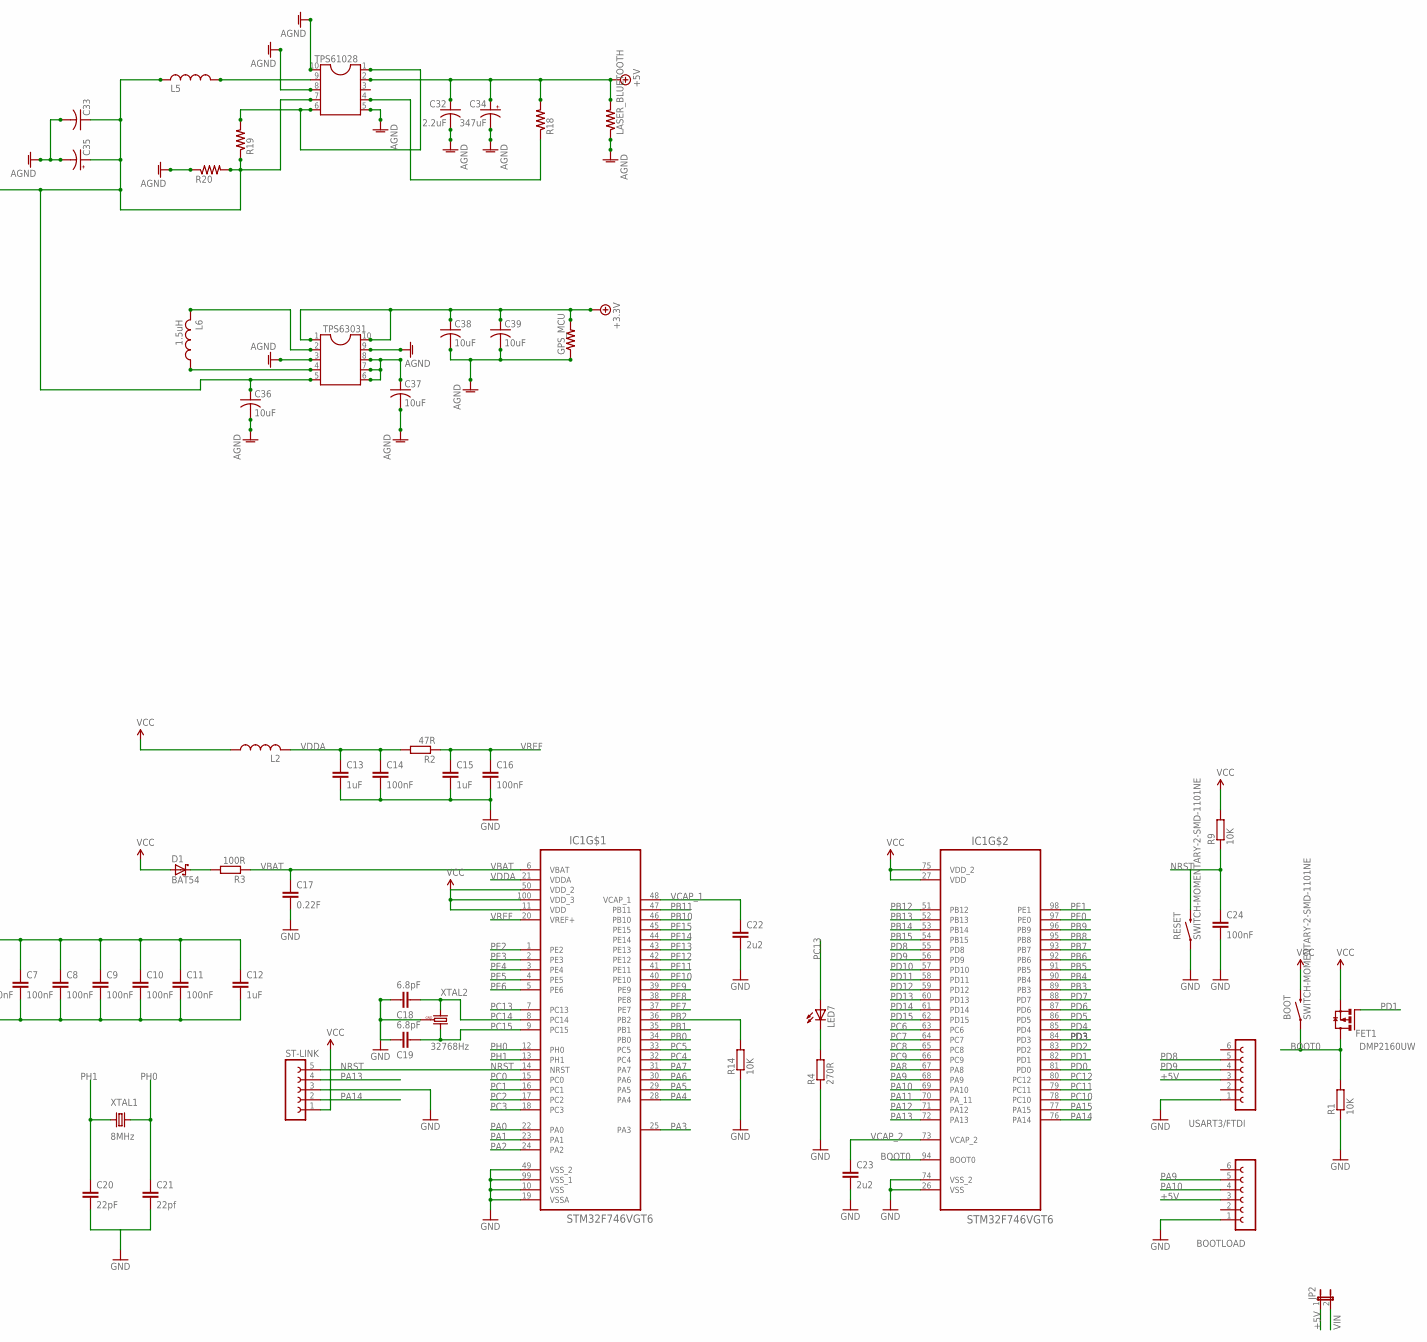
[picture p152: schematic offical board.sch, part in row 1, column 2]

Parts:
BOOT: SWITCH-MOMENTARY-2-SMD-1101NE; TACTILE-SWITCH-1101NE
BOOTLOAD: FE06-1; FE06
C6, C7, C8, C9, C10, C11, C14, C16, C24: 100nF; C0603
C12, C13, C15: 1uF; C0603
C17: 0.22F; C5B5
C18, C19: 6.8pF; C0603
C20: 22pF; C0603
C21: 22pf; C0603
C22, C23: 2u2; C0603
C26: 0.1uF; C0805
C32: 2.2uF; C0603
C33: C-USC0603; C0603
C34, C47, C48: 347uF; 150CLZ-0810
C35: CPOL-US150CLZ-0810; 150CLZ-0810
C36, C37, C38, C39: 10uF; C0603
CC, CC1: 0.1uF; C0805
CIN: 10uF; C0805
COUT: 10uF; C0805
CTTC: 0.1uF; C0805
D1: BAT54; SOT23
D6: MMBZ18VALT1; C4111-15
FET1: DMP2160UW; SUPER-SOT3
GPS_MCU: R-US_R0603; R0603
IC1: STM32F746VGT6; QFP50P1600X1600X160-100N
IC8: BQ24123; QFN20_3,5X4,5
JP1, JP2: JP1E; JP1
L2: RCL_L-USL0603; RCL_L0603
L3: 10uH; DR73
L5: L-USL2825P; L2825P
L6: 1.5uH; L2825P
LASER_BLUETOOTH: R-US_R0603; R0603
LED1, LED2, LED3: SFH482
LED7: LEDCHIP-LED0603; CHIP-LED0603
Q1, Q2: FDD4141TO252; TO252
R1, R9, R14: 10K; R0603
R2: 47R; R0603
R3: 100R; R0603
R4: 270R; R0603
R10: 10k; R0805
R11, R12, R13: 1.5k; R0805
R18, R19, R20: R-US_R0603; R0603
R29, R30: 100k; R0603
RESET: SWITCH-MOMENTARY-2-SMD-1101NE; TACTILE-SWITCH-1101NE
RI1, RI2: 7.5k; R0805
RSNS: 0.1; R1206
RT1: 9.31k; R0805
RT2: 442k; R0805
RTHERMAL: R-US_R0805; R0805
ST-LINK: FE05-1
TPS61028, TPS63031: DIL10
USART3/FTDI: FE06-1; FE06
X4: 90-2
XTAL1: 8MHz; HC49U-V
XTAL2: 32768Hz; CRYSTAL_TC26H_3_REPAIR_SMD_SMALL_PITCH

Connections:
+5V: BOOTLOAD.3, C32.1, C34.+, C38.1, C39.1, C47.+, C48.+, GPS_MCU.2, JP2.1, LASER_BLUETOOTH.2, Q1.1 (G), Q1.3 (D), Q2.1 (G), Q2.3 (D), R18.2, R29.2, R30.2, TPS61028.2, TPS63031.1, TPS63031.10, USART3/FTDI.3
AGND: C32.2, C33.2, C34.-, C35.-, C36.2, C37.2, C38.2, C39.2, C47.-, C48.-, GPS_MCU.1, LASER_BLUETOOTH.1, R20.1, R29.1, R30.1, TPS61028.5, TPS61028.8, TPS61028.10, TPS63031.3, TPS63031.9
BOOT0: BOOT.P$1 (1), FET1.3 (D), IC1.94 (BOOT0), R1.2
GND: BOOTLOAD.1, C6.2, C7.2, C8.2, C9.2, C10.2, C11.2, C12.2, C13.2, C14.2, C15.2, C16.2, C17.2, C18.2, C19.2, C20.2, C21.2, C22.2, C23.2, C24.2, C26.2, CC.2, CC1.2, CIN.2, COUT.2, CTTC.2, D6.A, IC1.10 (VSS), IC1.19 (VSSA), IC1.26 (VSS), IC1.49 (VSS_2), IC1.74 (VSS_2), IC1.99 (VSS_1), IC8.10 (VSS), IC8.16 (!CE), IC8.17 (PGND), IC8.18 (PGND), R1.1, R4.1, R14.1, RESET.P$1 (1), RI1.2, RI2.2, RT2.1, RTHERMAL.2, ST-LINK.3, USART3/FTDI.1, X4.2, XTAL2.GND
unnamed: Q1.2 (S), Q2.2 (S)
unnamed: D6.C, IC8.1 (OUT), IC8.20 (OUT), L3.1
unnamed: CC.1, COUT.1, IC8.15 (SNS), L3.2, RSNS.1
unnamed: IC8.8 (ISET1), RI1.1
unnamed: IC8.9 (ISET2), RI2.1
unnamed: IC8.12 (TS), RT1.1, RT2.2, RTHERMAL.1
unnamed: CC1.1, IC8.11 (VTSB), RT1.2
unnamed: LED3.A, R13.1
unnamed: LED2.A, R12.1
unnamed: LED1.A, R11.1
unnamed: IC8.2 (STAT1), LED1.K (C)
unnamed: IC8.19 (STAT2), LED2.K (C)
unnamed: IC8.5 (!PG), LED3.K (C)
unnamed: CTTC.1, IC8.7 (TTC)
unnamed: IC8.13 (CELLS), R10.1
unnamed: C26.1, CIN.1, IC8.3 (IN1), IC8.4 (IN2), IC8.6 (VCC), JP1.2, R10.2, R11.2, R12.2, R13.2
unnamed: D1.3 (C), R3.2
unnamed: R18.1, TPS61028.4
unnamed: R19.2, TPS61028.1, TPS61028.6
unnamed: L5.1, TPS61028.9
unnamed: C33.1, C35.+, C36.1, IC8.14 (BAT), L5.2, R19.1, R20.2, RSNS.2, TPS61028.7, TPS63031.5, X4.1
unnamed: L6.2, TPS63031.2
unnamed: L6.1, TPS63031.4
unnamed: C37.1, TPS63031.6, TPS63031.7, TPS63031.8
unnamed: LED7.C, R4.2
NRST: C24.1, IC1.14 (NRST), R9.1, RESET.P$2 (2), ST-LINK.5
PA0: IC1.22 (PA0)
PA1: IC1.23 (PA1)
PA2: IC1.24 (PA2)
PA3: IC1.25 (PA3)
PA4: IC1.28 (PA4)
PA5: IC1.29 (PA5)
PA6: IC1.30 (PA6)
PA7: IC1.31 (PA7)
PA8: IC1.67 (PA8)
PA9: BOOTLOAD.5, IC1.68 (PA9)
PA10: BOOTLOAD.4, IC1.69 (PA10)
PA11: IC1.70 (PA_11)
PA12: IC1.71 (PA12)
PA13: IC1.72 (PA13), ST-LINK.4
PA14: IC1.76 (PA14), ST-LINK.2
PA15: IC1.77 (PA15)
PB0: IC1.34 (PB0)
PB1: IC1.35 (PB1)
PB2: IC1.36 (PB2), R14.2
PB3: IC1.89 (PB3)
PB4: IC1.90 (PB4)
PB5: IC1.91 (PB5)
PB6: IC1.92 (PB6)
PB7: IC1.93 (PB7)
PB8: IC1.95 (PB8)
PB9: IC1.96 (PB9)
PB10: IC1.46 (PB10)
PB11: IC1.47 (PB11)
PB12: IC1.51 (PB12)
PB13: IC1.52 (PB13)
PB14: IC1.53 (PB14)
PB15: IC1.54 (PB15)
PC0: IC1.15 (PC0)
PC1: IC1.16 (PC1)
PC2: IC1.17 (PC2)
PC3: IC1.18 (PC3)
PC4: IC1.32 (PC4)
PC5: IC1.33 (PC5)
PC6: IC1.63 (PC6)
PC7: IC1.64 (PC7)
PC8: IC1.65 (PC8)
PC9: IC1.66 (PC9)
PC10: IC1.78 (PC10)
PC11: IC1.79 (PC11)
PC12: IC1.80 (PC12)
PC13: IC1.7 (PC13), LED7.A
PC14: C18.1, IC1.8 (PC14), XTAL2.1
PC15: C19.1, IC1.9 (PC15), XTAL2.2
PD0: IC1.81 (PD0)
PD1: FET1.1 (G), IC1.82 (PD1)
PD2: IC1.83 (PD2)
PD3: IC1.84 (PD3)
PD4: IC1.85 (PD4)
PD5: IC1.86 (PD5)
PD6: IC1.87 (PD6)
PD7: IC1.88 (PD7)
PD8: IC1.55 (PD8), USART3/FTDI.5
PD9: IC1.56 (PD9), USART3/FTDI.4
PD10: IC1.57 (PD10)
PD11: IC1.58 (PD11)
PD12: IC1.59 (PD12)
PD13: IC1.60 (PD13)
PD14: IC1.61 (PD14)
PD15: IC1.62 (PD15)
PE0: IC1.97 (PE0)
PE1: IC1.98 (PE1)
PE2: IC1.1 (PE2)
PE3: IC1.2 (PE3)
PE4: IC1.3 (PE4)
PE5: IC1.4 (PE5)
PE6: IC1.5 (PE6)
PE7: IC1.37 (PE7)
PE8: IC1.38 (PE8)
PE9: IC1.39 (PE9)
PE10: IC1.40 (PE10)
PE11: IC1.41 (PE11)
PE12: IC1.42 (PE12)
PE13: IC1.43 (PE13)
PE14: IC1.44 (PE14)
PE15: IC1.45 (PE15)
PH0: C21.1, IC1.12 (PH0), XTAL1.2
PH1: C20.1, IC1.13 (PH1), XTAL1.1
VBAT: C17.1, IC1.6 (VBAT), R3.1
VCAP_1: C22.1, IC1.48 (VCAP_1)
VCAP_2: C23.1, IC1.73 (VCAP_2)
VCC: BOOT.P$2 (2), C6.1, C7.1, C8.1, C9.1, C10.1, C11.1, C12.1, D1.1 (A), FET1.2 (S), IC1.11 (VDD), IC1.27 (VDD), IC1.50 (VDD_2), IC1.75 (VDD_2), IC1.100 (VDD_3), L2.1, R9.2, ST-LINK.1
VDDA: C13.1, C14.1, IC1.21 (VDDA), L2.2, R2.2
VIN: JP2.2
VREF: C15.1, C16.1, IC1.20 (VREF+), R2.1

Board: 2 copper layers, 85 parts (0 on the bottom side), 49 nets, no tracks yet.
