trougnouf/SeniorDesign/Schematic/Sensewalk2/Ross/rossrev4/offical board.brd

## EAGLE design Schematic/Sensewalk2/Ross/rossrev4/offical board.brd (2016-04-22)

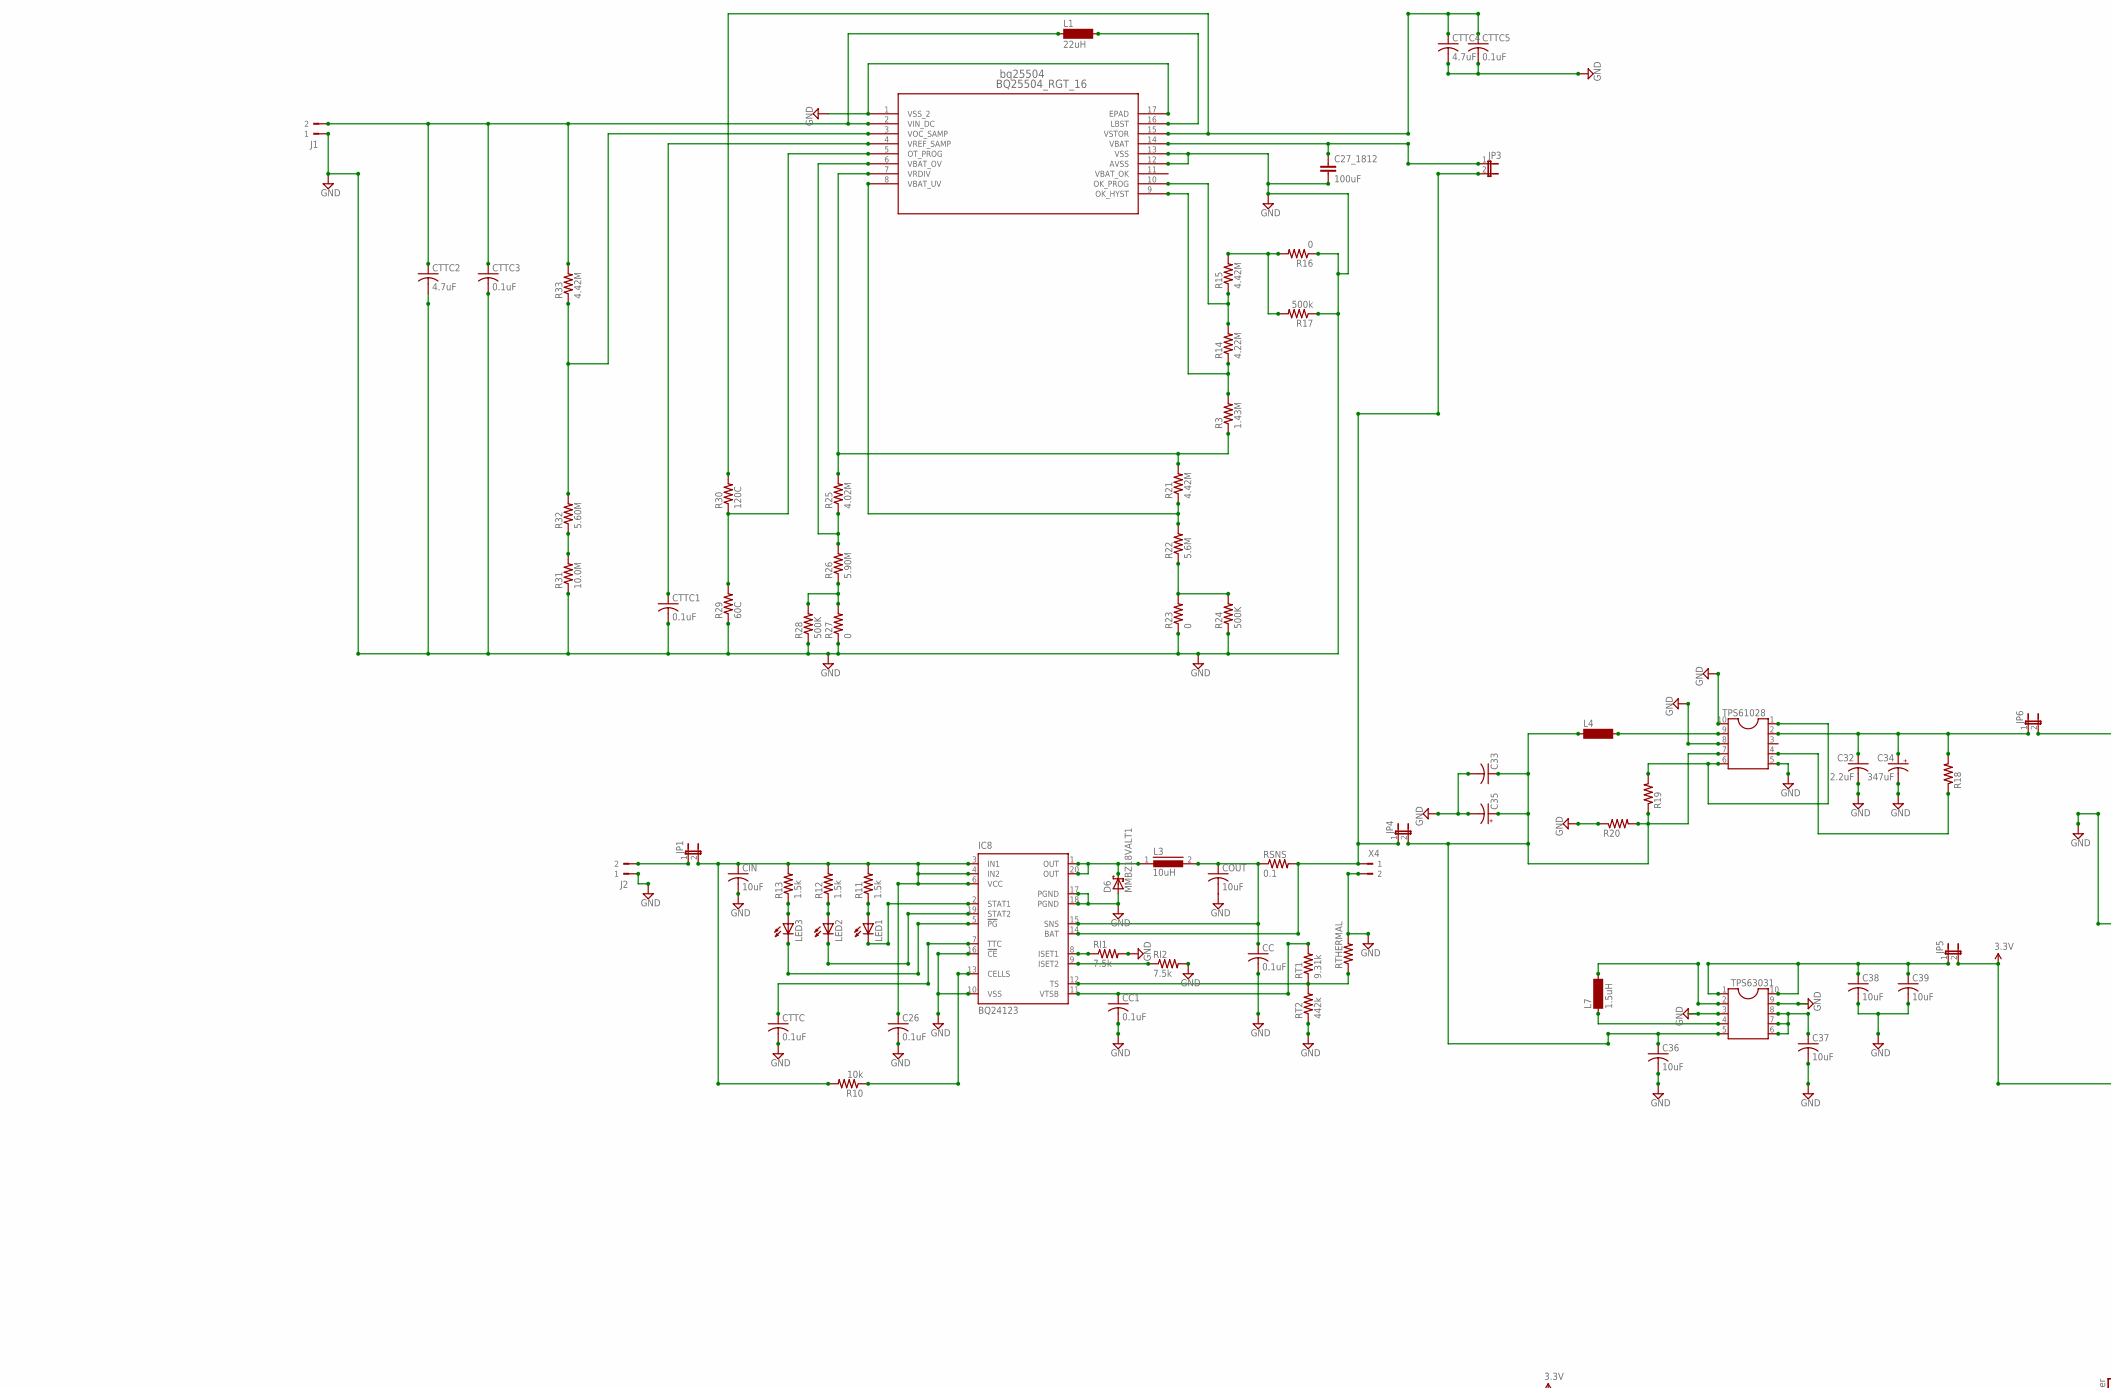
[picture p153: schematic offical board.sch, part in row 1, column 1]

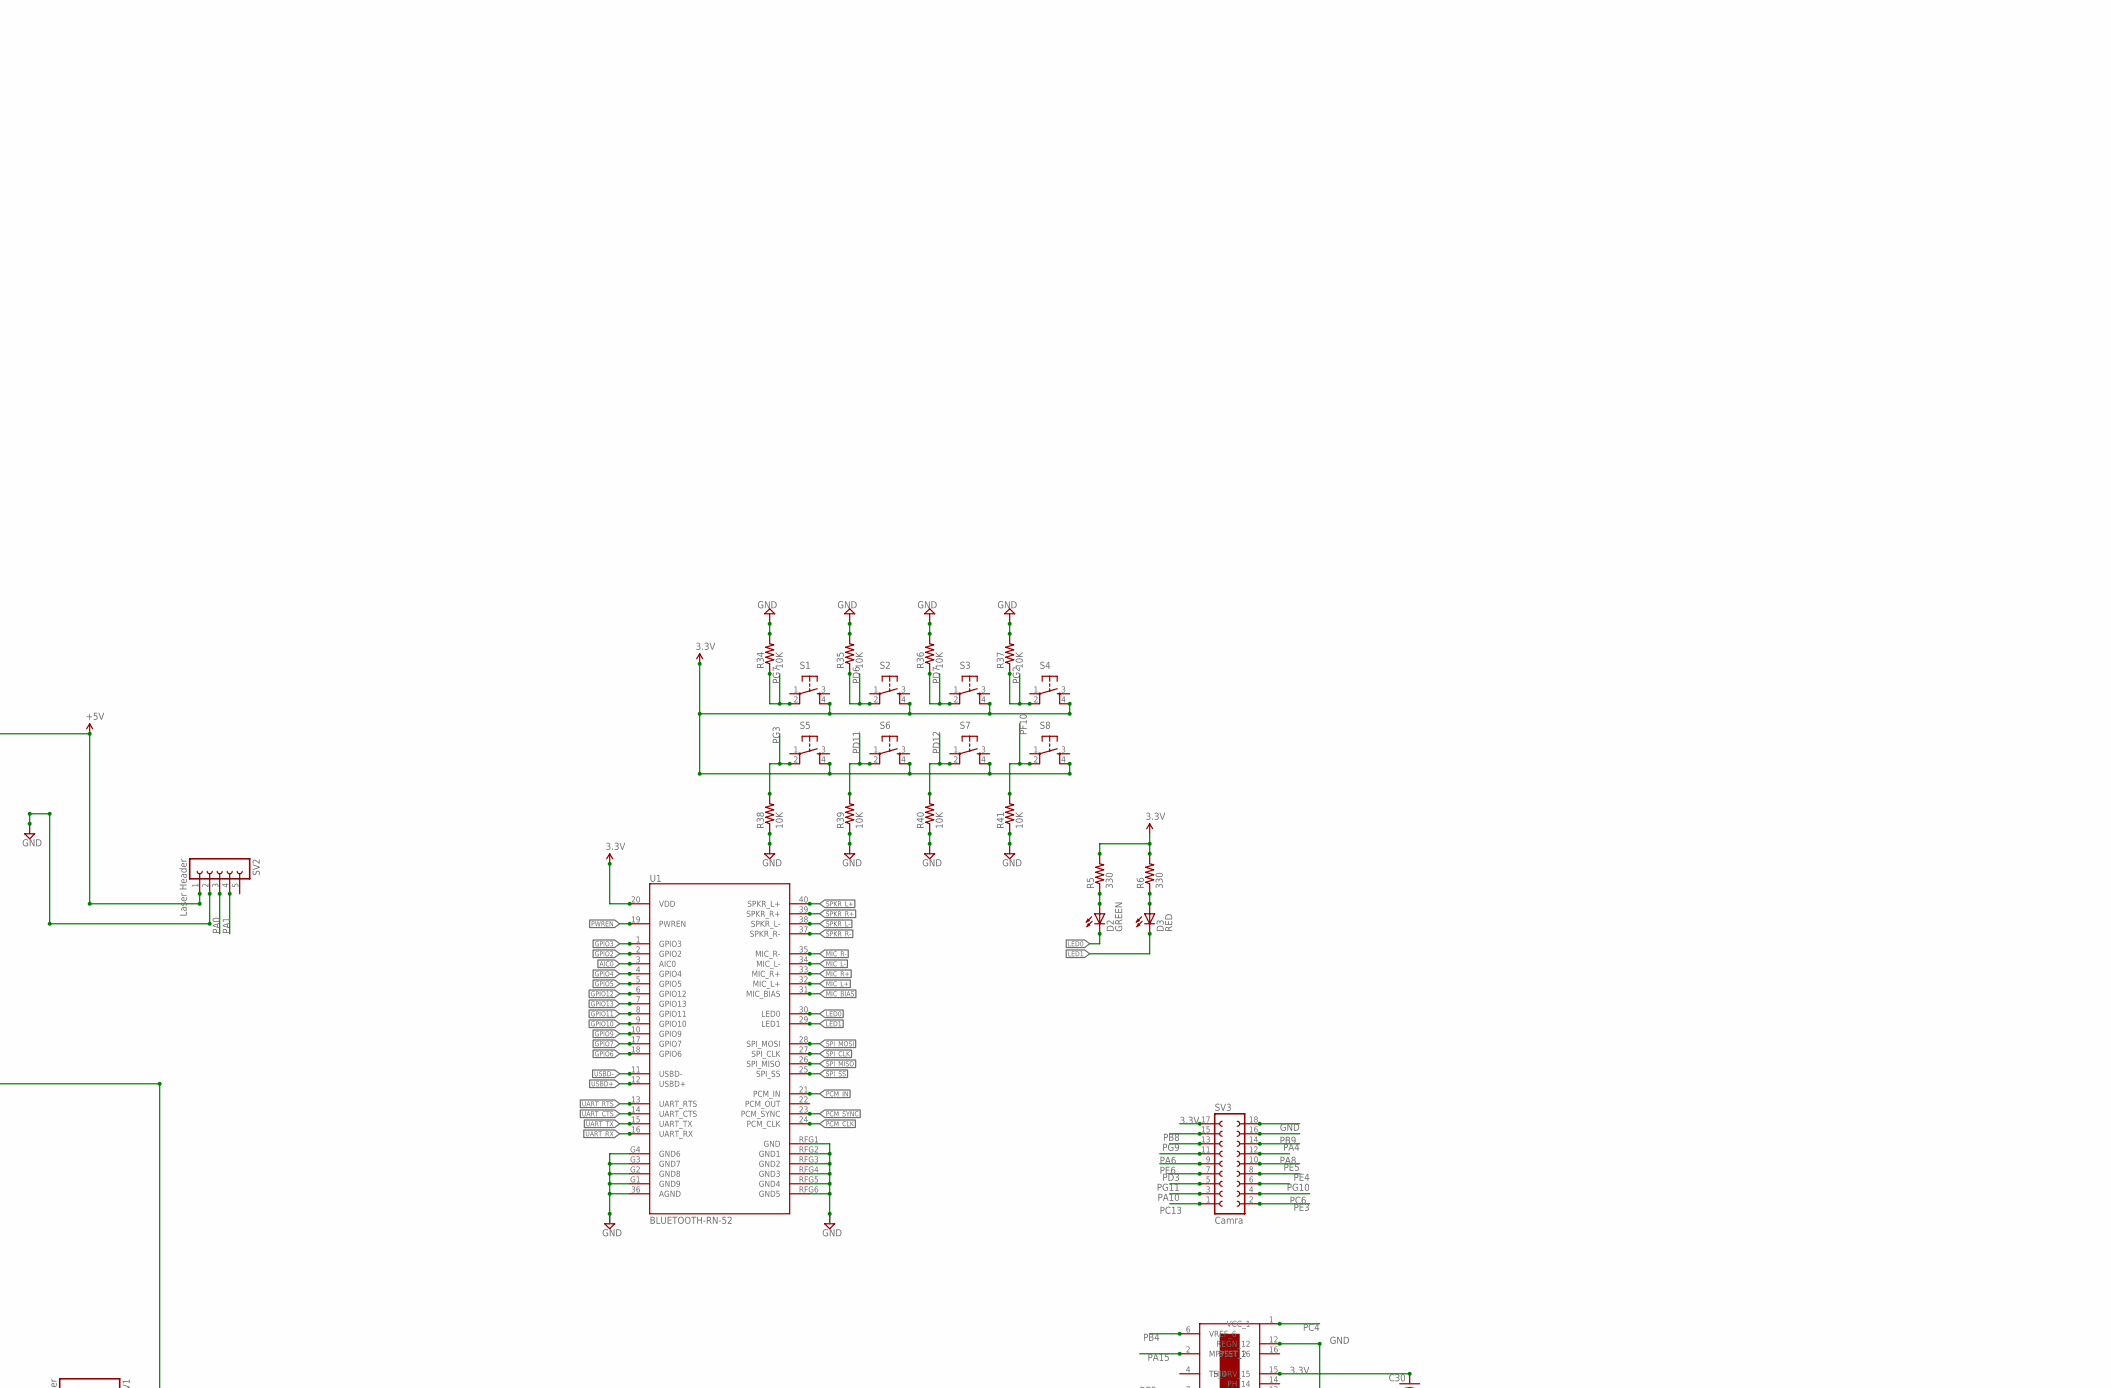
[picture p154: schematic offical board.sch, part in row 1, column 2]

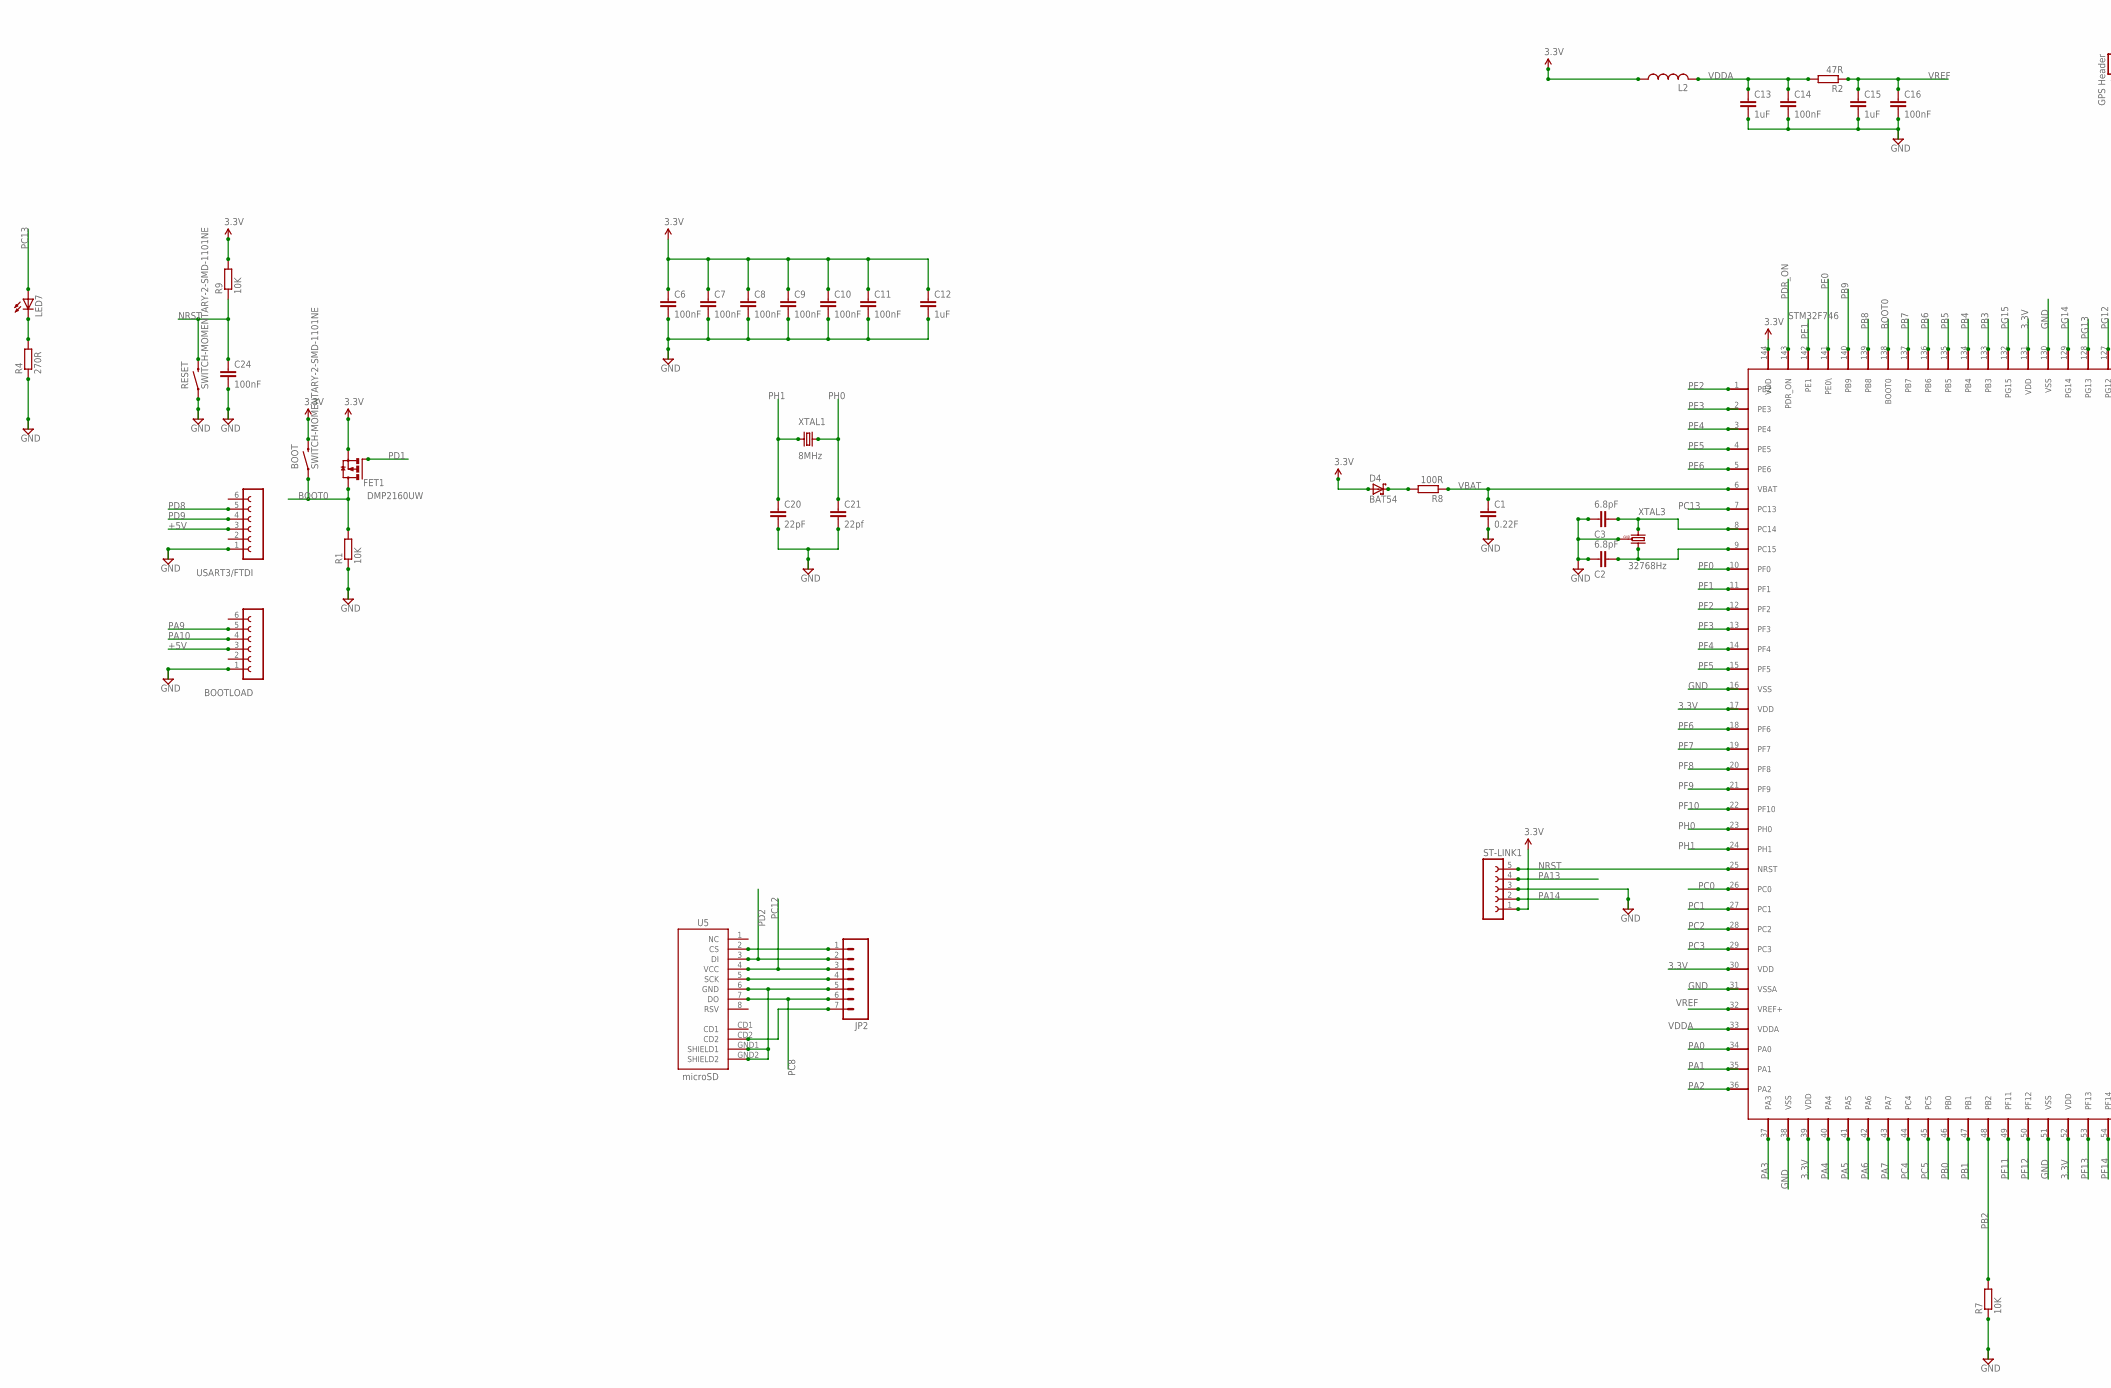
[picture p155: schematic offical board.sch, part in row 2, column 1]

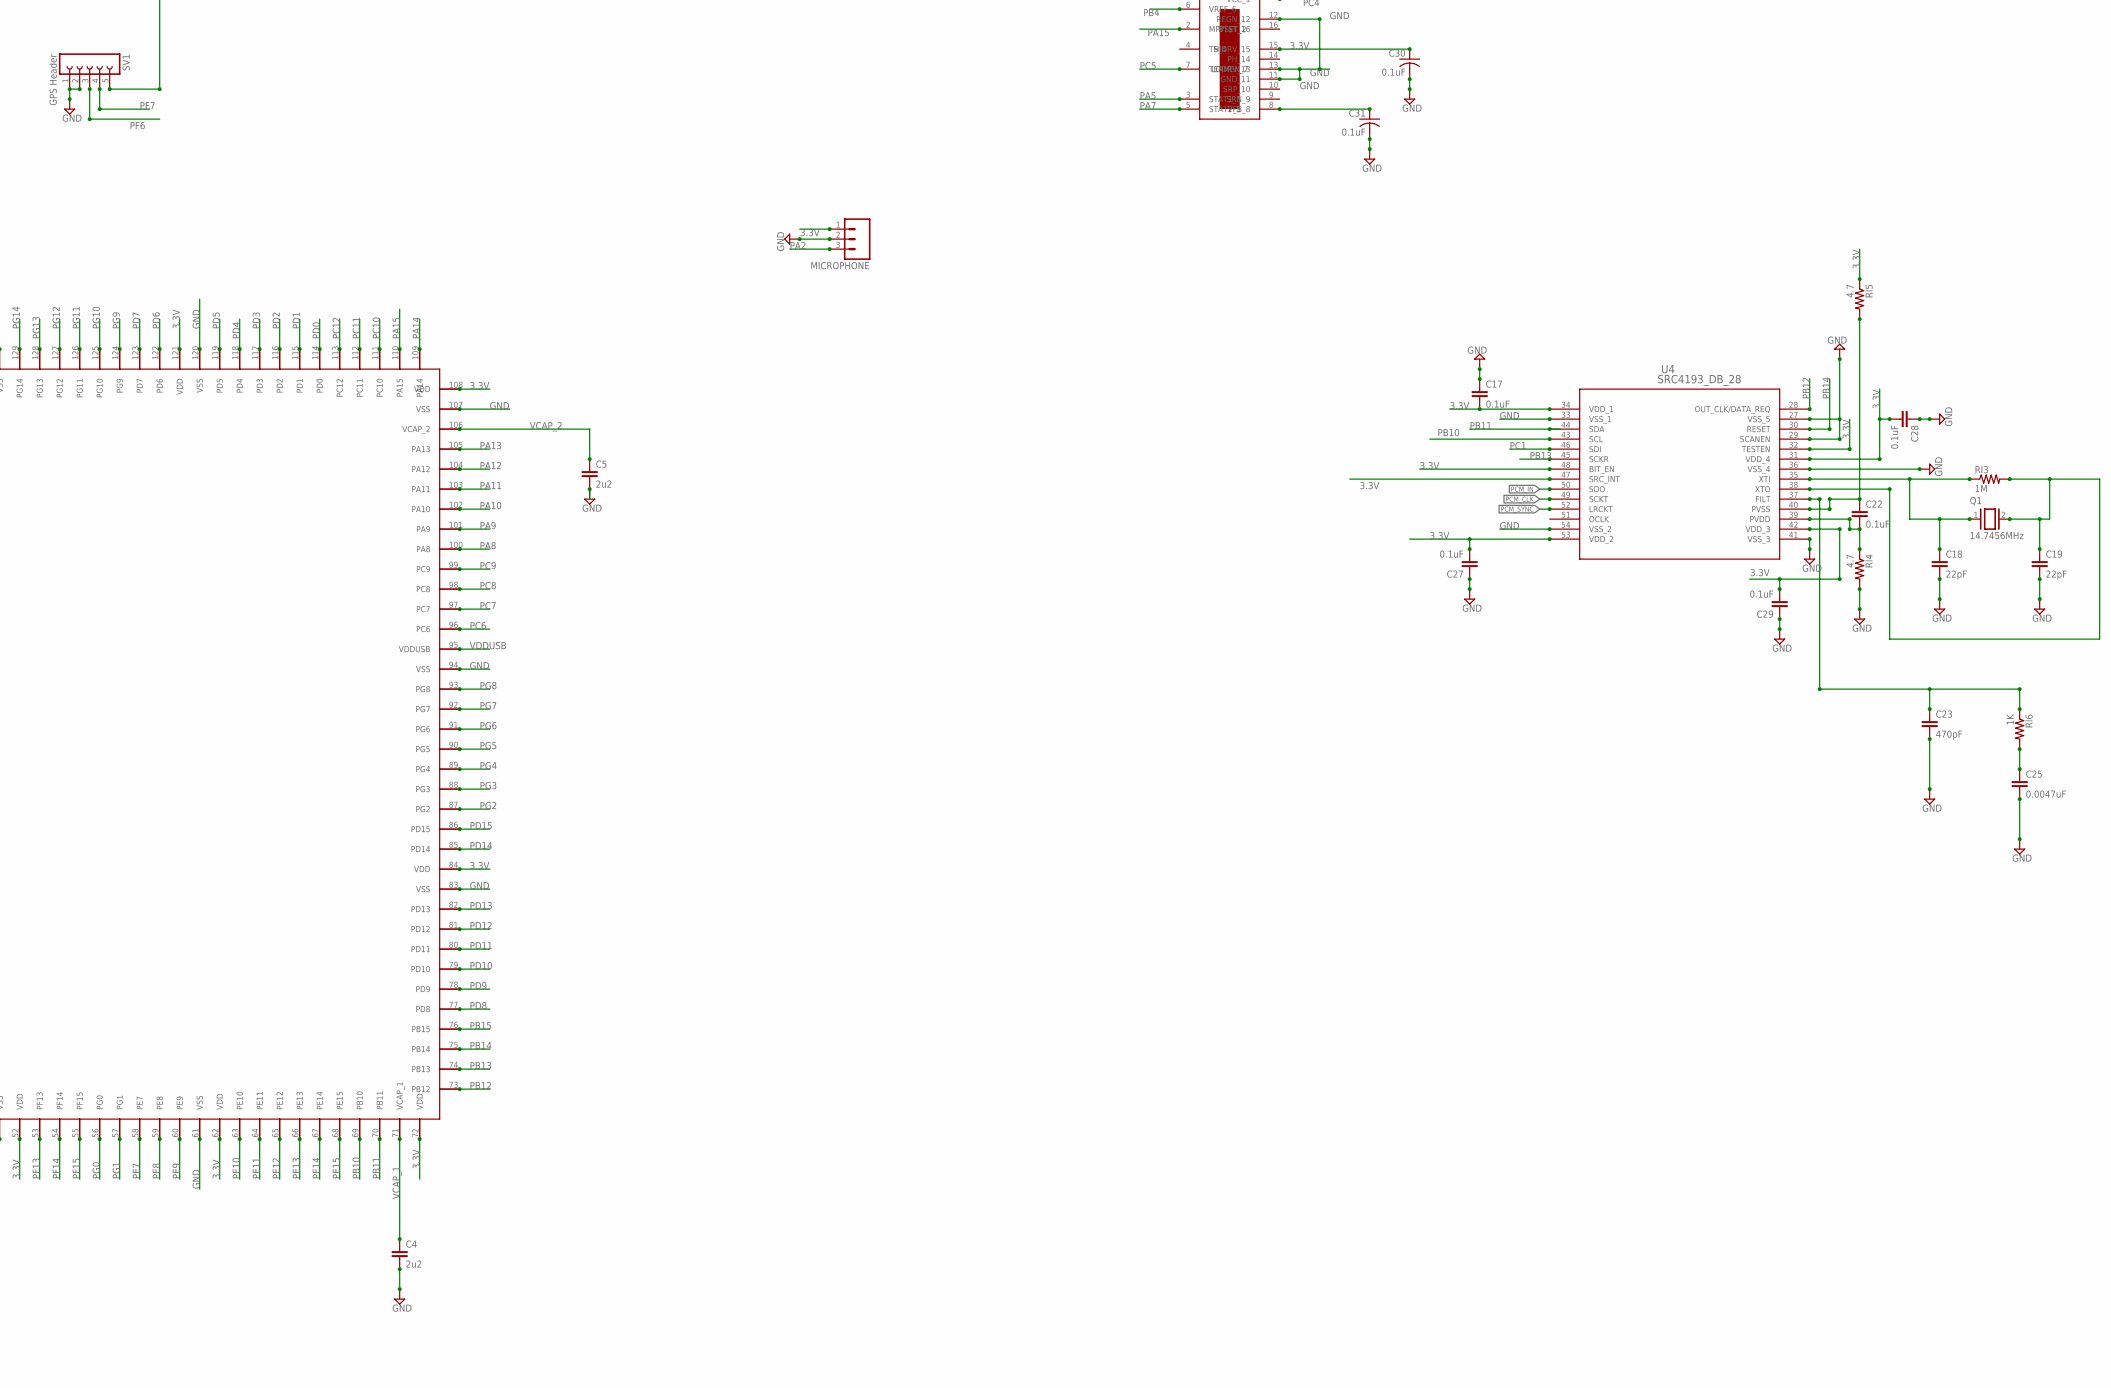
[picture p156: schematic offical board.sch, part in row 2, column 2]

Parts:
BOOT: SWITCH-MOMENTARY-2-SMD-1101NE; TACTILE-SWITCH-1101NE
BOOTLOAD: FE06-1; FE06
C1: 0.22F; C5B5
C2, C3: 6.8pF; C0603
C4, C5: 2u2; C0603
C6, C7, C8, C9, C10, C11, C14, C16, C24: 100nF; C0603
C12, C13, C15: 1uF; C0603
C17, C22, C27, C28, C29, C30, C31: 0.1uF; C0603
C18, C19, C20: 22pF; C0603
C21: 22pf; C0603
C23: 470pF; C0603
C25: 0.0047uF; C0603
C26: 0.1uF; C0805
C27_1812: 100uF; C1812
C32: 2.2uF; C0603
C33: C-USC0603; C0603
C34: 347uF; 150CLZ-0810
C35: CPOL-US150CLZ-0810; 150CLZ-0810
C36, C37, C38, C39: 10uF; C0603
CC, CC1: 0.1uF; C0805
CIN: 10uF; C0805
COUT: 10uF; C0805
CTTC, CTTC1, CTTC3, CTTC5: 0.1uF; C0805
CTTC2, CTTC4: 4.7uF; C0805
D2: GREEN; LED-0603
D3: RED; LED-0603
D4: BAT54; SOT23
D6: MMBZ18VALT1; C4111-15
FET1: DMP2160UW; SUPER-SOT3
IC8: BQ24123; QFN20_3,5X4,5
J1, J2: 90-2
JP1, JP3, JP4, JP5, JP6: JP1E; JP1
JP2: M07; 1X07
L1: 22uH; SM-1206
L2: RCL_L-USL0603; RCL_L0603
L3: 10uH; DR73
L4: SM-1206
L7: 1.5uH; SM-1206
LED1, LED2, LED3: SFH482
LED7: LEDCHIP-LED0603; CHIP-LED0603
MICROPHONE: M03PTH; 1X03
Q1: 14.7456MHz; QS
R1, R7, R9: 10K; R0603
R2: 47R; R0603
R3: 1.43M; R0805
R4: 270R; R0603
R5, R6: 330; 0603-RES
R8: 100R; R0603
R10: 10k; R0805
R11, R12, R13: 1.5k; R0805
R14: 4.22M; R0805
R15, R21, R33: 4.42M; R0805
R16, R23, R27: 0; R0805
R17: 500k; R0805
R18, R19, R20: R-US_R0603; R0603
R22: 5.6M; R0805
R24, R28: 500K; R0805
R25: 4.02M; R0805
R26: 5.90M; R0805
R29: 60C; R0805
R30: 120C; R0805
R31: 10.0M; R0805
R32: 5.60M; R0805
R34, R35, R36, R37, R38, R39, R40, R41: 10K; 0603-RES
RESET: SWITCH-MOMENTARY-2-SMD-1101NE; TACTILE-SWITCH-1101NE
RI1, RI2: 7.5k; R0805
RI3: 1M; R0805
RI4, RI5: 4.7; R0805
RI6: 1K; R0805
RSNS: 0.1; R1206
RT1: 9.31k; R0805
RT2: 442k; R0805
RTHERMAL: R-US_R0805; R0805
S1, S2, S3, S4, S5, S6, S7, S8: TAC_SWITCHSMD; TACTILE_SWITCH_SMD
ST-LINK1: FE05-1
SV1: GPS Header; FE05-1
SV2: Laser Header; FE05-1
SV3: Camra; FE09-2
TPS61028, TPS63031: DIL10
U1: BLUETOOTH-RN-52; RN-52
U3: BQ25504_RGT_16; RGT16_1P7X1P7
U4: SRC4193_DB_28; DB28
U5: microSD; MICRO-SD-SOCKET-PP
U$1: STM32F746; QFN144
U$2: QFN16
USART3/FTDI: FE06-1; FE06
X4: 90-2
XTAL1: 8MHz; HC49U-V
XTAL3: 32768Hz; CRYSTAL_TC26H_3_REPAIR_SMD_SMALL_PITCH

Connections:
3.3V: BOOT.P$2 (2), C6.1, C7.1, C8.1, C9.1, C10.1, C11.1, C12.1, C17.2, C27.2, C28.2, C29.2, C30.1, D4.1 (A), FET1.2 (S), JP5.2, L2.1, MICROPHONE.1, R5.2, R6.2, R9.2, RI5.1, S1.4, S2.4, S3.4, S4.4, S5.4, S6.4, S7.4, S8.4, ST-LINK1.1, SV1.5, SV3.17, U1.20 (VDD), U4.31 (VDD_4), U4.32 (TESTEN), U4.34 (VDD_1), U4.42 (VDD_3), U4.47 (SRC_INT), U4.48 (BIT_EN), U4.53 (VDD_2), U$1.17 (VDD), U$1.30 (VDD), U$1.39 (VDD), U$1.52 (VDD), U$1.62 (VDD), U$1.72 (VDD), U$1.84 (VDD), U$1.108 (VDD), U$1.121 (VDD), U$1.131 (VDD), U$1.144 (VDD), U$2.15 (HIDRV_15)
+5V: BOOTLOAD.3, JP6.2, SV2.1, USART3/FTDI.3
AIC0: U1.3 (AIC0)
BOOT0: BOOT.P$1 (1), FET1.3 (D), R1.2, U$1.138 (BOOT0)
CD2: JP2.7, U5.CD2
CS1: JP2.1, U5.2 (CS)
GND: BOOTLOAD.1, C1.2, C2.2, C3.2, C4.2, C5.2, C6.2, C7.2, C8.2, C9.2, C10.2, C11.2, C12.2, C13.2, C14.2, C15.2, C16.2, C17.1, C18.2, C19.2, C20.2, C21.2, C23.2, C24.2, C25.2, C26.2, C27.1, C27_1812.2, C28.1, C29.1, C30.2, C31.2, C32.2, C33.2, C34.-, C35.-, C36.2, C37.2, C38.2, C39.2, CC.2, CC1.2, CIN.2, COUT.2, CTTC.2, CTTC1.2, CTTC2.2, CTTC3.2, CTTC4.2, CTTC5.2, D6.A, IC8.10 (VSS), IC8.16 (!CE), IC8.17 (PGND), IC8.18 (PGND), J1.1, J2.1, MICROPHONE.2, R1.1, R4.1, R7.1, R16.1, R17.1, R20.1, R23.1, R24.1, R27.1, R28.1, R29.1, R31.1, R34.2, R35.2, R36.2, R37.2, R38.1, R39.1, R40.1, R41.1, RESET.P$1 (1), RI1.2, RI2.2, RI4.2, RT2.1, RTHERMAL.2, ST-LINK1.3, SV1.1, SV1.2, SV2.2, SV3.18, TPS61028.5, TPS61028.8, TPS61028.10, TPS63031.3, TPS63031.9, U1.36 (AGND), U1.G1 (GND9), U1.G2 (GND8), U1.G3 (GND7), U1.G4 (GND6), U1.RFG1 (GND), U1.RFG2 (GND1), U1.RFG3 (GND2), U1.RFG4 (GND3), U1.RFG5 (GND4), U1.RFG6 (GND5), U3.1 (VSS_2), U3.12 (AVSS), U3.13 (VSS), U3.17 (EPAD), U4.27 (VSS_5), U4.29 (SCANEN), U4.33 (VSS_1), U4.36 (VSS_4), U4.41 (VSS_3), U4.54 (VSS_2), U$1.16 (VSS), U$1.31 (VSSA), U$1.38 (VSS), U$1.51 (VSS), U$1.61 (VSS), U$1.83 (VSS), U$1.94 (VSS), U$1.107 (VSS), U$1.120 (VSS), U$1.130 (VSS), U$2.11 (GND_11), U$2.12 (REGN_12), U$2.13 (LODRV_13), USART3/FTDI.1, X4.2, XTAL3.GND
GND2: JP2.5, U5.6 (GND), U5.GND1 (SHIELD1), U5.GND2 (SHIELD2)
GPIO2: U1.2 (GPIO2)
GPIO3: U1.1 (GPIO3)
GPIO4: U1.4 (GPIO4)
GPIO5: U1.5 (GPIO5)
GPIO6: U1.18 (GPIO6)
GPIO7: U1.17 (GPIO7)
GPIO9: U1.10 (GPIO9)
GPIO10: U1.9 (GPIO10)
GPIO11: U1.8 (GPIO11)
GPIO12: U1.6 (GPIO12)
GPIO13: U1.7 (GPIO13)
LED0: D2.C, U1.30 (LED0)
LED1: D3.C, U1.29 (LED1)
MIC_BIAS: U1.31 (MIC_BIAS)
MIC_L+: U1.32 (MIC_L+)
MIC_L-: U1.34 (MIC_L-)
MIC_R+: U1.33 (MIC_R+)
MIC_R-: U1.35 (MIC_R-)
unnamed: D3.A, R6.1
unnamed: D2.A, R5.1
unnamed: D4.3 (C), R8.2
unnamed: C33.1, C35.+, C36.1, JP4.2, L4.1, R19.1, R20.2, TPS61028.7, TPS63031.5
unnamed: C18.1, Q1.1, RI3.1, U4.35 (XTI)
unnamed: D6.C, IC8.1 (OUT), IC8.20 (OUT), L3.1
unnamed: C23.1, RI6.1, U4.37 (FILT)
unnamed: J2.2, JP1.1
unnamed: C19.1, Q1.2, RI3.2, U4.38 (XTO)
unnamed: CTTC2.1, CTTC3.1, J1.2, L1.1, R33.2, U3.2 (VIN_DC)
unnamed: C25.1, RI6.2
unnamed: CC.1, COUT.1, IC8.15 (SNS), L3.2, RSNS.1
unnamed: C22.2, RI4.1, U4.39 (PVDD)
unnamed: C22.1, RI5.2, U4.40 (PVSS)
unnamed: C27_1812.1, JP3.1, U3.14 (VBAT)
unnamed: CTTC4.1, CTTC5.1, R30.2, U3.15 (VSTOR)
unnamed: IC8.14 (BAT), JP3.2, JP4.1, RSNS.2, X4.1
unnamed: IC8.8 (ISET1), RI1.1
unnamed: R14.2, R15.1, U3.10 (OK_PROG)
unnamed: R3.2, R14.1, U3.9 (OK_HYST)
unnamed: IC8.9 (ISET2), RI2.1
unnamed: IC8.12 (TS), RT1.1, RT2.2, RTHERMAL.1
unnamed: CC1.1, IC8.11 (VTSB), RT1.2
unnamed: LED3.A, R13.1
unnamed: LED2.A, R12.1
unnamed: LED1.A, R11.1
unnamed: IC8.2 (STAT1), LED1.K (C)
unnamed: IC8.19 (STAT2), LED2.K (C)
unnamed: IC8.5 (!PG), LED3.K (C)
unnamed: CTTC.1, IC8.7 (TTC)
unnamed: IC8.13 (CELLS), R10.1
unnamed: R15.2, R16.2, R17.2
unnamed: R3.1, R21.2, R25.2, U3.7 (VRDIV)
unnamed: R21.1, R22.2, U3.8 (VBAT_UV)
unnamed: R22.1, R23.2, R24.2
unnamed: C38.1, C39.1, JP5.1, TPS63031.1, TPS63031.10
unnamed: C26.1, CIN.1, IC8.3 (IN1), IC8.4 (IN2), IC8.6 (VCC), JP1.2, R10.2, R11.2, R12.2, R13.2
unnamed: C31.1, U$2.8 (VFB_8)
unnamed: L1.2, U3.16 (LBST)
unnamed: R25.1, R26.2, U3.6 (VBAT_OV)
unnamed: R26.1, R27.2, R28.2
unnamed: CTTC1.1, U3.4 (VREF_SAMP)
unnamed: C32.1, C34.+, JP6.1, R18.2, TPS61028.2
unnamed: R18.1, TPS61028.4
unnamed: R19.2, TPS61028.1, TPS61028.6
unnamed: R29.2, R30.1, U3.5 (OT_PROG)
unnamed: L4.2, TPS61028.9
unnamed: L7.2, TPS63031.2
unnamed: L7.1, TPS63031.4
unnamed: C37.1, TPS63031.6, TPS63031.7, TPS63031.8
unnamed: R31.2, R32.1
unnamed: R32.2, R33.1, U3.3 (VOC_SAMP)
unnamed: LED7.C, R4.2
NRST: C24.1, R9.1, RESET.P$2 (2), ST-LINK1.5, U$1.25 (NRST)
PA0: SV2.3, U$1.34 (PA0)
PA1: SV2.4, U$1.35 (PA1)
PA2: MICROPHONE.3, U$1.36 (PA2)
PA3: U$1.37 (PA3)
PA4: SV3.14, U$1.40 (PA4)
PA5: U$1.41 (PA5), U$2.3 (STAT1_3)
PA6: SV3.11, U$1.42 (PA6)
PA7: U$1.43 (PA7), U$2.5 (STAT2_5)
PA8: SV3.12, U$1.100 (PA8)
PA9: BOOTLOAD.5, U$1.101 (PA9)
PA10: BOOTLOAD.4, SV3.3, U$1.102 (PA10)
PA11: U$1.103 (PA11)
PA12: U$1.104 (PA12)
PA13: ST-LINK1.4, U$1.105 (PA13)
PA14: ST-LINK1.2, U$1.109 (PA14)
PA15: U$1.110 (PA15), U$2.2 (MPPSET_2)
PB0: U$1.46 (PB0)
PB1: U$1.47 (PB1)
PB2: R7.2, U$1.48 (PB2)
PB3: U$1.133 (PB3)
PB4: U$1.134 (PB4), U$2.6 (VREF_6)
PB5: U$1.135 (PB5)
PB6: U$1.136 (PB6)
PB7: U$1.137 (PB7)
PB8: SV3.15, U$1.139 (PB8)
PB9: SV3.16, U$1.140 (PB9)
PB10: U4.43 (SCL), U$1.69 (PB10)
PB11: U4.44 (SDA), U$1.70 (PB11)
PB12: U4.28 (OUT_CLK/DATA_REQ), U$1.73 (PB12)
PB13: U4.45 (SCKR), U$1.74 (PB13)
PB14: U4.30 (RESET), U$1.75 (PB14)
PB15: U$1.76 (PB15)
PC0: U$1.26 (PC0)
PC1: U4.46 (SDI), U$1.27 (PC1)
PC2: U$1.28 (PC2)
PC3: U$1.29 (PC3)
PC4: U$1.44 (PC4), U$2.1 (VCC_1)
PC5: U$1.45 (PC5), U$2.7 (TERMEN_7)
PC6: SV3.4, U$1.96 (PC6)
PC7: U$1.97 (PC7)
PC8: JP2.6, U5.7 (DO), U$1.98 (PC8)
PC9: U$1.99 (PC9)
PC10: U$1.111 (PC10)
PC11: U$1.112 (PC11)
PC12: JP2.3, U5.4 (VCC), U$1.113 (PC12)
PC13: LED7.A, SV3.1, U$1.7 (PC13)
PC14: C3.1, U$1.8 (PC14), XTAL3.1
PC15: C2.1, U$1.9 (PC15), XTAL3.2
PCM_CLK: U1.24 (PCM_CLK), U4.49 (SCKT)
PCM_IN: U1.21 (PCM_IN), U4.50 (SDO)
PCM_SYNC: U1.23 (PCM_SYNC), U4.52 (LRCKT)
PD0: U$1.114 (PD0)
PD1: FET1.1 (G), U$1.115 (PD1)
PD2: JP2.2, U5.3 (DI), U$1.116 (PD2)
PD3: SV3.7, U$1.117 (PD3)
PD4: U$1.118 (PD4)
PD5: U$1.119 (PD5)
PD6: R35.1, S2.2, U$1.122 (PD6)
PD7: R36.1, S3.2, U$1.123 (PD7)
PD8: U$1.77 (PD8), USART3/FTDI.5
PD9: U$1.78 (PD9), USART3/FTDI.4
PD10: U$1.79 (PD10)
PD11: R39.2, S6.2, U$1.80 (PD11)
PD12: R40.2, S7.2, U$1.81 (PD12)
PD13: U$1.82 (PD13)
PD14: U$1.85 (PD14)
PD15: U$1.86 (PD15)
PDR_ON: U$1.143 (PDR_ON)
PE0: U$1.141 (PE0\)
PE1: U$1.142 (PE1)
PE2: U$1.1 (PE2)
PE3: SV3.2, U$1.2 (PE3)
PE4: SV3.8, U$1.3 (PE4)
PE5: SV3.10, U$1.4 (PE5)
PE6: SV3.9, U$1.5 (PE6)
PE7: U$1.58 (PE7)
PE8: U$1.59 (PE8)
PE9: U$1.60 (PE9)
PE10: U$1.63 (PE10)
PE11: U$1.64 (PE11)
PE12: U$1.65 (PE12)
PE13: U$1.66 (PE13)
PE14: U$1.67 (PE14)
PE15: U$1.68 (PE15)
PF0: U$1.10 (PF0)
PF1: U$1.11 (PF1)
PF2: U$1.12 (PF2)
PF3: U$1.13 (PF3)
PF4: U$1.14 (PF4)
PF5: U$1.15 (PF5)
PF6: SV1.3, U$1.18 (PF6)
PF7: SV1.4, U$1.19 (PF7)
PF8: U$1.20 (PF8)
PF9: U$1.21 (PF9)
PF10: R41.2, S8.2, U$1.22 (PF10)
PF11: U$1.49 (PF11)
PF12: U$1.50 (PF12)
PF13: U$1.53 (PF13)
PF14: U$1.54 (PF14)
PF15: U$1.55 (PF15)
PG0: U$1.56 (PG0)
PG1: U$1.57 (PG1)
PG2: R37.1, S4.2, U$1.87 (PG2)
PG3: R38.2, S5.2, U$1.88 (PG3)
PG4: U$1.89 (PG4)
PG5: U$1.90 (PG5)
PG6: U$1.91 (PG6)
PG7: R34.1, S1.2, U$1.92 (PG7)
PG8: U$1.93 (PG8)
PG9: SV3.13, U$1.124 (PG9)
PG10: SV3.6, U$1.125 (PG10)
PG11: SV3.5, U$1.126 (PG11)
PG12: U$1.127 (PG12)
PG13: U$1.128 (PG13)
PG14: U$1.129 (PG14)
PG15: U$1.132 (PG15)
PH0: C21.1, U$1.23 (PH0), XTAL1.2
PH1: C20.1, U$1.24 (PH1), XTAL1.1
PWREN: U1.19 (PWREN)
SCK1: JP2.4, U5.5 (SCK)
SPI_CLK: U1.27 (SPI_CLK)
SPI_MISO: U1.26 (SPI_MISO)
SPI_MOSI: U1.28 (SPI_MOSI)
SPI_SS: U1.25 (SPI_SS)
SPKR_L+: U1.40 (SPKR_L+)
SPKR_L-: U1.38 (SPKR_L-)
SPKR_R+: U1.39 (SPKR_R+)
SPKR_R-: U1.37 (SPKR_R-)
UART_CTS: U1.14 (UART_CTS)
UART_RTS: U1.13 (UART_RTS)
UART_RX: U1.16 (UART_RX)
UART_TX: U1.15 (UART_TX)
USBD+: U1.12 (USBD+)
USBD-: U1.11 (USBD-)
VBAT: C1.1, R8.1, U$1.6 (VBAT)
VCAP_1: C4.1, U$1.71 (VCAP_1)
VCAP_2: C5.1, U$1.106 (VCAP_2)
VDDA: C13.1, C14.1, L2.2, R2.2, U$1.33 (VDDA)
VDDUSB: U$1.95 (VDDUSB)
VREF: C15.1, C16.1, R2.1, U$1.32 (VREF+)

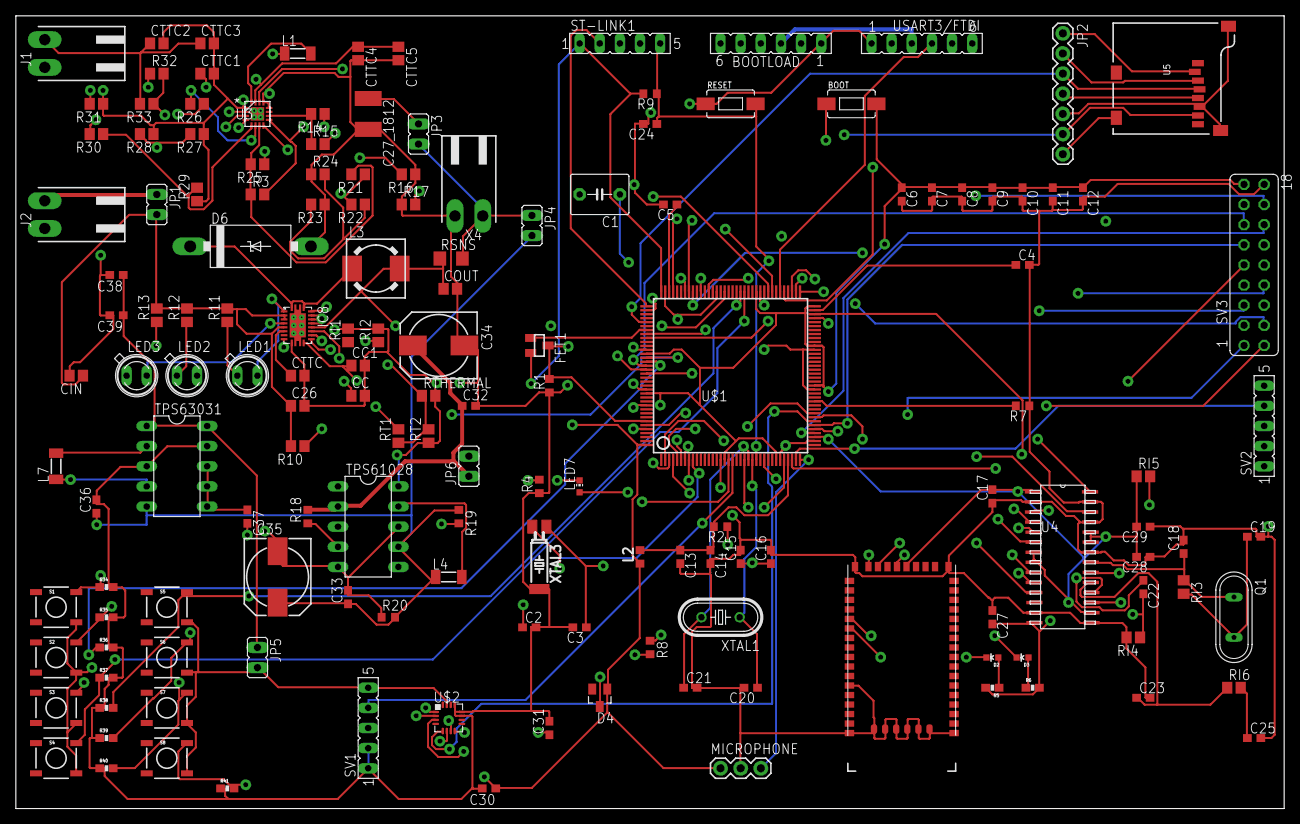
[picture p157: board Schematic/Sensewalk2/Ross/rossrev4/offical board.brd from above]

Board: 4 copper layers, 160.0 x 100.0 mm, 153 parts (0 on the bottom side), 127 nets.
