trougnouf/SeniorDesign/Schematic/Sensewalk2/Ross/eagal/Power Board/NCP1200.brd

## EAGLE design Schematic/Sensewalk2/Ross/eagal/Power Board/NCP1200.brd (2016-02-07)

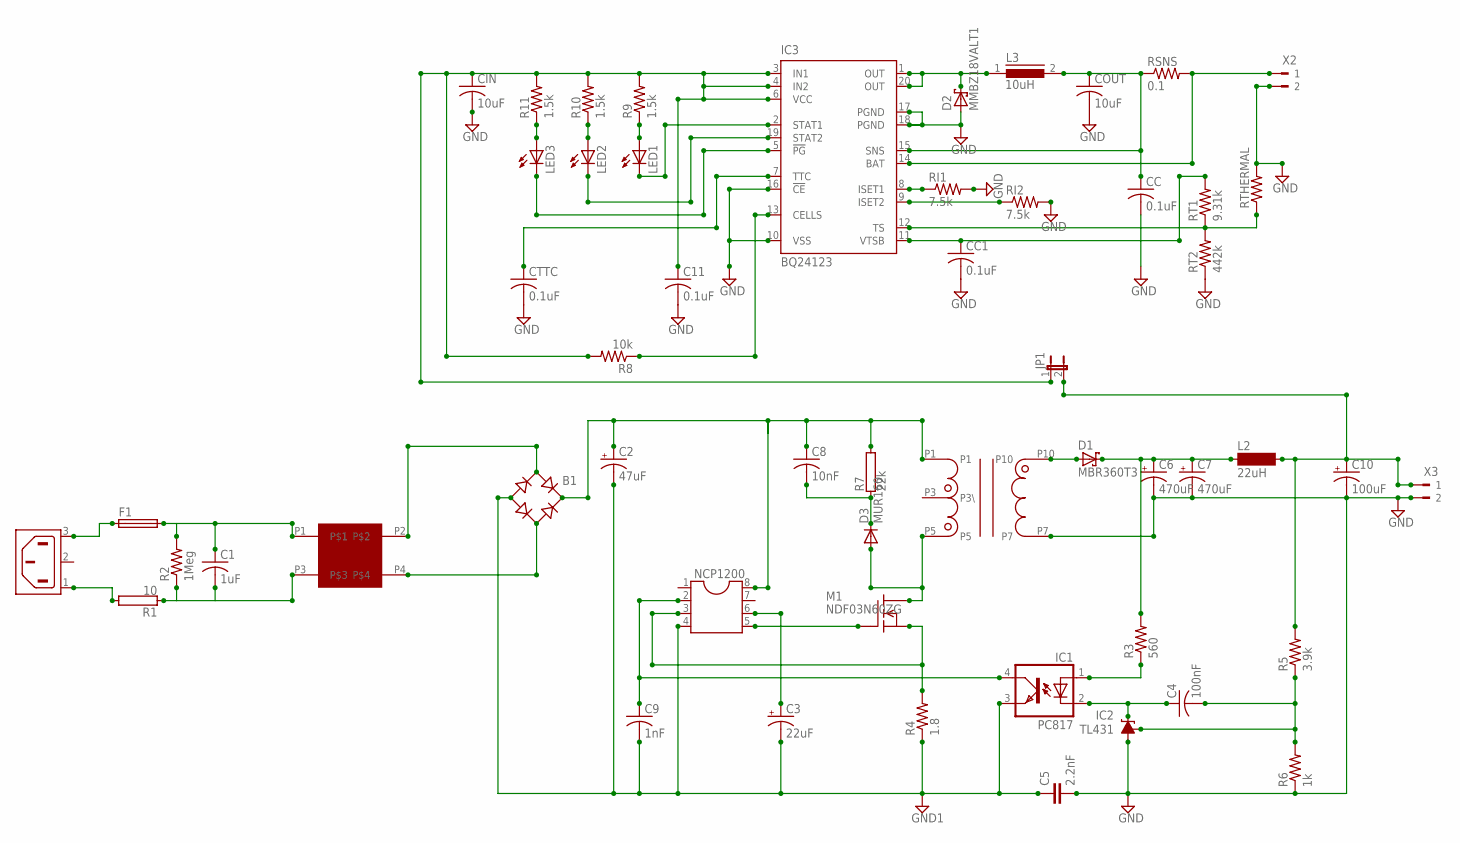
[picture p160: schematic NCP1200.sch]

Parts:
B1: B-DIL
C1: 1uF; C150-091X182
C2: 47uF; EB22,5D
C3: 22uF; E5-5
C4: 100nF; C0805
C5: 2.2nF; YC10B4
C6, C7: 470uF; E5-10,5
C8: 10nF; C102-064X133
C9: 1nF; C0805
C10: 100uF; E2,5-6
C11: 0.1uF; C0805
CC, CC1: 0.1uF; C0805
CIN: 10uF; C0805
COUT: 10uF; C0805
CTTC: 0.1uF; C0805
D1: MBR360T3; SMB
D2: MMBZ18VALT1; C4111-15
D3: MUR160; SGA-10
F1: SH25
IC1: PC817; DIL04
IC2: TL431; LP_O-PBCY-W3
IC3: BQ24123; QFN20_3,5X4,5
JP1: JP1E; JP1
L2: 22uH; SD8
L3: 10uH; DR73
LED1, LED2, LED3: SFH482
M1: NDF03N60ZG; TO220
NCP1200: DIL8; DIL08
R1: 10; KH206-8
R2: 1Meg; R0805
R3: 560; R0805
R4: 1.8; R1206
R5: 3.9k; R0805
R6: 1k; R0805
R7: 22k; KH206-8
R8: 10k; R0805
R9, R10, R11: 1.5k; R0805
RI1, RI2: 7.5k; R0805
RSNS: 0.1; R1206
RT1: 9.31k; R0805
RT2: 442k; R0805
RTHERMAL: R-US_R0805; R0805
U$1: RENCO1
U$2: L1CHO5; L1CHO
X1: 6ESRM-P
X2, X3: 90-2

Connections:
GND: C5.2, C6.-, C7.-, C10.-, C11.2, CC.2, CC1.2, CIN.2, COUT.2, CTTC.2, D2.A, IC2.3 (A), IC3.10 (VSS), IC3.16 (!CE), IC3.17 (PGND), IC3.18 (PGND), R6.1, RI1.2, RI2.2, RT2.1, RTHERMAL.2, U$1.P7, X2.2, X3.2
unnamed: D2.C, IC3.1 (OUT), IC3.20 (OUT), L3.1
unnamed: C1.2, R1.1, R2.1, U$2.P3
unnamed: CC.1, COUT.1, IC3.15 (SNS), L3.2, RSNS.1
unnamed: B1.AC1, U$2.P2
unnamed: B1.AC2, U$2.P4
unnamed: IC3.8 (ISET1), RI1.1
unnamed: B1.+, C2.+, C8.1, NCP1200.8, R7.2, U$1.P1
unnamed: C9.1, IC1.4 (COL), NCP1200.2
unnamed: M1.1 (G), NCP1200.5
unnamed: M1.3 (S), NCP1200.3, R4.2
unnamed: C3.+, NCP1200.6
unnamed: C11.1, CIN.1, IC3.3 (IN1), IC3.4 (IN2), IC3.6 (VCC), JP1.1, R8.2, R9.2, R10.2, R11.2
unnamed: D1.A, U$1.P10
unnamed: C8.2, D3.C, R7.1
unnamed: D3.A, M1.2 (D), U$1.P5
unnamed: C6.+, C7.+, D1.C, L2.1, R3.2
unnamed: IC1.1 (A), R3.1
unnamed: IC3.9 (ISET2), RI2.1
unnamed: C4.2, IC2.1 (FB), R5.1, R6.2
unnamed: C4.1, IC1.2 (C), IC2.2 (C)
unnamed: IC3.12 (TS), RT1.1, RT2.2, RTHERMAL.1
unnamed: CC1.1, IC3.11 (VTSB), RT1.2
unnamed: LED3.A, R11.1
unnamed: LED2.A, R10.1
unnamed: LED1.A, R9.1
unnamed: IC3.2 (STAT1), LED1.K (C)
unnamed: IC3.19 (STAT2), LED2.K (C)
unnamed: IC3.5 (!PG), LED3.K (C)
unnamed: CTTC.1, IC3.7 (TTC)
unnamed: IC3.13 (CELLS), R8.1
unnamed: C1.1, F1.2, R2.2, U$2.P1
unnamed: R1.2, X1.1 (AC1)
unnamed: IC3.14 (BAT), RSNS.2, X2.1
unnamed: F1.1, X1.3 (AC2)
unnamed: C10.+, JP1.2, L2.2, R5.2, X3.1
PE: B1.-, C2.-, C3.-, C5.1, C9.2, IC1.3 (EMIT), NCP1200.4, R4.1

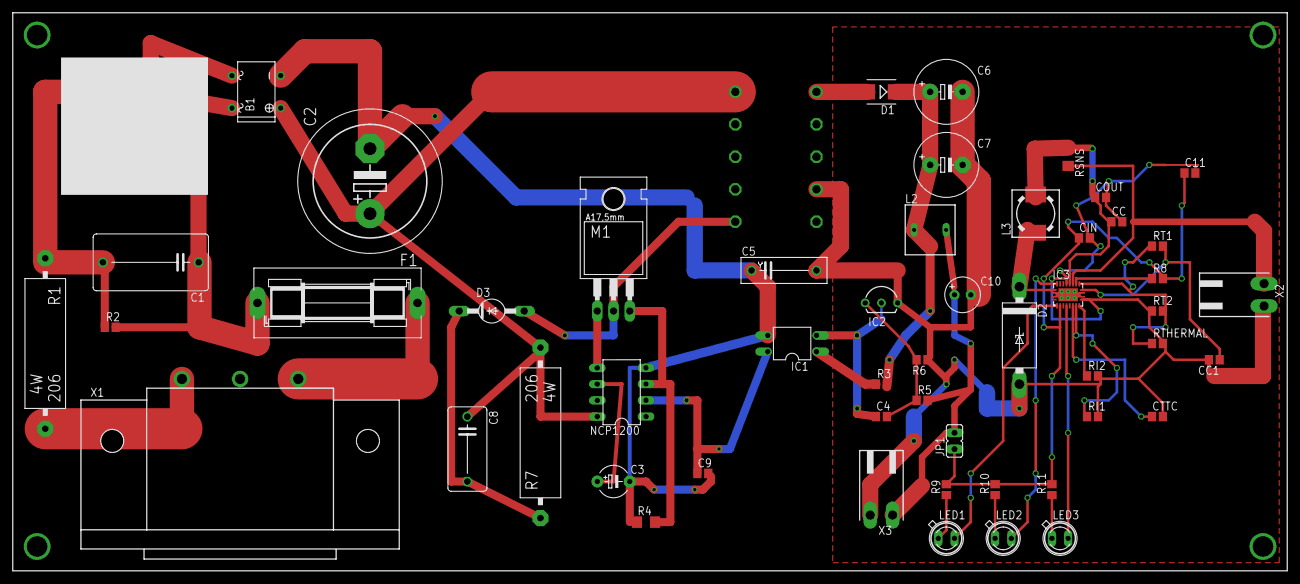
[picture p161: board NCP1200.brd from above]

Board: 2 copper layers, 199.4 x 87.3 mm, 54 parts (1 on the bottom side), 37 nets.
