trougnouf/SeniorDesign/Code/Benoit/CompassLaser/Src/main.c

/**
  ******************************************************************************
  * File Name          : main.c
  * Description        : Main program body
  ******************************************************************************
  *
  * COPYRIGHT(c) 2016 STMicroelectronics
  *
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
  ******************************************************************************
  */
/* Includes ------------------------------------------------------------------*/
#include "stm32f0xx_hal.h"
#include "cmsis_os.h"

/* USER CODE BEGIN Includes */
#include <stdlib.h>
#include <math.h>

#define COMP_CS GPIO_PIN_4
#define COMP_CS_P GPIOA
#define COMP_INT GPIO_PIN_1
#define COMP_INT_P GPIOA
#define COMP_RR	1

#define LED00	GPIO_PIN_5
#define LED00P	GPIOB
#define LED01	GPIO_PIN_4
#define LED01P	GPIOB
#define LED10	GPIO_PIN_10
#define LED10P	GPIOB
#define LED11	GPIO_PIN_8
#define LED11P	GPIOA
#define LED20	GPIO_PIN_7
#define LED20P	GPIOC
#define LED21	GPIO_PIN_6
#define LED21P	GPIOB

/* USER CODE END Includes */

SPI_HandleTypeDef hspi1;

UART_HandleTypeDef huart1;
UART_HandleTypeDef huart2;

osThreadId defaultTaskHandle;
osThreadId compassTaskHandle;
osThreadId laserTaskHandle;

/* USER CODE BEGIN PV */

/* USER CODE END PV */

void SystemClock_Config(void);
static void MX_GPIO_Init(void);
static void MX_USART2_UART_Init(void);
static void MX_SPI1_Init(void);
static void MX_USART1_UART_Init(void);
void StartDefaultTask(void const * argument);
void StartCompassTask(void const * argument);
void StartLaserTask(void const * argument);

/* USER CODE BEGIN PFP */

/* USER CODE END PFP */

/* USER CODE BEGIN 0 */
// Useful debugging info
void dbg_uartout(uint8_t * inBuf, uint8_t * outBuf, uint8_t * msg)
{
	if(outBuf[0] == 62)	// SSMM
	{
		msg = "SMM:\t";
		HAL_UART_Transmit(&huart2, (uint8_t*)msg, strlen(msg), 0xFFFF);
	}
	else if(outBuf[0] == 78)	// RM
	{
		msg = "RM:\t";
		HAL_UART_Transmit(&huart2, (uint8_t*)msg, strlen(msg), 0xFFFF);
	}
	else if(outBuf[0] == 240)	// RST
	{
		msg = "RST:\t";
		HAL_UART_Transmit(&huart2, (uint8_t*)msg, strlen(msg), 0xFFFF);
	}
	else if(outBuf[0] == 80)	// RR
	{
		msg = "RR:\t";
		HAL_UART_Transmit(&huart2, (uint8_t*)msg, strlen(msg), 0xFFFF);
	}
	if(inBuf[0] & 128)	msg = "BM\t";
	else				msg = "  \t";
	HAL_UART_Transmit(&huart2, (uint8_t*)msg, strlen(msg), 0xFFFF);
	if(inBuf[0] & 64)	msg = "WC\t";
	else				msg = "  \t";
	HAL_UART_Transmit(&huart2, (uint8_t*)msg, strlen(msg), 0xFFFF);
	if(inBuf[0] & 32)	msg = "SM\t";
	else				msg = "  \t";
	HAL_UART_Transmit(&huart2, (uint8_t*)msg, strlen(msg), 0xFFFF);
	if(inBuf[0] & 16)	msg = "ER\t";
	else				msg = "  \t";
	HAL_UART_Transmit(&huart2, (uint8_t*)msg, strlen(msg), 0xFFFF);
	if(inBuf[0] & 8)	msg = "SD\t";
	else				msg = "  \t";
	HAL_UART_Transmit(&huart2, (uint8_t*)msg, strlen(msg), 0xFFFF);
	if(inBuf[0] & 4)	msg = "RS\t";
	else				msg = "  \t";
	HAL_UART_Transmit(&huart2, (uint8_t*)msg, strlen(msg), 0xFFFF);
	if(inBuf[0] & 2)	msg = "D1\t";
	else				msg = "  \t";
	HAL_UART_Transmit(&huart2, (uint8_t*)msg, strlen(msg), 0xFFFF);
	if(inBuf[0] & 1)	msg = "D0\t";
	else				msg = "  \t";
	HAL_UART_Transmit(&huart2, (uint8_t*)msg, strlen(msg), 0xFFFF);
	if(HAL_GPIO_ReadPin(COMP_INT_P, COMP_INT))
	{
		msg = "RDY\t";
		HAL_UART_Transmit(&huart2, (uint8_t*)msg, strlen(msg), 0xFFFF);
	}
	msg = "\n\n\r";
	HAL_UART_Transmit(&huart2, (uint8_t*)msg, strlen(msg), 0xFFFF);
}

// I/O
void send_SPI(uint8_t * inBuf, uint8_t inLength, uint8_t * outBuf, uint8_t outLength)
{
	HAL_GPIO_WritePin(COMP_CS_P, COMP_CS, GPIO_PIN_RESET);
	HAL_SPI_Transmit(&hspi1, outBuf, outLength, 1000);
	HAL_SPI_Receive(&hspi1, inBuf, inLength, 1000);
	HAL_GPIO_WritePin(COMP_CS_P, COMP_CS, GPIO_PIN_SET);
}

// Print results as integers
void compass_uart(int16_t * xyz, uint8_t * msg, int16_t * angle)
{
	sprintf(msg, "x: %5d\t", xyz[0]);
	HAL_UART_Transmit(&huart2, (uint8_t*)msg, strlen(msg), 0xFFFF);
	sprintf(msg, "y: %5d\t", xyz[1]);
	HAL_UART_Transmit(&huart2, (uint8_t*)msg, strlen(msg), 0xFFFF);
	sprintf(msg, "z: %5d\t", xyz[2]);
	HAL_UART_Transmit(&huart2, (uint8_t*)msg, strlen(msg), 0xFFFF);
	sprintf(msg, "a: %d\t", *angle);
	HAL_UART_Transmit(&huart2, (uint8_t*)msg, strlen(msg), 0xFFFF);
	msg = "\n\r";
	HAL_UART_Transmit(&huart2, (uint8_t*)msg, strlen(msg), 0xFFFF);
}

// Convert raw input bits to integers
void processInput(uint8_t * inbuf, int16_t * xyz, int16_t * minmaxxyz)
{
	// FL is off by 2 degrees W: Don't care.
	for(uint8_t i=0; i<3; i++)
	{
		// 2's complement binaries to int16_t
		xyz[i] = ((int16_t)inbuf[i*2+1] << 8 | inbuf[i*2+2]);
		// (optional) use GAIN_SEL to find "real" value
		xyz[i] *= i==2?.294:.161;
		// Update minmaxxyz
		if(xyz[i] < minmaxxyz[2*i])	minmaxxyz[2*i] = xyz[i];
		if(xyz[i] > minmaxxyz[2*i+1])	minmaxxyz[2*i+1] = xyz[i];
		// Normalize results
		xyz[i] -= (minmaxxyz[2*i+1]+minmaxxyz[2*i])/2;
	}
}

/*
 * Calibration: Do a bunch of measurements
 *
 * Measurements/normalization: Save min and max. Med = 0
 */

void calibrate(uint8_t * inbuf, uint8_t * outbuf, int16_t * xyz, int16_t * minmaxxyz)
{
	takemeasurement(inbuf, outbuf);
	for(uint8_t i=0; i<3; i++)
	{
		// 2's complement binaries to int16_t
		xyz[i] = ((int16_t)inbuf[i*2+1] << 8 | inbuf[i*2+2]);
		// (optional) use GAIN_SEL to find "real" value
		xyz[i] *= i==2?.294:.161;
		// Update minmaxxyz
		minmaxxyz[2*i] = xyz[i];
		minmaxxyz[2*1+1] = xyz[i];
	}
	for(uint16_t i=0; i<100; i++)	// TODO replace this with pushbutton
	{
		takemeasurement(inbuf, outbuf);
		processInput(inbuf, xyz, minmaxxyz);
		osDelay(100);
	}
}

void takemeasurement(uint8_t * inbuf, uint8_t * outbuf)
{
	  // Start single measurement mode
	  outbuf[0] = 62;	// 0011zyxt
	  send_SPI(inbuf, 1, outbuf, 1);
	  //dbg_uartout(inbuf, outbuf, msg);

	  while(!HAL_GPIO_ReadPin(COMP_INT_P, COMP_INT));

	  //Read measurement
	  outbuf[0] = 78;
	  send_SPI(inbuf, 7, outbuf, 1);
	  //dbg_uartout(inbuf, outbuf, msg);
}

void getAngle(int16_t * angle, int16_t * xyz)
{
	volatile double tmp = atan((double)xyz[0]/(double)xyz[1]);
	tmp *= (180/3.1428);
	tmp = 90 - tmp;
	if(xyz[1] > 0)	*angle = (int16_t)(90.0 - (atan((double)xyz[0]/(double)xyz[1]) * (180.0 / 3.1428)));
	else if(xyz[1] < 0)	*angle = (int16_t)(270.0 - (atan((double)xyz[0]/(double)xyz[1]) * (180.0 / 3.1428)));
	else if(xyz[0]<0)	*angle = 180;
	else	*angle = 0;
}

static void strToUART(char * msg)
{
	HAL_UART_Transmit(&huart2, (uint8_t*)msg, strlen(msg), 0xFFFF);
}

static void laserOut_1ft()
{
	HAL_GPIO_WritePin(LED00P, LED00, GPIO_PIN_SET);	//A4
	HAL_GPIO_WritePin(LED10P, LED10, GPIO_PIN_RESET);	//A2
	HAL_GPIO_WritePin(LED20P, LED20, GPIO_PIN_RESET);	//A0
}
static void	laserOut_2ft()
{
	HAL_GPIO_WritePin(LED00P, LED00, GPIO_PIN_SET);	//A4
	HAL_GPIO_WritePin(LED10P, LED10, GPIO_PIN_SET);	//A2
	HAL_GPIO_WritePin(LED20P, LED20, GPIO_PIN_RESET);	//A0
}
static void	laserOut_3ft()
{
	HAL_GPIO_WritePin(LED00P, LED00, GPIO_PIN_SET);	//A4
	HAL_GPIO_WritePin(LED10P, LED10, GPIO_PIN_SET);	//A2
	HAL_GPIO_WritePin(LED20P, LED20, GPIO_PIN_SET);	//A0
}
static void laserOut_safe()
{
	HAL_GPIO_WritePin(LED00P, LED00, GPIO_PIN_RESET);	//A4
	HAL_GPIO_WritePin(LED10P, LED10, GPIO_PIN_RESET);	//A2
	HAL_GPIO_WritePin(LED20P, LED20, GPIO_PIN_RESET);	//A0
}

/* USER CODE END 0 */

int main(void)
{

  /* MCU Configuration----------------------------------------------------------*/

  /* Reset of all peripherals, Initializes the Flash interface and the Systick. */
  HAL_Init();

  /* Configure the system clock */
  SystemClock_Config();

  /* Initialize all configured peripherals */
  MX_GPIO_Init();
  MX_USART2_UART_Init();
  MX_SPI1_Init();
  MX_USART1_UART_Init();

  /* USER CODE BEGIN RTOS_MUTEX */
  /* add mutexes, ... */
  /* USER CODE END RTOS_MUTEX */

  /* USER CODE BEGIN RTOS_SEMAPHORES */
  /* add semaphores, ... */
  /* USER CODE END RTOS_SEMAPHORES */

  /* USER CODE BEGIN RTOS_TIMERS */
  /* start timers, add new ones, ... */
  /* USER CODE END RTOS_TIMERS */

  /* Create the thread(s) */
  /* definition and creation of defaultTask */
  osThreadDef(defaultTask, StartDefaultTask, osPriorityNormal, 0, 128);
  defaultTaskHandle = osThreadCreate(osThread(defaultTask), NULL);
  osThreadDef(compassTask, StartCompassTask, osPriorityNormal, 0, 128);
  compassTaskHandle = osThreadCreate(osThread(compassTask), NULL);
  osThreadDef(laserTask, StartLaserTask, osPriorityNormal, 0, 128);
  laserTaskHandle = osThreadCreate(osThread(laserTask), NULL);

  /* USER CODE BEGIN RTOS_THREADS */
  /* add threads, ... */
  /* USER CODE END RTOS_THREADS */

  /* USER CODE BEGIN RTOS_QUEUES */
  /* add queues, ... */
  /* USER CODE END RTOS_QUEUES */
 

  /* Start scheduler */
  osKernelStart();
  
  /* We should never get here as control is now taken by the scheduler */

  /* Infinite loop */
  /* USER CODE BEGIN WHILE */
  while (1)
  {
  /* USER CODE END WHILE */

  /* USER CODE BEGIN 3 */

  }
  /* USER CODE END 3 */

}

/** System Clock Configuration
*/
void SystemClock_Config(void)
{

  RCC_OscInitTypeDef RCC_OscInitStruct;
  RCC_ClkInitTypeDef RCC_ClkInitStruct;
  RCC_PeriphCLKInitTypeDef PeriphClkInit;

  RCC_OscInitStruct.OscillatorType = RCC_OSCILLATORTYPE_HSI;
  RCC_OscInitStruct.HSIState = RCC_HSI_ON;
  RCC_OscInitStruct.HSICalibrationValue = 16;
  RCC_OscInitStruct.PLL.PLLState = RCC_PLL_ON;
  RCC_OscInitStruct.PLL.PLLSource = RCC_PLLSOURCE_HSI;
  RCC_OscInitStruct.PLL.PLLMUL = RCC_PLL_MUL6;
  RCC_OscInitStruct.PLL.PREDIV = RCC_PREDIV_DIV1;
  HAL_RCC_OscConfig(&RCC_OscInitStruct);

  RCC_ClkInitStruct.ClockType = RCC_CLOCKTYPE_HCLK|RCC_CLOCKTYPE_SYSCLK
                              |RCC_CLOCKTYPE_PCLK1;
  RCC_ClkInitStruct.SYSCLKSource = RCC_SYSCLKSOURCE_PLLCLK;
  RCC_ClkInitStruct.AHBCLKDivider = RCC_SYSCLK_DIV1;
  RCC_ClkInitStruct.APB1CLKDivider = RCC_HCLK_DIV1;
  HAL_RCC_ClockConfig(&RCC_ClkInitStruct, FLASH_LATENCY_1);

  PeriphClkInit.PeriphClockSelection = RCC_PERIPHCLK_USART1;
  PeriphClkInit.Usart1ClockSelection = RCC_USART1CLKSOURCE_PCLK1;
  HAL_RCCEx_PeriphCLKConfig(&PeriphClkInit);

  HAL_SYSTICK_Config(HAL_RCC_GetHCLKFreq()/1000);

  HAL_SYSTICK_CLKSourceConfig(SYSTICK_CLKSOURCE_HCLK);

  /* SysTick_IRQn interrupt configuration */
  HAL_NVIC_SetPriority(SysTick_IRQn, 3, 0);
}

/* SPI1 init function */
void MX_SPI1_Init(void)
{
	  hspi1.Instance = SPI1;
	  hspi1.Init.Mode = SPI_MODE_MASTER;
	  hspi1.Init.Direction = SPI_DIRECTION_2LINES;
	  hspi1.Init.DataSize = SPI_DATASIZE_8BIT;
	  hspi1.Init.CLKPolarity = SPI_POLARITY_HIGH;
	  hspi1.Init.CLKPhase = SPI_PHASE_2EDGE;
	  hspi1.Init.NSS = SPI_NSS_SOFT;
	  hspi1.Init.BaudRatePrescaler = SPI_BAUDRATEPRESCALER_256;
	  hspi1.Init.FirstBit = SPI_FIRSTBIT_MSB;
	  hspi1.Init.TIMode = SPI_TIMODE_DISABLED;
	  hspi1.Init.CRCCalculation = SPI_CRCCALCULATION_DISABLED;
	  hspi1.Init.CRCPolynomial = 7;
	  hspi1.Init.CRCLength = SPI_CRC_LENGTH_DATASIZE;
	  hspi1.Init.NSSPMode = SPI_NSS_PULSE_DISABLED;
	  HAL_SPI_Init(&hspi1);
}

/* USART1 init function */
void MX_USART1_UART_Init(void)
{

  huart1.Instance = USART1;
  huart1.Init.BaudRate = 19200;
  huart1.Init.WordLength = UART_WORDLENGTH_8B;
  huart1.Init.StopBits = UART_STOPBITS_1;
  huart1.Init.Parity = UART_PARITY_NONE;
  huart1.Init.Mode = UART_MODE_TX_RX;
  huart1.Init.HwFlowCtl = UART_HWCONTROL_NONE;
  huart1.Init.OverSampling = UART_OVERSAMPLING_16;
  huart1.Init.OneBitSampling = UART_ONEBIT_SAMPLING_DISABLED ;
  huart1.AdvancedInit.AdvFeatureInit = UART_ADVFEATURE_NO_INIT;
  HAL_UART_Init(&huart1);

}

/* USART2 init function */
void MX_USART2_UART_Init(void)
{

  huart2.Instance = USART2;
  huart2.Init.BaudRate = 19200;
  huart2.Init.WordLength = UART_WORDLENGTH_8B;
  huart2.Init.StopBits = UART_STOPBITS_1;
  huart2.Init.Parity = UART_PARITY_NONE;
  huart2.Init.Mode = UART_MODE_TX_RX;
  huart2.Init.HwFlowCtl = UART_HWCONTROL_NONE;
  huart2.Init.OverSampling = UART_OVERSAMPLING_16;
  huart2.Init.OneBitSampling = UART_ONEBIT_SAMPLING_DISABLED ;
  huart2.AdvancedInit.AdvFeatureInit = UART_ADVFEATURE_NO_INIT;
  HAL_UART_Init(&huart2);

}

/** Configure pins as 
        * Analog 
        * Input 
        * Output
        * EVENT_OUT
        * EXTI
*/
void MX_GPIO_Init(void)
{

  GPIO_InitTypeDef GPIO_InitStruct;

  /* GPIO Ports Clock Enable */
  __GPIOC_CLK_ENABLE();
  __GPIOA_CLK_ENABLE();
  __GPIOB_CLK_ENABLE();

  /*Configure GPIO pin : B1_Pin */
  GPIO_InitStruct.Pin = B1_Pin;
  GPIO_InitStruct.Mode = GPIO_MODE_EVT_RISING;
  GPIO_InitStruct.Pull = GPIO_NOPULL;
  HAL_GPIO_Init(B1_GPIO_Port, &GPIO_InitStruct);

  /*Configure GPIO pin : INT_Pin */
  GPIO_InitStruct.Pin = INT_Pin;
  GPIO_InitStruct.Mode = GPIO_MODE_INPUT;
  GPIO_InitStruct.Pull = GPIO_NOPULL;
  HAL_GPIO_Init(INT_GPIO_Port, &GPIO_InitStruct);

  /*Configure GPIO pins : PA4 LD2_Pin LED11_Pin */
  GPIO_InitStruct.Pin = GPIO_PIN_4|LD2_Pin|LED11_Pin;
  GPIO_InitStruct.Mode = GPIO_MODE_OUTPUT_PP;
  GPIO_InitStruct.Pull = GPIO_NOPULL;
  GPIO_InitStruct.Speed = GPIO_SPEED_LOW;
  HAL_GPIO_Init(GPIOA, &GPIO_InitStruct);

  /*Configure GPIO pins : LED10_Pin LED01_Pin LED00_Pin LED21_Pin */
  GPIO_InitStruct.Pin = LED10_Pin|LED01_Pin|LED00_Pin|LED21_Pin;
  GPIO_InitStruct.Mode = GPIO_MODE_OUTPUT_PP;
  GPIO_InitStruct.Pull = GPIO_NOPULL;
  GPIO_InitStruct.Speed = GPIO_SPEED_LOW;
  HAL_GPIO_Init(GPIOB, &GPIO_InitStruct);

  /*Configure GPIO pins : LED20_Pin TRIG_Pin */
  GPIO_InitStruct.Pin = LED20_Pin|TRIG_Pin;
  GPIO_InitStruct.Mode = GPIO_MODE_OUTPUT_PP;
  GPIO_InitStruct.Pull = GPIO_NOPULL;
  GPIO_InitStruct.Speed = GPIO_SPEED_LOW;
  HAL_GPIO_Init(GPIOC, &GPIO_InitStruct);

  /*Configure GPIO pin Output Level */
  HAL_GPIO_WritePin(GPIOA, GPIO_PIN_4|LD2_Pin|LED11_Pin, GPIO_PIN_RESET);

  /*Configure GPIO pin Output Level */
  HAL_GPIO_WritePin(GPIOB, LED10_Pin|LED01_Pin|LED00_Pin|LED21_Pin, GPIO_PIN_RESET);

  /*Configure GPIO pin Output Level */
  HAL_GPIO_WritePin(GPIOC, LED20_Pin|TRIG_Pin, GPIO_PIN_RESET);

}

/* USER CODE BEGIN 4 */
void StartCompassTask(void const * argument)
{

	uint8_t inbuf[7];
	uint8_t outbuf[2];
	int16_t xyz[3];
	int16_t minmaxxyz[6];	// xmin xmax ymin ymax zmin zmax
	int16_t angle;
	uint8_t * msg = malloc(10);

	// Reset: 11110000 = 0xf0
	outbuf[0] = 0xf0;
	send_SPI(inbuf, 1, outbuf, 1);
	dbg_uartout(inbuf, outbuf, msg);

	calibrate(inbuf, outbuf, xyz, minmaxxyz);

	/*
	// Read register 0
	outbuf[0] = 80;
	outbuf[1] = 0 << 2;
	send_SPI(inbuf, 3, outbuf, 2);
	dbg_uartout(inbuf, outbuf, msg);
	*/


  /* Infinite loop */

  for(;;)
  {
	  takemeasurement(inbuf, outbuf);
	  processInput(inbuf, xyz, minmaxxyz);
	  getAngle(&angle, xyz);
	  compass_uart(xyz, msg, &angle);
	  osDelay(100);	// replace w/sleep
  }
#pragma GCC pop_options
}

/* StartDefaultTask function */
void StartLaserTask(void const * argument)
{

	uint8_t in[6];
	in[0] = '0';
	uint8_t * nl = "\n\r";
	uint8_t inSize;
	HAL_StatusTypeDef status;
	double distance = 0; //(debug) was volatile

	// LEDs
	HAL_GPIO_WritePin(LED01P, LED01, GPIO_PIN_RESET);
	HAL_GPIO_WritePin(LED11P, LED11, GPIO_PIN_RESET);
	HAL_GPIO_WritePin(LED21P, LED21, GPIO_PIN_RESET);

  /* Infinite loop */
	for(;;)
	{
		if(HAL_UART_Transmit(&huart1, &in[0], 1, 1000) == HAL_OK)// send request
		{
			// Receive
			for (inSize = 0; inSize < 7; inSize++)	// max = 25.00\n\r
			{
				HAL_UART_Receive(&huart1, &in[inSize], 1, 0xFFFF);
				if(in[inSize] == '\n')	break;
			}
	  	// Send result to PC (opt)
	  	HAL_UART_Transmit(&huart2, (uint8_t *)in, inSize-1, 0x1000);
	  	strToUART(nl);	// makes debugging prettier

	  	distance = atof(in);
		}
		// Process result
		if(distance < 0.3048)			laserOut_1ft();
		else if(distance < 0.6096)	laserOut_2ft();
		else if(distance < 0.9144)	laserOut_3ft();
		else							laserOut_safe();
		// delay before checking again to save precious battery life
		osDelay(150);
  }
}

/* USER CODE END 4 */

/* StartDefaultTask function */
void StartDefaultTask(void const * argument)
{

  /* USER CODE BEGIN 5 */
  /* Infinite loop */
  for(;;)
  {
    osDelay(1);
  }
  /* USER CODE END 5 */ 
}

#ifdef USE_FULL_ASSERT

/**
   * @brief Reports the name of the source file and the source line number
   * where the assert_param error has occurred.
   * @param file: pointer to the source file name
   * @param line: assert_param error line source number
   * @retval None
   */
void assert_failed(uint8_t* file, uint32_t line)
{
  /* USER CODE BEGIN 6 */
  /* User can add his own implementation to report the file name and line number,
    ex: printf("Wrong parameters value: file %s on line %d\r\n", file, line) */
  /* USER CODE END 6 */

}

#endif

/**
  * @}
  */ 

/**
  * @}
*/ 

/************************ (C) COPYRIGHT STMicroelectronics *****END OF FILE****/
