trougnouf/SeniorDesign/Schematic/Sensewalk2/Pinout/Pinout.ioc

Mcu.UserName=STM32F746ZGTx
PA0/WKUP.GPIO_Label=UART_TX_Laser
PA0/WKUP.Signal=UART4_TX
PA1.GPIO_Label=UART_RX_Laser
PA1.Signal=UART4_RX
PA10.Signal=DCMI_D1
PA13.Signal=SYS_JTMS-SWDIO
PA14.Signal=SYS_JTCK-SWCLK
PA15.GPIO_Label=SPI1_NSS_Compass
PA15.Signal=SPI1_NSS
PA2.GPIO_Label=ADC_IN2_Mic
PA2.Signal=ADCx_IN2
PA4.Signal=DCMI_HSYNC
PA5.GPIO_Label=SPI_CLK_Compass
PA5.Signal=SPI1_SCK
PA6.Signal=DCMI_PIXCLK
PA7.GPIO_Label=SPI_MOSI_Compass
PA7.Signal=SPI1_MOSI
PA9.GPIO_Label=USART1_TX_Debug
PA9.Signal=USART1_TX
PB10.GPIO_Label=I2C2_SCL_Codec
PB10.Signal=I2C2_SCL
PB11.GPIO_Label=I2C2_SDA_Codec
PB11.Signal=I2C2_SDA
PB12.GPIO_Label=DATA_REQ_Codec
PB12.Signal=GPIO_Input
PB13.Signal=SPI2_SCK
PB14.GPIO_Label=RST_Codec
PB14.Signal=GPIO_Output
PB2.Signal=QUADSPI_CLK
PB3.Signal=SYS_JTDO-SWO
PB4.GPIO_Label=SPI_MISO_Compass
PB4.Signal=SPI1_MISO
PB6.Signal=QUADSPI_BK1_NCS
PB7.GPIO_Label=USART1_RX_Debug
PB7.Signal=USART1_RX
PC0.Signal=FMC_SDNWE
PC1.Signal=SPI2_MOSI
PC12.Signal=SDMMC1_CK
PC13.GPIO_Label=RET_Camera
PC13.Signal=GPIO_Output
PC2.Signal=FMC_SDNE0
PC3.Signal=FMC_SDCKE0
PC4.GPIO_Label=INT_Compass
PC4.Signal=GPIO_Output
PC5.GPIO_Label=TRIG_Compass
PC5.Signal=GPIO_Output
PC6.Signal=DCMI_D0
PC7.GPIO_Label=USART6_RX_BT
PC7.Signal=USART6_RX
PC8.Signal=SDMMC1_D0
PD0.Signal=FMC_D2_DA2
PD1.Signal=FMC_D3_DA3
PD10.Signal=FMC_D15_DA15
PD13.Signal=QUADSPI_BK1_IO3
PD14.Signal=FMC_D0_DA0
PD15.Signal=FMC_D1_DA1
PD2.Signal=SDMMC1_CMD
PD3.GPIO_Label=DCMI_D5_Camera
PD3.Signal=DCMI_D5
PD8.Signal=FMC_D13_DA13
PD9.Signal=FMC_D14_DA14
PE0.Signal=FMC_NBL0
PE1.Signal=FMC_NBL1
PE10.Signal=FMC_D7_DA7
PE11.Signal=FMC_D8_DA8
PE12.Signal=FMC_D9_DA9
PE13.Signal=FMC_D10_DA10
PE14.Signal=FMC_D11_DA11
PE15.Signal=FMC_D12_DA12
PE2.Signal=QUADSPI_BK1_IO2
PE3.GPIO_Label=PWDN_Camera
PE3.Signal=GPIO_Output
PE4.GPIO_Label=DCMI_D4_Camera
PE4.Signal=DCMI_D4
PE5.GPIO_Label=DCMI_D6_Camera
PE5.Signal=DCMI_D6
PE6.GPIO_Label=DCMI_D7_Camera
PE6.Signal=DCMI_D7
PE7.Signal=FMC_D4_DA4
PE8.Signal=FMC_D5_DA5
PE9.Signal=FMC_D6_DA6
PF0.Signal=FMC_A0
PF1.Signal=FMC_A1
PF11.Signal=FMC_SDNRAS
PF12.Signal=FMC_A6
PF13.Signal=FMC_A7
PF14.Signal=FMC_A8
PF15.Signal=FMC_A9
PF2.Signal=FMC_A2
PF3.Signal=FMC_A3
PF4.Signal=FMC_A4
PF5.Signal=FMC_A5
PF6.GPIO_Label=UART7_RX_GPS
PF6.Signal=UART7_RX
PF7.GPIO_Label=UART7_TX_GPS
PF7.Signal=UART7_TX
PF8.Signal=QUADSPI_BK1_IO0
PF9.Signal=QUADSPI_BK1_IO1
PG0.Signal=FMC_A10
PG1.Signal=FMC_A11
PG10.GPIO_Label=DCMI_D2_Camera
PG10.Signal=DCMI_D2
PG11.GPIO_Label=DCMI_D3_Camera
PG11.Signal=DCMI_D3
PG12.GPIO_Label=USART6_RTS_BT
PG12.Signal=USART6_RTS
PG13.GPIO_Label=USART6_CTS_BT
PG13.Signal=USART6_CTS
PG14.GPIO_Label=USART6_TX_BT
PG14.Signal=USART6_TX
PG15.Signal=FMC_SDNCAS
PG4.Signal=FMC_A14_BA0
PG5.Signal=FMC_A15_BA1
PG8.Signal=FMC_SDCLK
PG9.Signal=DCMI_VSYNC
