trougnouf/SeniorDesign/Code/Benoit/SW90004Chad/Src/staConfig.c

#include <stdint.h>



uint8_t staBoardInitPre(int x, int y){


	uint8_t decoderConfig[2013][2]= {
		{0x58,1},
		{0x42,4},
		{0x40,0},
		{0x41,0},
		{0x32,0},
		{0x33,0},
		{0x34,0},
		{0x35,0},
		{0x36,0},
		{0x37,0},
		{0x38,0},
		{0x39,0},
		{0x40,1},
		{0x40,2},
		{0x33,143},
		{0x40,3},
		{0x33,0},
		{0x40,4},
		{0x40,5},
		{0x40,6},
		{0x40,7},
		{0x40,8},
		{0x40,9},
		{0x40,10},
		{0x40,11},
		{0x40,12},
		{0x32,128},
		{0x33,144},
		{0x40,13},
		{0x32,0},
		{0x33,0},
		{0x40,14},
		{0x32,129},
		{0x33,145},
		{0x40,15},
		{0x32,0},
		{0x33,146},
		{0x40,16},
		{0x33,0},
		{0x40,17},
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
	};


	return decoderConfig[x][y];
}

uint8_t staBoardInitPost(int x, int y){
	uint8_t decoderConfigPost[13][2] = {

		{0x84,1},
		{0x85,33},
		{0x7,0},
		{0x6,12},
		{0x11,3},
		{0x80,16},
		{0x81,0},
		{0x82,4},
		{0x97,15},
		{0x100,85},
		{0x101,85},
		{0x5,161},
		{0x24,4},

	};

	return decoderConfigPost[x][y];
}
