trougnouf/SeniorDesign/Code/Benoit/SW90004Chad/Src/staConfig.h

/*
 * staConfig.h
 *
 *  Created on: Mar 21, 2016
 *      Author: mojo jojo
 */

#ifndef APPLICATION_USER_STACONFIG_H_
#define APPLICATION_USER_STACONFIG_H_

	extern uint8_t staConfig;

#endif /* APPLICATION_USER_STACONFIG_H_ */
