trougnouf/SeniorDesign/(commit log)

2015-12-26 Added STM32F7Cube firmware
    [simulation.xls]
2016-01-22 Add Pinout.ioc (STM32CubeMX), update Pinout.txt
2016-01-22 Add STLink/Discovery built-in UART ports
2016-01-31 Laser(UART)-Nucleo pinout, initial struggle
2016-02-05 Getting one clean reading from the laser.
2016-02-05 Getting multiple readings from the laser.
2016-02-05 Copied laser code
2016-02-05 Working laser w/function calls. Needs speedup.
2016-02-05 Finished laser
2016-02-06 Begin work on F030 bareboard
    [F030.cfg]
2016-02-07 Sync - worked on bare MCU
    [SDMin.kicad_pcb, SDMin.sch, _saved_SDMin.sch]
2016-02-07 Clean up directories
    [SDMin.kicad_pcb, SDMin.sch]
2016-02-07 Add Ross' schematic
    [Arduino_MEGA_2560-Rev3.brd, Arduino_MEGA_2560-Rev3.sch, LM2578.sch, LM2597.sch, NCP1200.brd, NCP1200.sch, bq24123.sch, offical board.brd]
2016-02-08 Add STM32L476RET schematic, clean-up folders
    [SDMin.kicad_pcb, SDMin.sch]
2016-02-08 Work on minimal schematic, add power components
    [_saved_SDMin.sch]
2016-02-09 Add schematic for the power subsystem, create all missing components
    [SDMin.sch, _saved_SDMin.sch]
2016-02-13 Add Codec, Bluetooth, debug to minimal schematic
    [SDMin.sch, simulation.xls]
2016-02-17 Add schematic (schematic done, need to draw footprints and design PCB layout)
    [SDMin.sch]
2016-02-17 Add push buttons and battery switch to schematic
    [SDMin.sch]
2016-02-17 Add HW footprints info, minor schematic change (mic)
2016-02-18 Update schematic (add software audio capability, prettier)
    [SDMin.sch]
2016-02-19 sync (minor schematic change)
    [SDMin.sch]
2016-02-19 Assign some footprints to schematic
    [SDMin.sch]
2016-02-20 Update schematic, change compass (LGA->QFN)
    [SDMin.sch]
2016-02-20 Update schematic, order capacitors/resistors/headers and list their size in HW
    [SDMin.sch]
2016-02-21 Finish schematic, finish drawing footprints, associate all parts to footprints, get a reading from the GPS.
    [SDMin.kicad_pcb, SDMin.sch]
2016-02-22 Working on the PCB (third attempt). Misc schematic fixes (charger always on)
    [SDMin.kicad_pcb, SDMin.sch, failureone.kicad_pcb, failuretwo.kicad_pcb]
2016-02-22 Slight progress on PCB attempt 3
    [SDMin.kicad_pcb]
2016-02-23 PCB3 progress: Needs capacitors/resistors and push buttons
    [SDMin.dsn, SDMin.kicad_pcb, three.kicad_pcb]
2016-02-23 Progressing on the PCB. Completed pinout for the standard board.
    [SDMin.kicad_pcb]
2016-02-24 Working on PCB#4, now with FreeRouting
    [SDMin.dsn, SDMin.kicad_pcb, failurefour.kicad_pcb, failurethree.dsn, failurethree.kicad_pcb, failurethree_almostrouted.dsn, failurethree_almostrouted.kicad_pcb, failurethree_fts.dsn]
2016-02-25 Lots of progress on the mPCB
    [02242236.kicad_pcb, SDMin.dsn, SDMin.sch, SDMin10.dsn, SDMin11C.dsn, SDMin12.dsn, SDMin2.dsn, SDMin3c.dsn]
2016-02-26 PCB svg render
    [SDMin.kicad_pcb, SDMin26.dsn, noname26.kicad_pcb]
2016-02-29 Ordered PCB. Making no progress on the compass.
    [SDMin-B.Cu.gbl, SDMin-B.Mask.gbs, SDMin-B.SilkS.gbo, SDMin-Edge.Cuts.gm1, SDMin-F.Cu.gtl, SDMin-F.Mask.gts, SDMin-F.SilkS.gto, SDMin-NPTH.drl]
2016-02-29 Bedsync. Compass: applied a NSS/CS fix found on a forum, still no progress.
    [Compass.ioc, main.c, mxconstants.h]
2016-02-29 Update standard board pinout
    [Arduino_MEGA_2560-Rev3.brd, Arduino_MEGA_2560-Rev3.sch, LM2578.sch, LM2597.sch, NCP1200.brd, NCP1200.sch, bq24123.sch, offical board.brd]
2016-03-09 sync: trying to translate the magnet readings
2016-04-13 Merging the things (Desktop)
    [Sensewalk9000.cfg, Sensewalk9000E.cfg]
2016-04-16 Laser cutter cad file for Sensewalk 9000
    [SDMin.sch, sensewalk9000-acrylic.dxf, stm32l4.cfg]
2016-04-16 Sensewalk 9000 development (vibrator, laser, sd), worked on GPS with Diego
    [GPS-ewarm.ioc, SW9000.ioc, SW90004Chad.ioc, bsp_driver_sd.c, bsp_driver_sd.h, compass.c, fatfs.c, ffconf.h]
2016-04-17 Started work on compass w/ vibration and interrupt, starting STM32F7 board
    [SW9000 - allDevices.ioc, SW9000.ioc, bsp_driver_sd.c, bsp_driver_sd.h, fatfs.c, ffconf.h, main.c, mxconstants.h]
2016-04-19 Add presentation and Ross' board
    [offical board.brd, offical board.sch]
2016-04-29 Fixed GPS code for Diego to graduate
    [SW9000GPS.ioc, SW9000GPS2.ioc, main.c, mxconstants.h]
2016-04-29 Organize files
    [02242236.kicad_pcb, Arduino_MEGA_2560-Rev3.brd, Arduino_MEGA_2560-Rev3.sch, LM2578.sch, LM2597.sch, NCP1200.brd, NCP1200.sch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]
